how2idealizefreedom/electric-car-ball-balance/README.md

# 2026 全国大学生电子设计竞赛 H 题 · 车载平衡滚球运动控制系统

基于 **TI MSPM0G3507** 的竞赛项目：小车沿黑线循迹并计时返回起点，同时通过倾斜摆杆使钢球在平台上保持稳定或完成指定位移。

## 系统组成

```
┌────────────┐   UART    ┌──────────────┐  STEP/DIR  ┌─────────────┐
│  K230 视觉  │ ────────▶ │  MSPM0G3507  │ ─────────▶ │  A4988 + 42 │
│ (GC2093)   │  球位置/速度 │   主控/状态机  │            │  步进摆杆   │
└────────────┘            └──────┬───────┘            └─────────────┘
                                 │ PWM/IN/STBY
                        ┌────────▼─────────┐
                        │  D24A (TB6612×2) │ ──▶ 四轮差速底盘
                        └──────────────────┘
                        八路灰度循迹 · 四按键 · OLED · CH340 遥测
```

## 目录结构

```
.
├─ docs/                    文档与报告
│   ├─ 设计报告.pdf / .tex / .docx        正式设计报告
│   ├─ 当前算法说明_配图版.pdf
│   ├─ 电赛资料/              选拔赛设计报告、测试报告、仿真图
│   └─ dev-notes/             技术决策与开发记录（见下）
├─ firmware/                 CCS 固件工程（MSPM0G3507 + SysConfig）
│   ├─ H2_天猛星_路线记忆与步进/         当前主工程：循迹 + 示教回放 + 步进点动
│   ├─ H2_地猛星_循迹主线/               22:44 稳定 P1 基线与 P0~P2 测试文档
│   ├─ H2_地猛星_弯道测试/               内弯恢复实验副本
│   ├─ H2_天猛星_循迹备用/               天猛星 P1 迁移底座
│   ├─ H2_地猛星_球平衡步进/  H2_天猛星_球平衡步进/   A4988 安全 bring-up
│   ├─ 10_直流电机PID调速模板/ 11_PID循迹小车模板/     DriverLib 模板
│   └─ 4_地猛星_红外传感器测试/           四路/八路红外测试
├─ mechanical/               摆杆与舵机装配三维模型
├─ hardware/                 底盘、电机驱动、传感器、拓展板、PCB 资料
├─ tools/                    串口调试等辅助工具
├─ LICENSE                   MIT
└─ .gitignore
```

## 硬件平台

| 模块 | 型号 |
| --- | --- |
| 主控 | TI MSPM0G3507（天猛星 LQFP-64 / 地猛星 LQFP-48） |
| 电机驱动 | WHEELTEC D24A（板载 2× TB6612FNG） |
| 行走电机 | MG310 直流减速电机 + 霍尔编码器（13 PPR，1:20） |
| 循迹 | 8 路红外数字灰度板 |
| 摆杆执行 | 42BYGH23-A-21DH 两相四线步进 + A4988 恒流驱动 |
| 视觉 | 立创庐山派 K230-CanMV + GC2093 |
| 姿态 | MPU6050 |
| 显示 | 0.96 寸 OLED（I2C） |
| 调试 | CCS 20.5 + XDS110 + 板载 CH340（115200） |

## 固件说明

所有工程均为 TI MSPM0 SDK + SysConfig 的 CCS 工程，`empty.syscfg` 是唯一有效的引脚 / 外设配置源，**不要手改 SysConfig 生成的文件**。

主工程 `firmware/H2_天猛星_路线记忆与步进/`：

- 八路灰度加权误差 → 差速 PD 循迹；
- 首圈人工示教（K2/K3）+ RAM 路线记录，回放以记忆为主、P1 小纠偏；
- A4988 步进点动 / 加减速 / 软件限位 / HOME，默认上电强制禁能；
- 5 ms 控制节拍（TIMA0）+ 100 µs 步进节拍（TIMG8）；
- 100 ms 串口遥测 `T,S,M,E,L,R`。

## 文档索引

| 文档 | 内容 |
| --- | --- |
| `docs/dev-notes/开发记录与技术决策.md` | 题目指标、硬件清单与确认状态、引脚分配、供电与电平安全、循迹算法与参数、开发时间线、验证状态、已放弃方案、未解决问题、工程约束 |
| `docs/dev-notes/HARDWARE_INTEGRATION_AND_NEXT_STEPS.md` | 硬件集成接线结论、引脚预留、供电拓扑、第 3~6 问控制路线 |
| `docs/dev-notes/STEPPER_ARCHITECTURE_DECISION.md` | 步进摆杆执行机构选型决策、控制路线、机械建议 |
| `docs/dev-notes/DUAL_CCS_BUILD_STATUS.md` | 双平台构建状态 |
| `firmware/*/TIANMENG_WIRING_AND_TEST.md` 等 | 各工程接线与分阶段测试说明 |

> 文档中严格区分**已实车验证**、**已构建未实板**、**仅理论设计**、**未开始**四种状态，没有实测证据的内容不写成事实。

## 如何编译 / 运行

1. 安装 [Code Composer Studio](https://www.ti.com/tool/CCSTUDIO) 20.5 及以上版本与 MSPM0 SDK `2.11.00.07`。
2. `File → Import → CCS Projects`，选择 `firmware/` 下对应工程目录。
3. 按工程内的 `P0_TEST_GUIDE.md` → `P2_FINAL_LAP_TEST.md`（地猛星基线）或 `MEMORY_STEPPER_TEST.md`（天猛星步进）依次完成接线与分阶段测试。

**上电安全顺序**：先 MCU 单独上电并确认 STBY / ENABLE 安全电平 → 再接 A4988 → 最后接 D24A 并架空四轮。

## 说明

- 为控制仓库体积，视频（`*.mp4` 等）、压缩包与编译产物已被 `.gitignore` 排除，仅保留在本地。
- 本仓库用于学习与技术交流；竞赛作品知识产权归作者所有，转载请注明出处。
- 代码采用 MIT License，详见 `LICENSE`。
