how2idealizefreedom/electric-car-ball-balance/firmware/H1_H5_TIANMENG/README.md

# H1_H5_TIANMENG

本工程是立创·天猛星 MSPM0G3507（LQFP-64/PM）+ 外接 D24A 的 1—5 问集成工程。它独立于 `H2_LINE_CAR` 和 `H2_TIANMENG_MEMORY_STEPPER`，不会覆盖 22:44/P1 稳定基线。

## 当前原则

- 小车主控制仍为已获实车正反馈的八路循迹 P1/PD，不使用按时间分赛段，也不使用地图记忆回放。
- 上电默认进入 Q1；Q1 不使能 D24A 或 A4988，避免意外按键导致车辆启动。
- 逻辑 K4（模式键）现在使用扩展板板载 KEY2/PB11；每按一次按 Q1→Q2→Q3→Q4→Q5→Q1 切换，只允许在非运行状态切换。
- K1 启动/停止当前题目。Q1 再按一次正常结束；Q2—Q5 运行中再按一次进入故障安全停机。
- K2/K3 仅在 Q3 非运行状态下执行 A4988 ±20 微步维修点动；两键同时按关闭 A4988。
- A4988 的 10 kHz 中断只在确有步进运动时启用，空闲及 Q2 循迹时关闭；CONTROL_TICK 优先级 0，STEPPER_TICK 优先级 2。
- D24A电机映射为A=右后、B=右前、C=左前、D=左后。2026-07-31架空实测确认B/C向前而A/D反向，因此后轮A/D必须在控制端交叉IN1/IN2；不修改已经正确的左右侧软件方向极性。

## 各题当前状态

| 模式 | 目标 | 当前代码状态 | 是否允许执行器运行 |
|---|---|---|---|
| Q1 | 图像实时显示、记录与回放 | 状态机及串口事件已建立；K230 WiFi 图传由 K230 独立运行 | 小车/步进均关闭 |
| Q2 | 顺时针一圈、回 A 停车、计时 | P1 稳定循迹与 A 点横线停车逻辑已集成 | 允许，待天猛星实车验证 |
| Q3 | O→+5 cm→-5 cm，≤5 s | 顺序状态机与外环接口已写；视觉协议及机械标定未完成 | 当前 `BLOCKED` |
| Q4 | A→B，≤8 s，球保持 O±1 cm | 循迹+球外环调度已写；B 点判据未实现 | 当前 `BLOCKED` |
| Q5 | 一圈≤30 s，球保持 O±1 cm | 循迹+球外环+A 点停车调度已写 | 当前 `BLOCKED` |

Q3—Q5 的门控宏位于 `car_config.h`。禁止为了“先跑起来”直接改为 1；必须先实现对应驱动/协议并完成单模块验证。

## 显示屏状态

`display.c` 已实现 0.96 寸 SSD1306 128×64 I2C 后端。引脚按扩展板原理图使用 I2C0：PA28/SDA、PA31/SCL，SysConfig 配置为 400 kHz。上电会依次探测 7 位地址 `0x3C` 和 `0x3D`，成功后显示题号、题名、状态和时间；失败时保留串口提示，不阻塞小车状态机。2026-07-31 用户反馈第一次屏幕/模式键测试“完美”，因此这部分已有实板证据。

OLED 刷新被拆成每个 5 ms 控制周期最多发送一页（128 字节），不在一次控制周期内整屏阻塞发送。

## K230 串口状态

- 用户程序使用 K230 `GPIO3/UART1_TXD`、115200 8N1。
- 帧格式固定为 `$B,valid,x,err_x,vx,lost\n`；位置、误差为像素，速度为像素/帧。
- MSPM0 使用扩展板 UART1 四针座的 PB7/RX 接收；PB6/TX 保留但初测不连接。CH340 仍独占 UART0 PA10/PA11。
- UART ISR 只将单字节写入 128 字节环形缓冲；解析在 5 ms 控制任务执行。
- 原始遥测字段为 `K230/BV/BX/BE/BVX/BL/BSEQ`。尚未完成像素到毫米及像素/帧到毫米/秒标定，因此原始数据不会写入钢球位置外环。

## 构建结论

- CCS：20.5.0，TI Arm Clang 4.0.4.LTS
- MSPM0 SDK：2.11.00.07
- SysConfig：1.26.2+4477
- `check_syscfg.py`：通过；初次检查时因尚未构建而提示缺生成文件/输出文件
- `run_sysconfig.py`：通过；仅有 TIMA0 在 STOP/STANDBY 不保持寄存器的提示，本程序不进入这两种模式
- CCS 工程 `clean all`：通过，无编译器诊断
- 最终验证文件：`verified_build/H1_H5_TIANMENG.out`
- Flash：0x41E8（16872 B）；SRAM：0x8BC（2236 B，含 OLED 显存、UART缓冲和512 B栈）

以上仅表示静态检查和构建通过，尚未烧录，也没有天猛星实车验证。

## 关键文件

- `main.c`：Q1—Q5 状态机、P1 循迹、按键、计时、停车、遥测和按需步进中断
- `car_config.h`：稳定循迹参数、能力门控和待标定球控参数
- `empty.syscfg`：当前唯一引脚/外设配置源
- `a4988.h`：步进脉冲、速度斜坡、限位和点动底层
- `ball_feedback.*`：K230 ASCII帧环形缓冲、解析、原始像素数据快照，以及未来毫米标定后的球反馈接口
- `ball_controller.*`：球位置外环到摆杆角度/步数的接口；参数当前保持安全零值
- `display.*`：SSD1306 I2C 驱动、字库、分页刷新和应用显示接口
- `mpu6050.*`：已有基础探测驱动，默认不在启动时探测；当前与 OLED 共用 I2C0 实例名，但扩展板 MPU6050 实际 PA10/PA11 接法尚未并入
- `PHASED_TEST_PLAN.md`：接下来必须按顺序执行的测试

## 2026-08-01 球轴与视觉新增事实

- OpenMV 型号为 `OPENMVCAMH7PLUS / OpenMV Cam H7 Plus`，STM32H743，固件 4.7.0；当前程序使用 VGA 640×480、UART3/P4 TX、115200 8N1。
- 用户当前 OpenMV 脚本发送 `K230=1,BV=...,BX=...,BE=...,BVX=...,BL=...,BSEQ=...`。接收端现同时兼容该格式和原 `$B,V,X,E,VX,LOST` 格式，且像素范围扩展为 VGA。
- 初测比例为 26.5 px/cm，中心 `ZERO_X=320`；该值只作初始换算，必须完成 -5/0/+5 cm 三点复测后才能解除 `BALL_AXIS_CALIBRATED`。
- 球轴最低点暂定 HOME=0，实测水平点为 +320 微步。PB3 HOME 自动回零逻辑已预置，但 `A4988_AUTO_HOME_READY=0`，在开关和供电验证前不会上电运动。
- 扩展板原理图将板载 12 V→5 V 降压输出与主控 5 V 母线直接连接，未显示USB与电池5 V之间的隔离。调试时禁止把两路5 V长期并联；必须先解决电池冷启动和电源开关不稳定。
