how2idealizefreedom/electric-car-ball-balance/firmware/H2_地猛星_循迹主线/HARDWARE_NOTES.md

# D24A 与 MSPM0G3507：P0 接线结论

## 当前供电接法

以下拓扑可用于桌面开发：

```text
电脑 USB ──> MSPM0G3507 开发板

12 V 锂电池 + ──> D24A Vin+
12 V 锂电池 - ──> D24A - / GND

MSPM0 GND ──────> D24A GND
```

必须遵守：

- MSPM0 由 USB 供电时，D24A 的 `5V` 和 `3V3` 输出均不要接到 MSPM0 的电源针脚，防止两个电源互相倒灌。
- 共地线必须连接，但电机大电流回路应直接回到电池负极；不要让电机电流经过面包板或 MCU 的细地线。
- 首次测试先断开四个电机插头或架空四轮，D24A 开关保持 `OFF`，`STBY` 保持低电平。
- 当前测得电池电压为 `12.14 V`；低于 TB6612 推荐 VM 上限 `13.5 V`。仍需注意电机制动产生的母线尖峰。
- D24A 板载 `5V-GND`、`3V3-GND` 已由万用表确认输出正常，但尚未记录精确电压值。

## 为什么控制线暂时不能直连

D24A 原理图显示两颗 TB6612 的 `VCC` 接板载 `5V`。TB6612 数据手册规定控制输入高电平最小值为 `0.7 * VCC`，在 VCC=5 V 时即 3.5 V。MSPM0 的 3.3 V 输出低于这个保证值。

正式控制线需要 13 路 3.3 V -> 5 V 转换：

- `STBY`
- `AIN1/AIN2/PWMA`
- `BIN1/BIN2/PWMB`
- `CIN1/CIN2/PWMC`
- `DIN1/DIN2/PWMD`

合计为 13 路（1 + 4 x 3），因此可选用两片 8 路、5 V 供电且输入具有 TTL 阈值的缓冲器/总线收发器，例如合适封装的 `74AHCT541` 或 `74HCT245`。器件的方向/使能脚必须固定到正确状态，不能悬空。购买前把具体模块链接或数据手册发来核对。

用户描述的“12 V 输入、输出 0～12 V 可调”模块属于 DC-DC 降压电源，只能用于产生稳定电源，不能转换数字逻辑电平，也不能接到 `PWM/IN/STBY/Encoder` 信号线上。

## 编码器线也需先确认

D24A 的四个电机插座向霍尔编码器提供板载 `5V`，并引出 `E1A/E1B ... E4A/E4B`。在没有确认霍尔输出结构前，不得把这些信号直接接 MSPM0：

- 如果是 5 V 推挽输出，需要 5 V -> 3.3 V 转换；
- 如果是开漏/开集输出，可考虑上拉到 3.3 V，但必须先由手册或万用表验证；
- 如果编码器本身允许 3.3 V 供电，仍需按电机资料确认最低工作电压和输出波形。

当前电机资料：`MG310`，霍尔编码器允许 `3.3 V` 或 `5 V` 供电，标称 `13 PPR`，减速比 `1:20`。如果 13 PPR 指电机轴单通道脉冲数，则输出轴每转：

- 单通道单边沿约 `13 x 20 = 260` 个计数；
- A 相双边沿约 `520` 个计数；
- A/B 完整四倍频约 `1040` 个计数。

供应商的 PPR 口径可能不同，最终必须用“车轮手动转一整圈”的实测计数标定，不能仅凭 13 PPR 写死里程系数。

为了避免 5 V 编码器信号进入 MCU，优先方案是将四个编码器供电改为 3.3 V，再确认 A/B 高电平不超过 3.3 V。D24A 电机插座的编码器电源脚在原理图上固定为 5 V，因此若采用此方案，需要把线束中的编码器 VCC 脚单独退针/改线到 3.3 V，不能把 D24A 的 5 V 与 3.3 V 短接。

## 八路灰度输入

- 模块可使用 3.3 V 或 5 V 供电；本项目固定优先使用 `3.3 V`，降低 MCU 输入过压风险。
- 最新逐项直接测试确认模块为 **白底低、黑线高**。先前根据运动过程中的 `M=231` 位型反推极性，因当时探头覆盖场景不明确而作废。
- 固件不取反，内部位图和串口 `M` 始终保持 `1=黑线`；白底应为 `M=0`，中央 S4/S5 压线应为 `M=24`。
- 连接 MCU 前仍应确认八个输出通道的高电平不超过 3.3 V。

## 已确认的电机位置映射

| D24A 通道 | 车辆位置 | 逻辑分组 |
|---|---|---|
| Motor A | 右后 RR | 右侧 |
| Motor B | 右前 FR | 右侧 |
| Motor C | 左前 FL | 左侧 |
| Motor D | 左后 RL | 左侧 |

## 下一批需要的资料/实测

1. MG310 的购买链接或完整数据页，补充额定电压、额定/堵转电流，以及“13 PPR”是单通道、双边沿还是四倍频口径。
2. 编码器 A/B 输出电路类型（推挽或开漏）；若没有资料，按下文要求实测输出。
3. 拟购买的真正逻辑转换模块链接或清晰正反面照片。常见 BSS138 I2C 小板和可调降压模块均不适合本项目的电机控制信号。
4. 灰度板八个数字输出在白底和黑线上的逐通道检查结果。
5. 开发板完整原理图或电源说明，用来确定脱离电脑后应从 5 V 针脚还是其他入口供电。
