how2idealizefreedom/electric-car-ball-balance/hardware/天猛星拓展板/（首先看这里）文件说明.txt

01：原理图；
02：平面图
03：PCB图
04：Gerber.zip 嘉立创打板文件
使用方法：在嘉立创下单助手上导入，自主下单，2层板，10cm*10cm（下单文件 不能导入嘉立创EDA）
照着物料清单在淘宝上购买器件。

04：源文件，嘉立创专业版导入，导入！！！！（PLUS款才有，基础款没有，需要去咸鱼搜索：遇到困难睡大觉zxz 购买正版源文件，可提供售后指导及详细使用和修改指导）（需要售后服务的在咸鱼购买后主动将微信发给我，在微信售后（方便一些））
