how2idealizefreedom/electric-car-ball-balance/firmware/H2_地猛星_球平衡步进/BALL_CONTROL_INPUTS_NEEDED.md

# 第三至第六问：滚球控制接入清单

## 已确认舵机

- 型号：MG996R，180 度位置舵机。
- 供电：4.8～6.6 V；棕线 GND、红线电源正、橙线 PWM 信号。
- 控制：50 Hz，周期 20 ms；资料给出的脉宽范围为 0.5～2.5 ms，中位约 1.5 ms。
- 暂定信号引脚：PA27（可分配独立定时器 PWM），最终仍以加入摄像头、显示屏和按键后的 SysConfig 无冲突验证为准。

## MG996R 供电要求

不要从 MSPM0 开发板的 5 V 或 3.3 V 引脚给 MG996R 供电。建议链路：

`12 V 电池 -> 独立降压模块（调到 5.5～6.0 V）-> MG996R 红线`

- 降压模块建议至少能承受 3 A 连续、5 A 瞬时电流，并在输出端就近放置 470～1000 uF 电解电容和 0.1 uF 陶瓷电容。
- 舵机棕线、降压模块负极、D24A GND、MSPM0 GND 必须共地。
- 舵机橙线只接 PWM 信号，不接电源。正式接入前先卸下舵盘或断开连杆，验证 1.5 ms 中位不会撞机械限位。
- 3.3 V PWM 多数 MG996R 可识别，但不同批次不应盲目保证；若已有 74HCT125 等非反相 TTL 缓冲器，可用于输出 5 V 控制电平。使用 74HCT14 时需要串联两个反相门，不能只过一个门。

## 仍需你提供的资料

1. 舵机降压模块正反面照片、芯片丝印、额定/峰值输出电流，以及空载调到的实际输出电压。
2. 实物机构侧视图：舵机轴、舵盘孔位、连杆两个转轴和摆杆铰链都要清楚；同时量出舵盘有效半径、连杆孔距、摆杆铰链到驱动点距离。
3. 摆杆水平时的舵机大致角度，以及机构允许的最小/最大角度；不要通电硬顶限位。
4. 钢球位置摄像头/图传模块的准确型号、接口、供电和资料。滚球闭环必须由摄像头实时给出钢球坐标，单靠舵机开环达不到 ±1 cm。
5. 不大于 2 英寸显示屏的型号、控制器、接口和引脚图。
6. 准备使用的按钮数量；建议 START/STOP、MODE、PLUS、MINUS 四个。

## 后续控制结构

摄像头计算钢球相对目标位置的误差，通过 UART 周期性发给 MSPM0。MSPM0 在固定周期执行滚球位置 PID/状态反馈，输出 MG996R 的目标脉宽并限制角度、速度和加速度。第三问按 `0 cm -> +5 cm -> -5 cm` 状态机运行；第四、五问目标固定为 0 cm；第六问目标由按键选择并显示。

MPU6050 只能用于补偿车体加速度和摆杆姿态，不能代替题目明确要求的摄像头钢球位置检测。
