how2idealizefreedom/electric-car-ball-balance/docs/dev-notes/CODEX_THREAD_HANDOFF.md

# CODEX 线程项目交接材料

> 生成时间：2026-07-31（本线程结束时）。
>
> 本文只整理本线程的用户陈述、工程文件、构建记录和串口/实车反馈。`已实车验证`、`已构建`、`已设计`、`TBD` 严格分开；没有证据的内容不写成事实。本文件不替代题目、器件数据手册或现场安全检查。

## 1. 项目背景与竞赛任务

- 题目：2026 年“车载平衡滚球运动控制系统”H 题。
- 当前第一优先级曾明确为第 2 问：小车置于 A 点，按键启动，沿黑线顺时针行驶一圈，回到 A 点自动停车、停止计时并显示总时间。硬指标为总时间 `<=20 s`、停车偏差 `<=2 cm`。
- 赛道参数来自根目录 `AGENTS.md` 对题目 PDF 的摘录：黑线宽 `1.8±0.2 cm`；AB、CD 直线各 `1.5 m`；BC、DA 为半径 `0.5 m` 的半圆；A 点启停线长 `5 cm`；车辆最大外形 `35 cm × 25 cm`；显示屏不得大于 `2 英寸`。中心线路程估算约 `6.14 m`。
- 后续第 3～6 问的用户截图要求包括：摆杆将小球在中心 O 与 `±5 cm` 间运动并稳定；经 B 点/一圈过程中钢球稳定在中心或指定位置附近，误差绝对值 `<=1 cm`，有关行驶项目时间上限为 `8 s` 或 `30 s`（以题目原文为最终准则）。
- 当前实际工作方向已从地猛星切换为：**天猛星 MSPM0G3507 + 外接 D24A + 八路灰度 + 42 步进/A4988 预留**。用户明确表示放弃继续调试地猛星的 curve 版本。

当前已知平台：

- 主控：立创·天猛星 MSPM0G3507，当前有效工程声明 `LQFP-64(PM)`。
- 底盘：四轮直流电机小车，D24A 四路 TB6612 驱动板，八路红外灰度循迹板。
- 调试：CCS、XDS110、板载 CH340 串口（115200）。
- 后续球控：K230-CanMV + GC2093 摄像头、Wi-Fi/MJPEG 手机浏览器图传、0.96 英寸屏、MG996R 舵机方案曾安装；当前尝试 42BYGH23-A-21DH + A4988 方案。

## 2. 总体技术思路

系统应拆成下列可独立验证的部分；其中标为“设计”的项目不代表已完成。

| 子系统 | 目标与思路 | 当前状态 |
|---|---|---|
| 循迹小车 | 八路传感器读出黑线位图，按加权误差进行左右差速 PD；在当前天猛星新工程中另加首圈示教/时间回放与 P1 小纠偏。 | 地猛星 P1 曾实车可循迹；天猛星记忆版仅构建。 |
| 四电机驱动 | D24A 的 A+B 作为右侧组、C+D 作为左侧组；两侧同 PWM/方向组控制。 | D24A 与分组定义、早期车轮方向测试有实测反馈；天猛星接线尚待实板。 |
| 红外循迹 | 传感器以 1 表示黑线；S1～S8 加权得到误差。 | 白底/黑线极性用户已直接实测；天猛星引脚已配置但未实板。 |
| 编码器与轮速闭环 | 未来读取霍尔 A/B，标定每轮计数，左右轮速 PI 抵抗电压和负载变化。 | 未接入当前有效代码；计数口径、输出电平、轮速 PI 均 TBD。 |
| A 点识别与停车 | 宽黑线候选 + 起点离开/最短运行时间门控 + 短刹/禁能；以后应叠加里程或航向。 | 22:44 基线源码已实现简化宽线检测、最短 6 s、220 ms 短刹；停车误差未达标证明。 |
| 显示与计时 | 车载屏实时/锁存显示时间、状态。 | 0.96 寸屏已提供照片；未接线、未写驱动。 |
| 摆杆执行机构 | 通过舵机或步进电机改变摆杆姿态。当前步进方案应先 HOME、点动、标定机构几何。 | MG996R 方案存在；42BYGH23 + A4988 的点动代码已构建，未实板。 |
| 钢球视觉检测 | K230 采集 GC2093 图像，提取钢球中心、相对位置/速度，向 MSPM0 发送 TTL UART 数据。 | 用户称 Wi-Fi 图传已跑通、K230 方案已能输出小球位置/速度；实际 UART 数据帧和 MSPM0 接收未实现。 |
| 钢球位置外环 PID | K230 的球位置/速度形成外环，输出摆杆目标；步进/舵机形成内层执行。 | 仅理论路线，未实现。 |
| 图传与录像 | K230 通过 RTL8189FTV 接 2.4 GHz 手机热点，MJPEG 浏览器显示/手机录屏。 | 用户称已跑通；未在本工程验证。 |
| 最终合并 | 先稳定底盘/停车，再独立摆杆 HOME 与闭环，再合并视觉球控；合并时限制执行器、掉线安全停机。 | 未开始。 |

## 3. 开发环境与工程结构

### 已观察到的开发环境

| 项目 | 实际记录/路径 | 状态 |
|---|---|---|
| CCS | `G:\ti\ccs2050\ccs`；文档中记录为 CCS 20.5。 | 本地安装路径已用于编译器。 |
| MSPM0 SDK | `C:\TI\mspm0_sdk_2_11_00_07`，版本 `2.11.00.07`。 | SysConfig/编译记录已使用。 |
| SysConfig | `C:\TI\sysconfig_1.26.2\sysconfig_cli.bat`，版本 `1.26.2+4477`。 | 当前天猛星工程检查通过。 |
| TI Arm Clang | `G:\ti\ccs2050\ccs\tools\compiler\ti-cgt-armllvm_4.0.4.LTS\bin\tiarmclang.exe`。 | 当前天猛星记忆工程已编译链接。 |
| XDS110 | `targetConfigs\MSPM0G3507.ccxml` 声明 TI XDS110。 | 未在本次天猛星记忆工程执行探针/烧录。 |
| 串口 | 板载 CH340，当前天猛星 SysConfig 为 UART0：PA10 TX、PA11 RX、115200。 | 地猛星阶段用户已使用 CH340 观察串口；天猛星记忆版尚未实板。 |

### 主要目录

| 路径 | 角色 |
|---|---|
| `outputs/H2_TIANMENG_MEMORY_STEPPER/` | 当前应优先继续的天猛星一体化 CCS 工程。 |
| `outputs/H2_LINE_CAR/` | 地猛星 LQFP-48 的 22:44 左右 P1 稳定基线与历史测试文档；用户已放弃作为当前硬件路线。 |
| `outputs/H2_LINE_CAR_CURVE_TEST/` | 地猛星内弯恢复/强制找线实验副本；未宣称实车通过。 |
| `outputs/H2_LINE_CAR_TIANMENG/` | 天猛星 P1 迁移底座，未实板。 |
| `outputs/H2_LINE_BALL_STEPPER_DIMENG/`、`outputs/H2_LINE_BALL_STEPPER_TIANMENG/` | A4988 早期安全 bring-up 工程，历史参考。 |
| `outputs/*.zip` | 历史工程压缩包，非当前源码真源。 |
| `work/` | 临时 SysConfig/本机构建工作目录，不是 CCS 工程交付真源。 |
| `outputs/H2_TIANMENG_MEMORY_STEPPER/Debug/` | 从底座复制的旧生成产物，含旧工程名 `.out`；文档明确禁止烧录这些旧 `.out`。 |
| `outputs/H2_TIANMENG_MEMORY_STEPPER/verified_build/` | 由本线程命令行验证产生的当前 `.out/.map`，不是 CCS IDE 自动生成目录。 |

### 当前天猛星工程关键文件

| 文件 | 作用 |
|---|---|
| `empty.syscfg` | 唯一有效的引脚/外设配置源。 |
| `main.c` | 车辆状态机、P1、示教/回放、按键、串口遥测。 |
| `car_config.h` | 当前天猛星记忆/步进参数。 |
| `track_memory.c/.h` | RAM 路线记录与读取。 |
| `a4988.h` | A4988 脉冲、加减速、位置/HOME 限制。 |
| `mpu6050.c/.h` | MPU6050 底层文件；`MPU6050_BOOT_PROBE=0`，启动不探测。 |
| `TIANMENG_WIRING_AND_TEST.md` | 天猛星/D24A/灰度/按键接线说明。 |
| `A4988_WIRING_AND_TEST.md`、`MEMORY_STEPPER_TEST.md` | A4988 与示教回放分阶段测试。 |
| `BUILD_STATUS.md` | 静态检查/构建结论及旧 Debug 警告。 |

## 4. 已确定的硬件

| 器件 | 型号/描述 | 用途 | 电压/接口 | 当前确认状态 | 尚未确认的信息 |
|---|---|---|---|---|---|
| 主控开发板 | 天猛星 MSPM0G3507，当前工程为 LQFP-64(PM) | 现行主控 | GPIO、UART0、I2C0、TIMG0/TIMA0/TIMG8 | 工程 `empty.syscfg` 已配置；未对当前工程实板。 | 天猛星最终脱机供电与扩展板全部接线的实测。 |
| 历史主控 | 地猛星 MSPM0G3507，LQFP-48(PT) | 旧基线 | 同芯片不同板级引脚 | 用户纠正过 PA14 板载 LED；该路线已放弃。 | 不应再作为当前引脚依据。 |
| 四路驱动板 | WHEELTEC D24A，板上两颗 TB6612FNG | 驱动四轮、提供编码器接口/稳压输出 | Vin 5.5–15 V（文档摘录）；PWM/IN/STBY | 用户测 12 V 电池 12.14 V；D24A 5 V-GND、3V3-GND“正常”；四电机接法已提供。 | 3.3 V GPIO 到 5 V 逻辑的可靠性结论存在冲突，见第 15 节；天猛星实接未验证。 |
| 行走电机/编码器（早期资料） | MG310，霍尔编码器，PPR 13、减速比 1:20 | 四轮行走与未来速度反馈 | 编码器称可 3.3/5 V | 用户提供的文字信息。 | 与后续 MG513XP28_12V 标签冲突；电机额定/堵转电流、PPR口径、输出结构未确认。 |
| 行走电机（后续照片） | WHEELTEC `MG513XP28_12V` | 照片中的带编码器电机 | 12 V 标签；6P线束 | 用户上传照片有该丝印。 | 是否替代 MG310、减速比、PPR、电平未确认。 |
| 灰度模块 | 8 路红外数字循迹板，准确商家型号未知 | 黑线检测 | 采用 3.3 V供电；8 GPIO | 用户直接测试：白底输出 0、黑线 3.3 V；白底 M=0、S4/S5 黑线 M=24。 | 探头间距、完整数据手册、各通道高电平实测未存档。 |
| CH340 | 天猛星板载 USB-UART | 串口调试 | UART0 PA10/PA11，115200 | 地猛星阶段用户能看到串口；天猛星工程已配置。 | 天猛星当前 USB 串口端口号/实测输出。 |
| XDS110 | 外置下载器 | SWD 下载/调试 | ccxml 指向 TI XDS110 | 用户拥有；工程目标配置存在。 | 当前天猛星实际连接/探针枚举未记录。 |
| 舵机 | MG996R | 早期摆杆方案 | 4.8–6.6 V，PWM约20 ms | 用户提供参数、已安装过舵机/机构。 | 舵机降压模块、电流、机械零位、连杆几何、最终是否弃用。 |
| 步进电机 | `42BYGH23-A-21DH`，NEMA17 类四线双极型推定 | 当前替代摆杆执行器候选 | A4988恒流驱动 | 用户测两组线圈各约4.1 Ω；已有 A4988 照片；已有 STEP/3MF 机构文件。 | 额定相电流、实际机构负载、最终步距/微步与杆端位移关系、HOME。 |
| 步进驱动 | A4988 小板，照片见 R100 | 驱动42步进 | VMOT 12 V、VDD 3.3 V、STEP/DIR/EN | 安全点动软件/接线文档已写、编译。 | VREF未实调、散热/限流/点动未实板。 |
| 摄像头/视觉板 | 立创·庐山派 K230-CanMV + GC2093（CSI2） | 球心检测、图传 | K230 逻辑 5 V；对 MSPM0 拟用 3.3 V TTL UART | 用户称 K230 Wi-Fi 图传已跑通，能给球位置/速度。 | UART 帧格式、速率、MSPM0 收发引脚、球检测精度/延迟未确认。 |
| Wi-Fi/录像 | RTL8189FTV、手机热点、浏览器 MJPEG、手机录屏 | 图传/录像 | 2.4 GHz | 用户陈述已跑通。 | 未在工程文件中集成。 |
| 显示屏 | 0.96 英寸 OLED（照片丝印 SMD?，控制器不明） | 比赛显示时间/状态 | TBD（通常 I2C 仅为常识，不作为结论） | 用户提供照片，尺寸符合 <=2英寸。 | 控制器、针脚、供电、实际接口、代码未确认。 |
| 按键板 | 4个轻触按键 K1–K4，共 GND | 启动/辅助/模式 | 低有效、每键有0.1uF（用户原理图） | 用户提供实物和原理图；当前天猛星已为 K2/K3/K4配 GPIO。 | 尚未按当前引脚完成实接。 |

## 5. 固定引脚与外设分配

本节只以当前有效 `outputs/H2_TIANMENG_MEMORY_STEPPER/empty.syscfg` 和该目录参与构建的 `main.c/a4988.h/car_config.h` 为主。除表中“保留”外，未列 GPIO 均不应自行占用。

| 类别 | 天猛星管脚/外设 | 功能 | 事实来源 |
|---|---|---|---|
| LED | PB22 | `STATUS_LED`，高有效，待机/运行状态 | `empty.syscfg` GPIO1；`main.c` |
| D24A STBY | PB15 | `DRV_SAFE.STBY`，初值低；`motor_coast_disable()`清低、`motor_drive()`置高 | `empty.syscfg` GPIO2；`main.c` |
| 右侧方向 | PB17、PB19 | `RIGHT_IN1/RIGHT_IN2`，D24A A+B 右侧组 | `empty.syscfg` GPIO3；`TIANMENG_WIRING_AND_TEST.md` |
| 左侧方向 | PA16、PB24 | `LEFT_IN1/LEFT_IN2`，D24A C+D 左侧组 | `empty.syscfg` GPIO3；`TIANMENG_WIRING_AND_TEST.md` |
| 右 PWM | PA12 / TIMG0 CCP0 | `MOTOR_PWM.RIGHT_PWM`，20 kHz，通道 0 | `empty.syscfg` PWM1；`main.c` |
| 左 PWM | PA13 / TIMG0 CCP1 | `MOTOR_PWM.LEFT_PWM`，20 kHz，通道 1 | `empty.syscfg` PWM1；`main.c` |
| 灰度 S1–S8 | PB5、PB16、PB12、PB13、PB23、PB26、PB27、PB25 | 车头向前、由左到右 S1–S8；软件 `1=黑线` | `empty.syscfg` GPIO4；`main.c` `line_read()` |
| K1 | PB21 | 板载 `START_STOP`，内部上拉、按下低；启动/停止 | `empty.syscfg` GPIO5；`main.c` |
| K2 | PA26 | 低有效 `TEACH_KEYS.LEFT`；运行时人工左转，待机时步进 -20 | `empty.syscfg` GPIO7；`main.c` |
| K3 | PA27 | 低有效 `TEACH_KEYS.RIGHT`；运行时人工右转，待机时步进 +20 | 同上 |
| K4 | PB9 | 低有效 `TEACH_KEYS.MODE`；待机切换 TEACH/REPLAY | 同上 |
| A4988 STEP | PA22 | STEP，初值低 | `empty.syscfg` GPIO6；`a4988.h` |
| A4988 DIR | PA24 | DIR，初值低 | 同上 |
| A4988 ENABLE | PA25 | ENABLE，低有效；SysConfig 初值高（禁用） | 同上 |
| A4988 HOME | PB8 | 输入上拉；闭合到 GND 表示 HOME | 同上 |
| MPU6050 I2C | PA0=SDA、PA1=SCL / I2C0 | 扩展板 MPU接口预留 | `empty.syscfg` I2C1；`mpu6050.c/.h` |
| 调试 UART | PA10=TX、PA11=RX / UART0 | CH340，115200、FIFO | `empty.syscfg` UART1；`main.c` |
| 控制节拍 | TIMA0，5 ms，ZERO IRQ | `CONTROL_TICK_INST_IRQHandler` 只累加节拍 | `empty.syscfg` TIMER1；`main.c` |
| 步进节拍 | TIMG8，100 us，ZERO IRQ | `STEPPER_TICK_INST_IRQHandler` 调用 `a4988_timer_isr()` | `empty.syscfg` TIMER2；`main.c` |
| 禁止占用 | PA19/PA20 | SWD | `H2_TIANMENG_MEMORY_STEPPER/AGENTS.md` |
| 禁止占用 | PA2、PA18、PA21、PA23 | 项目规则明确禁止作为普通 GPIO | 同上 |
| 保留 | PA0/PA1、PA10/PA11、PB21/PB22 | 分别留给 MPU、CH340、板载按键/LED | 同上和 `empty.syscfg` |
| TBD | 编码器、OLED、K230 UART、正式 HOME | 当前有效 SysConfig 无分配 | `empty.syscfg`；用户未给出最终连接确认 |

## 6. 供电和电平安全结论

### 已实测/用户直接确认

- 电池满电测得约 `12.14 V`。
- D24A `5V-GND`、`3V3-GND` 被用户万用表测为“正常”，未保存精确数值。
- 用户已进行“电脑供电、车轮架空”的电机试验，CH340 有串口数据。
- 灰度模块可按 3.3 V 供电，用户测得白底数字输出 0 V、黑线约 3.3 V。
- 系统必须共地：MCU GND 与 D24A GND 已被作为接线要求反复确认。

### 原理图/数据表或工程文档结论

- 调试拓扑：电脑 USB 给 MCU/CH340 供电；12 V 电池给 D24A `Vin+/-` 与电机功率；MCU 与 D24A **只做信号地共地**。`outputs/H2_LINE_CAR/POWER_AND_D24A_WIRING.md` 记录：USB 给 MCU 时不得把 D24A 5 V/3.3 V 输出并接 MCU 电源，避免倒灌。
- 脱机供电：旧地猛星文档依据其原理图写过“拔掉电脑 USB 后可由 D24A 5 V给开发板+5V”，但当前主控已换天猛星；该结论不能直接迁移，当前天猛星脱机电源入口为 **TBD**。
- MG996R 工作电压用户提供为 4.8–6.6 V。它不能从 MSPM0 3.3 V或 MCU USB 细供电线取功率；需独立足够电流的 5–6 V 降压，且与 MCU 共地。这是原器件参数和电源安全推论，未实接验证。
- 42BYGH23 不能由 MCU GPIO 或普通降压模块直接驱动；当前设计通过 A4988 恒流斩波驱动，逻辑 VDD=3.3 V、VMOT=12 V，VMOT 旁需至少100 uF 电容，所有地共地。A4988接线/限流属于已写设计，未实测。
- 初次执行器测试顺序已写入 `MEMORY_STEPPER_TEST.md`：先 MCU 单独上电、验证 PB15/PA25 安全电平，再单独接 A4988，最后才接 D24A并架空四轮。

### TB6612 5 V逻辑与 3.3 V MSPM0：存在冲突，不能自行定案

- 旧地猛星文档 `POWER_AND_D24A_WIRING.md` 依据其对 D24A 原理图/手册的解读，认为 TB6612 VCC=5 V、保证 VIH=0.7×VCC=3.5 V，因此建议 74HCT/74AHCT 缓冲，且禁止把可调 DC-DC 当成电平转换。
- 当前天猛星文档 `TIANMENG_WIRING_AND_TEST.md` 写为“TB6612FNG 控制高电平门限低于 3.3 V，MSPM0 可直接驱动，无需 HCT”。
- 两者相互矛盾，且没有本线程中“天猛星 3.3 V直连 D24A 在噪声/温度下可靠”的实测记录。后续必须以 D24A 所用 TB6612FNG 原始数据表版本、实际 VCC、以及示波/实测为准；不得把任一文档的结论当作已实板定案。

### 编码器电平风险：尚待确认

- D24A 编码器插座可提供 5 V。若霍尔 A/B 是 5 V推挽输出，不能直接进 MSPM0；若开漏且可上拉到3.3 V才可能安全。旧文档建议先确认输出结构或把编码器 VCC 单独改为3.3 V，但这未实做。
- 用户给出 MG310“编码器 3 或5 V、13 PPR、1:20”，后续照片又为 MG513XP28_12V，因此每轮计数、PPR定义、编码器输出电平都仍是 TBD。

## 7. 循迹控制开发时间线

下表以本线程顺序和现存文档为据；“构建通过”不等于“烧录或实车通过”。

| 阶段/版本 | 修改内容与原因 | 构建结果 | 实车/串口结果 | 是否保留 |
|---|---|---|---|---|
| P0 安全固件（地猛星） | 初期以错误板型/LED配置开始，后用户纠正为地猛星：PA14 LED、PB24 STBY；要求复位安全禁能。 | `H2_LINE_CAR/BUILD_STATUS.md`记录 SysConfig、clean all、TI Arm Clang通过。 | 用户报告 P0 四项完成；曾报告 PB22不闪、PB24约0 V，后纠正板载LED应为PA14。 | 地猛星历史基线保留。 |
| 板型纠正 | 从误用天猛星/LQFP64/PB22，改为当时实际地猛星 LQFP48/PA14；PA10/11给CH340。 | 地猛星P0/P1编译记录存在。 | 用户确认地猛星板载LED是PA14。 | 对地猛星有效；当前已切天猛星。 |
| CH340/八灰度接入 | 使用115200串口，读取8位灰度。 | P1编译通过。 | 用户成功得到如`T=...,M=...`串口；白底/黑线极性随后直接测试。 | 逻辑保留为 P1 基础。 |
| 灰度极性纠正 | 早期根据运动日志把黑白推反；用户直接测得白0、黑3.3V，白底 M=0、S4/S5黑线 M=24，改为`LINE_BLACK_IS_HIGH=1`。 | 改后构建通过。 | 用户直接实测支持。 | 保留。 |
| 四轮方向/后轮问题 | 用户架空测试：前轮向前、后轮向后；先建议换动力线，用户调换左右后轮后仍反；后续在文档记录了方向扇出交叉接法。 | 多次修改后清理/编译通过，具体每个二进制版本未逐一存档。 | 用户后续发现曾有线松，重连后可走直线；方向问题不能只凭日志推测。 | 方向配置必须以当前天猛星实测重做。 |
| PWM 下降 | 空载“观感很快”，地猛星直线PWM从约35%降为22%、上限35%。 | `H2_LINE_CAR/BUILD_STATUS.md`记录clean all通过。 | 用户曾说稳定、转弯慢但可稳定；未记录完整圈成绩。 | 22:44基线参数保留。 |
| 2026-07-29约22:44稳定版 | P1 PD、220/190/160、55/150搜索、400ms故障、6s宽线终点、220ms短刹。 | `H2_LINE_CAR`有`Debug/H2_LINE_CAR.out`及构建状态。 | 用户明确称“稳定，转弯比较慢但是可以稳定”，并要求回退到此版本。 | **认可为地猛星稳定基线**；不能覆盖。 |
| PWM渐变/内轮限制/激进找线等后续修改 | 为提高速度/内弯能力，曾加入启动斜坡、内轮最低PWM、强制找线、极性/方向修改等。 | 有些版本构建通过。 | 用户反馈直线突然加速、抽搐，内弯切线冲出/很快丢线，甚至全白地逆时针转圈后停。 | 已撤销或隔离到实验副本。 |
| `H2_LINE_CAR_CURVE_TEST` | 从22:44复制，仅把丢线改两段：3/18%再0/26%，故障1100ms，加入全白启动拒绝/丢线事件。 | 文档记录构建通过。 | 文档明确“未烧录，未声称实车通过”。 | 仅实验历史，不作为当前稳定版。 |
| TRACK（按时间划分赛段）/长按启动方案 | 曾提出按时间划分直线/弯道、短按切模式/长按启动，以解决赛段。 | 本线程未找到可确认的当前有效源码/实测证据。 | 用户反馈“长按启动和只能转弯”等问题，最终要求不要走该方向。 | 撤销；不得恢复为主控制。 |
| 回退稳定版 | 用户要求回退到22:44“完美代码”，因为后续版本直线不匀速/冲出。 | `H2_LINE_CAR/P2_FINAL_LAP_TEST.md`记录回退事实。 | 用户随后确认稳定但转弯慢。 | 地猛星历史基线。 |
| 天猛星P1迁移 | 基于稳定P1新建 LQFP64 天猛星外接D24A版，PB22 LED、PB15 STBY。 | `H2_LINE_CAR_TIANMENG/BUILD_STATUS.md`记录构建。 | 未实板。 | 作为天猛星底座保留。 |
| 天猛星记忆+A4988 | 首圈P1+人工K2/K3示教，40ms RAM记录；回放以记忆为主、P1小纠偏；步进点动。 | `H2_TIANMENG_MEMORY_STEPPER/BUILD_STATUS.md`：check/run SysConfig、TI Arm Clang链接通过，`verified_build`有out/map。 | 未烧录、未天猛星实板。 | 当前待测试工程。 |

## 8. 当前稳定循迹算法

这里的“当前认可稳定”特指用户要求保留的**地猛星 2026-07-29约22:44 P1 基线**，文件为 `outputs/H2_LINE_CAR/main.c` 和 `car_config.h`。它不是当前天猛星记忆工程的实车验证结论。

### 算法事实

- 传感器定义：`LINE_BLACK_IS_HIGH=1`；`line_read()`将 S1~S8组合为位图，`1=黑线`。用户实测白底应为 `M=0`，中央 S4/S5黑线为 `M=24`。
- 权值：S1～S8分别为 `-350,-250,-150,-50,50,150,250,350`。
- 误差：所有激活传感器权值的算术平均；没有激活传感器则认为丢线。
- PD：`turn = error*0.7 + (error-lastError)*1.8`，再限幅到 `±400`。
- 基础PWM：绝对误差 `<=150` 用220；`150<|E|<=250` 用190；`|E|>250` 用160。PWM单位为千分比，范围0–1000，最终限制为350。
- 差速：`left=base+turn`，`right=base-turn`；方向控制函数决定正负。方向极性只应依据实际架空/落地测试确定。
- 丢线：按最后误差方向执行`55/150`差速搜索，连续400ms丢线后`STATE,FAULT,LINE_LOST`。
- A点：源码实现不是名为`LAP_ARMED`的状态，而是 `g_leftStartLine`：先见到非宽线后置真；运行至少6000ms，之后连续4个5ms控制周期（约20ms）出现 >=6路黑线，即进入`CAR_BRAKE`。
- BRAKE：`motor_short_brake()`将四个方向输入置高、PWM写1000，维持220ms；随后`motor_coast_disable()`，输出`STATE,FINISHED`。
- 计时：`g_runMs`在5ms控制步进中累加；进入刹车锁存`g_finishMs=g_runMs`，完成时加220ms后输出。
- 遥测：每100ms输出 `T,S,M,E,L,R`，含运行时间、状态、位图、上次误差、左右命令。

### 稳定基线参数

| 参数 | 数值 | 来源 | 证据等级 |
|---|---:|---|---|
| 控制周期 | 5ms | `H2_LINE_CAR/car_config.h` | 源码存在，地猛星实车曾用。 |
| 遥测周期 | 100ms | 同上 | 同上。 |
| 最短终点允许时间 | 6000ms | 同上 | 源码存在；停车精度未验证。 |
| 宽线条件 | >=6路，连续4 tick | `H2_LINE_CAR/main.c` | 源码存在。 |
| 短刹时长 | 220ms | `car_config.h` | 源码存在。 |
| 丢线故障 | 400ms | `car_config.h` | 源码存在；对当前赛道内弯是否合适未完整验证。 |
| 直/中/大弯PWM | 220/190/160 | `car_config.h` | 用户称慢但稳定。 |
| 搜索内/外PWM | 55/150 | `car_config.h` | 用户历史基线，不是天猛星实测。 |
| PD | Kp 0.7，Kd 1.8 | `car_config.h` | 用户认可基线。 |
| PWM上限 | 350 | `car_config.h` | 源码存在。 |

`P2_FINAL_LAP_TEST.md` 中提到了 `EVENT,LAP_ARMED`、离开起点250ms、800ms丢线、0/28%搜索、全白启动拒绝和“V3翻转极性”，但该文档自己写明这些 V2/V3 描述“不适用于当前固件”，且与当前 `H2_LINE_CAR/main.c` 不一致。因此它只能作为**历史测试要求/失败方案线索**，不是稳定基线算法事实。

当前天猛星记忆工程参数与上述基线不同：其丢线上限为TEACH/REPLAY各1500ms，且有示教/回放；因未实板，不能称稳定。

## 9. 已经完成并有证据的成果

### 9.1 已完成并实板验证

- 地猛星 P0：用户报告“四项全部完成”；`H2_LINE_CAR/BUILD_STATUS.md`记录P0构建与安全意图。具体四项原始逐项串口未保存在当前工作区。
- 地猛星板型/LED纠正：用户直接指出“地猛星板载LED是PA14”；后续地猛星 `empty.syscfg` 使用PA14。
- CH340 串口：用户上传过 XCOM截图和连续`T=...S=...M=...`数据，说明至少当时串口通道可用。
- 灰度黑白极性：用户直接实测并纠正为白0、黑3.3V；用户又按验证条件确认白底 M=0、S4/S5压线M=24。
- D24A/四电机基础动作：用户架空车轮实测过前后轮方向问题；之后发现线松，重连后“可以走直线”。这证明当时至少有一次四轮直行运动，但不证明当前天猛星接线/固件有效。
- 地猛星稳定P1：用户明确反馈“稳定，转弯比较慢但是可以稳定”，并称22:44版本可完美执行但速度不满足最终目标。证据是用户实测描述及 `P2_FINAL_LAP_TEST.md` 的回退注释。
- K230图传：用户陈述Wi-Fi连手机图传“已经跑通”，手机浏览器MJPEG和录屏方案可用；本线程未复现。

### 9.2 已完成构建但尚未实板验证

- 当前 `H2_TIANMENG_MEMORY_STEPPER`：`check_syscfg.py`、`run_sysconfig.py`通过；源码、SysConfig生成文件、startup和链接通过；`verified_build/H2_TIANMENG_MEMORY_STEPPER.out`存在。证据：该工程 `BUILD_STATUS.md`。
- 天猛星P1迁移工程：有 `H2_LINE_CAR_TIANMENG/BUILD_STATUS.md` 和 `.out`，文档声明未烧录/未实车。
- A4988：STEP/DIR/ENABLE/HOME、100us定时器、点动/加减速/限位代码已经写入当前工程并完成构建；未接通VMOT实测。
- MPU6050底层文件已加入天猛星工程；启动探测被设置为0，未做传感器实测。

### 9.3 已实现但效果不满足要求

- 地猛星后续高性能/curve类修改：用户反馈直线“突然加速”“一卡一卡抽搐”，内弯冲出、丢线、全白原地逆时针转圈。构建存在但性能不可接受。
- 已有地猛星稳定循迹能慢速/局部稳定，但尚无连续完整一圈 `<=20s` 且停车 `<=2cm` 的记录。
- 当前A点检测/短刹代码能够输出`STATE,BRAKE/FINISHED`（串口中曾出现该类消息），但没有停车偏差合格的实测证据。

### 9.4 只完成理论设计

- 编码器速度 PI、里程标定、终点多条件识别。
- OLED显示计时/状态。
- MG996R独立供电与机械标定。
- 42步进的正式HOME、机构行程换算、球控执行器闭环。
- K230 UART协议、MSPM0接收、球位置/速度外环PID。
- 图传与小车最终供电/抗干扰合并。

### 9.5 尚未开始

- 当前天猛星工程烧录及实板接线验证。
- 当前天猛星完整一圈示教与回放实测。
- 编码器实际接线、计数、PPR标定、轮速PI。
- OLED驱动与比赛显示。
- K230到MSPM0 UART的实际联调。
- 钢球闭环PID、行驶中钢球稳定、全部第3～6问验收。

## 10. 已失败或被撤销的方案

| 方案 | 发生/原因 | 结论 |
|---|---|---|
| PWM启动斜坡 | 为缓和起步/提速加入；用户反馈第一段直线突然加速、匀速性差。 | 撤销，不可重新引入而不做单变量台架与实车对比。 |
| 内轮最低PWM | 为避免内轮停转而设置下限；用户认为内弯转向不足，容易按切线冲出。 | 撤销；稳定基线允许内轮按差速降低。 |
| 0/28%强制找线 | 历史测试文档描述过强差速搜索；全白情况下曾出现逆时针失控转圈。 | 不作为稳定策略；curve副本仅历史实验。 |
| 未经直接证据翻转转向符号 | 曾根据日志推断极性，用户要求以直接车轮测试为准；后续还出现后轮方向/线松等硬件因素。 | 禁止凭视频或日志猜测翻转。 |
| 按时间划分直线/弯道 TRACK | 用户要求“记住线路/循迹P1辅助”之前曾有按时间划分赛段想法；用户反馈长按启动/只能转弯，且其本身不能适应起点偏差和电池变化。 | 撤销，不能以时间表替代赛段识别。 |
| 短按切模式、长按启动 | 用户反馈“长按启动和只能转弯的问题”。 | 撤销；当前天猛星代码采用短按消抖事件。 |
| 地猛星 curve 当前路线 | 用户最终明确“现在放弃地猛星”，并描述该版本直线抽搐、第二弯冲出。 | 不再作为当前开发对象。 |
| MG996R直接球控 | 舵机只能接收角度命令；无视觉位置闭环无法保证球误差。且舵机供电/机械细节未齐。 | 未定稿，暂不作为当前执行主线。 |

## 11. 当前未解决的问题

1. 天猛星完整一圈时间：当前新工程无实车记录。
2. 停车偏差：没有连续多次、带正负方向的厘米级数据。
3. A点识别稳定性：现有宽线+时间逻辑未验证误检/漏检；`LAP_ARMED`与实际基线源码不一致。
4. 车载显示：0.96寸屏的驱动芯片/接线/代码均未完成。
5. 编码器计数标定：电机型号、PPR口径、输出电平和接线均未定。
6. 轮速 PI：尚未开始。
7. 电机准确型号：MG310与MG513XP28_12V冲突未消除。
8. D24A逻辑电平转换：HCT是否必须，存在相互冲突文档，未实测定案。
9. 舵机或步进最终选型：MG996R已具备；42步进方案有软件/机构，但无HOME和台架结果。
10. 摆杆机械结构：有 `.stp/.3mf`，但未记录中点、限位、连杆孔距、微步-位移标定。
11. 摄像头位置数据格式：K230发送内容、坐标系、单位、速率、丢帧策略为TBD。
12. 钢球PID：未实现、未调参。
13. 图传：用户称跑通，未与控制工程整合或保存接口证据。
14. 多子项目合并：底盘、显示、编码器、视觉、球控、执行器还未建立统一接口/状态机。

## 12. 测试记录要求

下一次**循迹实测**必须以一个固定固件版本和一组固定参数为单位，收集：

- 固件工程路径、`car_config.h`参数、构建时间/输出文件名、是否重启过MCU。
- 电池静置电压和测试后电压。
- `EVENT,LAP_ARMED,T=...`：若当前固件没有该字段，应明确写“当前固件未实现该事件”，不得伪造。
- 返回 A 点前后各约1秒的完整串口数据。
- `STATE,BRAKE,T=...`。
- `STATE,FINISHED,T=...`，或故障的完整`STATE,FAULT,...`。
- 一圈总时间。
- 停车偏差：以固定车体测量标记为准，越过基准线为正、未到为负，单位cm。
- 至少一个内弯的连续视频（能看见车体、灰度板、轨迹）。
- 最终停车视频。
- 起步位置、车头方向、是否有人按K2/K3人工辅助。

针对当前天猛星记忆工程，额外收集 `MODE=T/R`、`MEM=当前/总数`、`STEP=position/target`、`M/E/L/R`；首圈示教和回放必须分别保存完整日志。

## 13. 推荐的后续执行顺序

| 阶段 | 进入条件 | 操作 | 完成判据 | 禁止同时修改 |
|---|---|---|---|---|
| 1. 冻结稳定版 | 当前文件已备份，选择天猛星工程 | 不改P1、仅确认接线/安全态。 | PB15低、PA25高、串口启动信息、灰度M值正确。 | 不改速度、PD、方向、步进。 |
| 2. 慢速完整一圈 | 单板/灰度/四轮方向已确认，车轮可控 | 用P1或TEACH低速完成一圈。 | 不冲线、不提前停，保存完整日志。 | 不提速、不上球控。 |
| 3. 单变量提高速度 | 连续多次慢速完整一圈 | 每次只改一项：直线基准PWM或一个PD系数。 | 每项比较圈时、最大误差、丢线和视频。 | 不同时改丢线搜索、方向、刹车。 |
| 4. 调整停车 | 一圈稳定 | 固定速度后，只调宽线门限/最短时间/刹车时长之一。 | 连续记录10次，停车偏差趋势明确。 | 不改循迹速度或PD。 |
| 5. 增加显示 | 底盘停车逻辑冻结 | 先单独显示固定文本，再显示计时和锁存时间。 | 不影响控制周期/串口。 | 不改底盘控制。 |
| 6. 标定编码器 | 已确认电机和电平转换 | 单轮手转一圈、记录计数和方向；再架空测速。 | 得到每轮可靠计数、方向、可复测误差。 | 不接轮速PI。 |
| 7. 引入轮速PI | 编码器稳定 | 左右轮组先单独阶跃，再直行闭环。 | 电池变化下直行/速度重复性改善。 | 不同时修改外层循迹PD。 |
| 8. 独立调试摆杆 | HOME已装、机构无干涉、A4988限流已实测 | 台架点动、回零、行程与位移标定。 | 多次回零无撞限/过热。 | 不与行车或球控合并。 |
| 9. 接入视觉 | K230数据帧已冻结、通信电平确认 | 先串口打印位置/速度/置信度和丢帧。 | 坐标、延迟、掉线行为有记录。 | 不开球控PID。 |
| 10. 调钢球外环 | 执行器回零和视觉均独立稳定 | 静止车上闭环球位置，再小范围阶跃。 | 中心/指定点误差达到可重复指标。 | 不让车行驶。 |
| 11. 最终合并 | 底盘、球控分别稳定 | 由明确状态机启动/故障停机，逐步增加车速。 | 满足题目各分项，多次可重复。 | 不一次改多个子系统参数。 |

## 14. 当前文件状态

### 当前参与构建的天猛星记忆工程文件

- 源码：`outputs/H2_TIANMENG_MEMORY_STEPPER/main.c`、`track_memory.c`、`mpu6050.c`。
- 头文件：`car_config.h`、`track_memory.h`、`a4988.h`、`mpu6050.h`。
- 配置：`empty.syscfg`、`.project`、`.cproject`、`targetConfigs/MSPM0G3507.ccxml`。
- 当前验证输出：`verified_build/H2_TIANMENG_MEMORY_STEPPER.out/.map`。

### 本线程中已修改/新增的主要项目文件（历史事实）

- 地猛星 `H2_LINE_CAR`：`empty.syscfg`、`main.c`、`car_config.h` 及多份P0/P1/P2/供电说明；其后形成22:44基线。
- 地猛星 `H2_LINE_CAR_CURVE_TEST`：从稳定版复制后改了丢线搜索/全白拒绝等实验逻辑。
- 天猛星 `H2_LINE_CAR_TIANMENG`：新增天猛星板级P1迁移、`mpu6050.c/.h`、接线说明。
- 天猛星 `H2_TIANMENG_MEMORY_STEPPER`：新增 `track_memory.c/.h`、`a4988.h`、四键/A4988 SysConfig配置、相关文档、已验证构建输出。

### 历史版本与注释

- `H2_LINE_CAR` 是22:44左右稳定P1的文件级基线。
- `H2_LINE_CAR_CURVE_TEST` 是未实车确认的内弯实验副本。
- `P2_FINAL_LAP_TEST.md` 顶部注释保留了“已回退22:44”以及部分已不适用V2/V3说明；不可把其中不适用内容反写入当前基线。
- 天猛星记忆工程 `Debug/` 中有从底座留下的旧名 `.out`；不是当前有效验证产物。

### Git 状态（本次只读检查结果）

- 工作目录 `C:\Users\Lenovo\Documents\Codex\2026-07-29\ccs-8-agent-skil-2024-h` **不存在 `.git`**。
- `git status --short`：`fatal: not a git repository (or any of the parent directories): .git`。
- `git diff --stat`：N/A；Git 同样返回非仓库错误。
- 最近提交记录：N/A；Git 同样返回非仓库错误。
- 因此“尚未提交的更改”无法由 Git 判断；只能确认本次交接操作将新增本文件，且用户要求不提交。

## 15. 事实冲突与待人工确认

| 冲突/不确定项 | 相互矛盾的记录 | 较新的支持/处理要求 |
|---|---|---|
| 开发板/封装 | 早期错误使用天猛星 LQFP64/PB22；用户后来纠正当时实际地猛星为LQFP48/PA14；最终用户又明确放弃地猛星、转天猛星。 | 当前有效工程明确天猛星 `LQFP-64(PM)`、PB22；不要将地猛星引脚复制进去。 |
| PB22与PA14 | 地猛星初期PB22不闪，用户指出地猛星LED=PA14；天猛星 SysConfig=PB22。 | 两者都是不同板级事实；必须按当前天猛星工程使用PB22。 |
| 灰度极性 | 早期由日志误推反；用户直接测试白0黑3.3V、M=0/M=24。 | 用户实测优先：1=黑线。 |
| 行走电机 | 用户文字：MG310、13PPR、1:20；后续照片：MG513XP28_12V。 | 未确认是否同一批/替换；不得写死轮速或里程参数。 |
| 减速比 | 文字出现1:20；后续任务要求中特别提示1:28冲突。 | 本线程现存照片/文字未解决，TBD。 |
| PPR定义 | 用户称13 PPR；单通道/双边沿/四倍频未知。 | 必须实测车轮一整圈计数。 |
| D24A 3.3→5V电平 | 地猛星供电文档认为需HCT；当前天猛星接线文档认为直连可行。 | 不能自行消除冲突；按真实TB6612数据表和实测决定。 |
| 各版PWM | 早期35%后降22%；22:44基线为220/190/160、55/150；curve副本有30/180、0/260；历史文档还有0/28%。 | 仅22:44基线得到用户“慢但稳定”反馈；天猛星新工程虽用同基准PWM但未实测。 |
| 转向极性 | 曾根据日志推断、后被用户直接车轮现象推翻；还有后轮动力线/扇出/线松影响。 | 必须再次架空逐轮、落地低速确认，不能凭推测改符号。 |
| 舵机与步进 | MG996R已装过且有结构；用户又决定试42BYGH23/A4988。 | 当前软件优先实现A4988点动；最终方案未定。 |
| K230电平 | 用户文字写K230逻辑5V，又称对MSPM0用3.3V TTL UART。 | 接线前必须确认K230 UART实际IO电平，必要时转换。 |

## 16. 给下一位开发者的硬性约束

1. 不覆盖或静默改写 `H2_LINE_CAR` 的22:44稳定基线；新想法必须复制为独立工程。
2. 一次实车测试只修改一个控制变量；速度、PD、方向、丢线搜索、刹车不能一起改。
3. 不根据视频、串口符号或“看起来”翻转转向极性；必须以架空四轮和低速落地的直接实测为据。
4. 不以时间表替代实际赛段/线路识别；时间回放只能作为当前天猛星TEACH/REPLAY的辅助实验，且需P1与最终里程/航向校正。
5. 不手改 `Debug/ti_msp_dl_config.*` 或其他 SysConfig生成文件；只修改 `.syscfg` 后运行检查/生成。
6. 未确认共地、STBY、ENABLE、逻辑电平、电机/步进机构安全状态前，不烧录或运行可能驱动执行器的固件。
7. 不把“SysConfig/编译/链接成功”写成“烧录成功”或“实车成功”。
8. 不把旧地猛星电源结论直接套到天猛星；尤其不要把USB、D24A 5V、XDS110供电未经确认地并联。
9. 不把5V编码器输出、K230 UART电平或OLED接口当作已知；先测量/查实际资料。
10. 天猛星记忆工程中，先完成 `MEMORY_STEPPER_TEST.md` A、B、C、D 分阶段验证；不在没有HOME和机构标定时接入钢球闭环。
