how2idealizefreedom/electric-car-ball-balance/hardware/【WHEELTEC】TB6612电机驱动附送资料/【WHEELTEC】TB6612电机驱动附送资料_V3.2_2026.07.25/4.例程源码/1.STM32F1例程/3.D24A（四路驱动带稳压版）例程/D24Ademo(霍尔编码器)2025.7.8/D24Ademo(霍尔编码器)/OBJ/Minibalance.htm

# Static Call Graph for image ..\OBJ\Minibalance.axf

#<CALLGRAPH># ARM Linker, 5060960: Last Updated: Tue Jul 08 15:14:02 2025

### Maximum Stack Usage = 324 bytes + Unknown(Functions without stacksize, Cycles, Untraceable Function Pointers)

### Call chain for Maximum Stack Depth:

_printf_f ⇒ _printf_fp_dec ⇒ _printf_fp_dec_real ⇒ _fp_digits ⇒ _btod_etento ⇒ _btod_emul ⇒ _e2e

### Functions with no stack information

- __user_initial_stackheap

### Mutually Recursive functions

- ADC1_2_IRQHandler ⇒ ADC1_2_IRQHandler

### Function Pointers

- ADC1_2_IRQHandler from startup_stm32f10x_md.o(.text) referenced from startup_stm32f10x_md.o(RESET)
- BusFault_Handler from stm32f10x_it.o(i.BusFault_Handler) referenced from startup_stm32f10x_md.o(RESET)
- CAN1_RX1_IRQHandler from startup_stm32f10x_md.o(.text) referenced from startup_stm32f10x_md.o(RESET)
- CAN1_SCE_IRQHandler from startup_stm32f10x_md.o(.text) referenced from startup_stm32f10x_md.o(RESET)
- DMA1_Channel1_IRQHandler from startup_stm32f10x_md.o(.text) referenced from startup_stm32f10x_md.o(RESET)
- DMA1_Channel2_IRQHandler from startup_stm32f10x_md.o(.text) referenced from startup_stm32f10x_md.o(RESET)
- DMA1_Channel3_IRQHandler from startup_stm32f10x_md.o(.text) referenced from startup_stm32f10x_md.o(RESET)
- DMA1_Channel4_IRQHandler from startup_stm32f10x_md.o(.text) referenced from startup_stm32f10x_md.o(RESET)
- DMA1_Channel5_IRQHandler from startup_stm32f10x_md.o(.text) referenced from startup_stm32f10x_md.o(RESET)
- DMA1_Channel6_IRQHandler from startup_stm32f10x_md.o(.text) referenced from startup_stm32f10x_md.o(RESET)
- DMA1_Channel7_IRQHandler from startup_stm32f10x_md.o(.text) referenced from startup_stm32f10x_md.o(RESET)
- DebugMon_Handler from stm32f10x_it.o(i.DebugMon_Handler) referenced from startup_stm32f10x_md.o(RESET)
- EXTI0_IRQHandler from startup_stm32f10x_md.o(.text) referenced from startup_stm32f10x_md.o(RESET)
- EXTI15_10_IRQHandler from startup_stm32f10x_md.o(.text) referenced from startup_stm32f10x_md.o(RESET)
- EXTI1_IRQHandler from startup_stm32f10x_md.o(.text) referenced from startup_stm32f10x_md.o(RESET)
- EXTI2_IRQHandler from startup_stm32f10x_md.o(.text) referenced from startup_stm32f10x_md.o(RESET)
- EXTI3_IRQHandler from startup_stm32f10x_md.o(.text) referenced from startup_stm32f10x_md.o(RESET)
- EXTI4_IRQHandler from startup_stm32f10x_md.o(.text) referenced from startup_stm32f10x_md.o(RESET)
- EXTI9_5_IRQHandler from startup_stm32f10x_md.o(.text) referenced from startup_stm32f10x_md.o(RESET)
- FLASH_IRQHandler from startup_stm32f10x_md.o(.text) referenced from startup_stm32f10x_md.o(RESET)
- HardFault_Handler from stm32f10x_it.o(i.HardFault_Handler) referenced from startup_stm32f10x_md.o(RESET)
- I2C1_ER_IRQHandler from startup_stm32f10x_md.o(.text) referenced from startup_stm32f10x_md.o(RESET)
- I2C1_EV_IRQHandler from startup_stm32f10x_md.o(.text) referenced from startup_stm32f10x_md.o(RESET)
- I2C2_ER_IRQHandler from startup_stm32f10x_md.o(.text) referenced from startup_stm32f10x_md.o(RESET)
- I2C2_EV_IRQHandler from startup_stm32f10x_md.o(.text) referenced from startup_stm32f10x_md.o(RESET)
- MemManage_Handler from stm32f10x_it.o(i.MemManage_Handler) referenced from startup_stm32f10x_md.o(RESET)
- NMI_Handler from stm32f10x_it.o(i.NMI_Handler) referenced from startup_stm32f10x_md.o(RESET)
- PVD_IRQHandler from startup_stm32f10x_md.o(.text) referenced from startup_stm32f10x_md.o(RESET)
- PendSV_Handler from stm32f10x_it.o(i.PendSV_Handler) referenced from startup_stm32f10x_md.o(RESET)
- RCC_IRQHandler from startup_stm32f10x_md.o(.text) referenced from startup_stm32f10x_md.o(RESET)
- RTCAlarm_IRQHandler from startup_stm32f10x_md.o(.text) referenced from startup_stm32f10x_md.o(RESET)
- RTC_IRQHandler from startup_stm32f10x_md.o(.text) referenced from startup_stm32f10x_md.o(RESET)
- Reset_Handler from startup_stm32f10x_md.o(.text) referenced from startup_stm32f10x_md.o(RESET)
- SPI1_IRQHandler from startup_stm32f10x_md.o(.text) referenced from startup_stm32f10x_md.o(RESET)
- SPI2_IRQHandler from startup_stm32f10x_md.o(.text) referenced from startup_stm32f10x_md.o(RESET)
- SVC_Handler from stm32f10x_it.o(i.SVC_Handler) referenced from startup_stm32f10x_md.o(RESET)
- SysTick_Handler from stm32f10x_it.o(i.SysTick_Handler) referenced from startup_stm32f10x_md.o(RESET)
- SystemInit from system_stm32f10x.o(i.SystemInit) referenced from startup_stm32f10x_md.o(.text)
- TAMPER_IRQHandler from startup_stm32f10x_md.o(.text) referenced from startup_stm32f10x_md.o(RESET)
- TIM1_BRK_IRQHandler from startup_stm32f10x_md.o(.text) referenced from startup_stm32f10x_md.o(RESET)
- TIM1_CC_IRQHandler from startup_stm32f10x_md.o(.text) referenced from startup_stm32f10x_md.o(RESET)
- TIM1_TRG_COM_IRQHandler from startup_stm32f10x_md.o(.text) referenced from startup_stm32f10x_md.o(RESET)
- TIM1_UP_IRQHandler from startup_stm32f10x_md.o(.text) referenced from startup_stm32f10x_md.o(RESET)
- TIM2_IRQHandler from encoder.o(i.TIM2_IRQHandler) referenced from startup_stm32f10x_md.o(RESET)
- TIM3_IRQHandler from encoder.o(i.TIM3_IRQHandler) referenced from startup_stm32f10x_md.o(RESET)
- TIM4_IRQHandler from encoder.o(i.TIM4_IRQHandler) referenced from startup_stm32f10x_md.o(RESET)
- USART1_IRQHandler from usart.o(i.USART1_IRQHandler) referenced from startup_stm32f10x_md.o(RESET)
- USART2_IRQHandler from startup_stm32f10x_md.o(.text) referenced from startup_stm32f10x_md.o(RESET)
- USART3_IRQHandler from startup_stm32f10x_md.o(.text) referenced from startup_stm32f10x_md.o(RESET)
- USBWakeUp_IRQHandler from startup_stm32f10x_md.o(.text) referenced from startup_stm32f10x_md.o(RESET)
- USB_HP_CAN1_TX_IRQHandler from startup_stm32f10x_md.o(.text) referenced from startup_stm32f10x_md.o(RESET)
- USB_LP_CAN1_RX0_IRQHandler from startup_stm32f10x_md.o(.text) referenced from startup_stm32f10x_md.o(RESET)
- UsageFault_Handler from stm32f10x_it.o(i.UsageFault_Handler) referenced from startup_stm32f10x_md.o(RESET)
- WWDG_IRQHandler from startup_stm32f10x_md.o(.text) referenced from startup_stm32f10x_md.o(RESET)
- __main from __main.o(!!!main) referenced from startup_stm32f10x_md.o(.text)
- _printf_input_char from _printf_char_common.o(.text) referenced from _printf_char_common.o(.text)
- fputc from usart.o(i.fputc) referenced from _printf_char_file.o(.text)

### Global Symbols

__main (Thumb, 8 bytes, Stack size 0 bytes, __main.o(!!!main))

[Calls]

- >> __rt_entry
- >> __scatterload

__scatterload (Thumb, 0 bytes, Stack size unknown bytes, __scatter.o(!!!scatter))

[Called By]

- >> __main

__scatterload_rt2 (Thumb, 44 bytes, Stack size unknown bytes, __scatter.o(!!!scatter), UNUSED)

[Calls]

- >> __rt_entry

__scatterload_rt2_thumb_only (Thumb, 0 bytes, Stack size unknown bytes, __scatter.o(!!!scatter), UNUSED)

__scatterload_null (Thumb, 0 bytes, Stack size unknown bytes, __scatter.o(!!!scatter), UNUSED)

__scatterload_copy (Thumb, 26 bytes, Stack size unknown bytes, __scatter_copy.o(!!handler_copy), UNUSED)

[Calls]

- >> __scatterload_copy

[Called By]

- >> __scatterload_copy

__scatterload_zeroinit (Thumb, 28 bytes, Stack size unknown bytes, __scatter_zi.o(!!handler_zi), UNUSED)

_printf_f (Thumb, 0 bytes, Stack size unknown bytes, _printf_f.o(.ARM.Collect$$_printf_percent$$00000003))

[Stack]

- Max Depth = 324 + Unknown Stack Size
- Call Chain = _printf_f ⇒ _printf_fp_dec ⇒ _printf_fp_dec_real ⇒ _fp_digits ⇒ _btod_etento ⇒ _btod_emul ⇒ _e2e

[Calls]

- >> _printf_fp_dec

_printf_percent (Thumb, 0 bytes, Stack size unknown bytes, _printf_percent.o(.ARM.Collect$$_printf_percent$$00000000))

[Called By]

- >> __printf

_printf_d (Thumb, 0 bytes, Stack size unknown bytes, _printf_d.o(.ARM.Collect$$_printf_percent$$00000009))

[Stack]

- Max Depth = 72 + Unknown Stack Size
- Call Chain = _printf_d ⇒ _printf_int_dec ⇒ _printf_int_common ⇒ _printf_post_padding

[Calls]

- >> _printf_int_dec

_printf_percent_end (Thumb, 0 bytes, Stack size unknown bytes, _printf_percent_end.o(.ARM.Collect$$_printf_percent$$00000017))

__rt_lib_init (Thumb, 0 bytes, Stack size unknown bytes, libinit.o(.ARM.Collect$$libinit$$00000000))

[Called By]

- >> __rt_entry_li

__rt_lib_init_fp_1 (Thumb, 0 bytes, Stack size unknown bytes, libinit2.o(.ARM.Collect$$libinit$$00000002))

__rt_lib_init_heap_1 (Thumb, 0 bytes, Stack size unknown bytes, libinit2.o(.ARM.Collect$$libinit$$0000000A))

__rt_lib_init_lc_common (Thumb, 0 bytes, Stack size unknown bytes, libinit2.o(.ARM.Collect$$libinit$$0000000F))

[Calls]

- >> __rt_locale

__rt_lib_init_preinit_1 (Thumb, 0 bytes, Stack size unknown bytes, libinit2.o(.ARM.Collect$$libinit$$00000004))

__rt_lib_init_rand_1 (Thumb, 0 bytes, Stack size unknown bytes, libinit2.o(.ARM.Collect$$libinit$$0000000E))

__rt_lib_init_user_alloc_1 (Thumb, 0 bytes, Stack size unknown bytes, libinit2.o(.ARM.Collect$$libinit$$0000000C))

__rt_lib_init_lc_collate_1 (Thumb, 0 bytes, Stack size unknown bytes, libinit2.o(.ARM.Collect$$libinit$$00000011))

__rt_lib_init_lc_ctype_1 (Thumb, 0 bytes, Stack size unknown bytes, libinit2.o(.ARM.Collect$$libinit$$00000013))

__rt_lib_init_lc_monetary_1 (Thumb, 0 bytes, Stack size unknown bytes, libinit2.o(.ARM.Collect$$libinit$$00000015))

__rt_lib_init_lc_numeric_2 (Thumb, 0 bytes, Stack size unknown bytes, libinit2.o(.ARM.Collect$$libinit$$00000016))

[Stack]

- Max Depth = 8 + Unknown Stack Size
- Call Chain = __rt_lib_init_lc_numeric_2 ⇒ _get_lc_numeric

[Calls]

- >> _get_lc_numeric

__rt_lib_init_alloca_1 (Thumb, 0 bytes, Stack size unknown bytes, libinit2.o(.ARM.Collect$$libinit$$0000002E))

__rt_lib_init_argv_1 (Thumb, 0 bytes, Stack size unknown bytes, libinit2.o(.ARM.Collect$$libinit$$0000002C))

__rt_lib_init_atexit_1 (Thumb, 0 bytes, Stack size unknown bytes, libinit2.o(.ARM.Collect$$libinit$$0000001B))

__rt_lib_init_clock_1 (Thumb, 0 bytes, Stack size unknown bytes, libinit2.o(.ARM.Collect$$libinit$$00000021))

__rt_lib_init_cpp_1 (Thumb, 0 bytes, Stack size unknown bytes, libinit2.o(.ARM.Collect$$libinit$$00000032))

__rt_lib_init_exceptions_1 (Thumb, 0 bytes, Stack size unknown bytes, libinit2.o(.ARM.Collect$$libinit$$00000030))

__rt_lib_init_fp_trap_1 (Thumb, 0 bytes, Stack size unknown bytes, libinit2.o(.ARM.Collect$$libinit$$0000001F))

__rt_lib_init_getenv_1 (Thumb, 0 bytes, Stack size unknown bytes, libinit2.o(.ARM.Collect$$libinit$$00000023))

__rt_lib_init_lc_numeric_1 (Thumb, 0 bytes, Stack size unknown bytes, libinit2.o(.ARM.Collect$$libinit$$00000017))

__rt_lib_init_lc_time_1 (Thumb, 0 bytes, Stack size unknown bytes, libinit2.o(.ARM.Collect$$libinit$$00000019))

__rt_lib_init_return (Thumb, 0 bytes, Stack size unknown bytes, libinit2.o(.ARM.Collect$$libinit$$00000033))

__rt_lib_init_signal_1 (Thumb, 0 bytes, Stack size unknown bytes, libinit2.o(.ARM.Collect$$libinit$$0000001D))

__rt_lib_init_stdio_1 (Thumb, 0 bytes, Stack size unknown bytes, libinit2.o(.ARM.Collect$$libinit$$00000025))

__rt_lib_shutdown (Thumb, 0 bytes, Stack size unknown bytes, libshutdown.o(.ARM.Collect$$libshutdown$$00000000))

[Called By]

- >> __rt_exit_ls

__rt_lib_shutdown_cpp_1 (Thumb, 0 bytes, Stack size unknown bytes, libshutdown2.o(.ARM.Collect$$libshutdown$$00000004))

__rt_lib_shutdown_fini_1 (Thumb, 0 bytes, Stack size unknown bytes, libshutdown2.o(.ARM.Collect$$libshutdown$$00000002))

__rt_lib_shutdown_fp_trap_1 (Thumb, 0 bytes, Stack size unknown bytes, libshutdown2.o(.ARM.Collect$$libshutdown$$00000009))

__rt_lib_shutdown_heap_1 (Thumb, 0 bytes, Stack size unknown bytes, libshutdown2.o(.ARM.Collect$$libshutdown$$00000011))

__rt_lib_shutdown_return (Thumb, 0 bytes, Stack size unknown bytes, libshutdown2.o(.ARM.Collect$$libshutdown$$00000012))

__rt_lib_shutdown_signal_1 (Thumb, 0 bytes, Stack size unknown bytes, libshutdown2.o(.ARM.Collect$$libshutdown$$0000000C))

__rt_lib_shutdown_stdio_1 (Thumb, 0 bytes, Stack size unknown bytes, libshutdown2.o(.ARM.Collect$$libshutdown$$00000006))

__rt_lib_shutdown_user_alloc_1 (Thumb, 0 bytes, Stack size unknown bytes, libshutdown2.o(.ARM.Collect$$libshutdown$$0000000E))

__rt_entry (Thumb, 0 bytes, Stack size unknown bytes, __rtentry.o(.ARM.Collect$$rtentry$$00000000))

[Called By]

- >> __main
- >> __scatterload_rt2

__rt_entry_presh_1 (Thumb, 0 bytes, Stack size unknown bytes, __rtentry2.o(.ARM.Collect$$rtentry$$00000002))

__rt_entry_sh (Thumb, 0 bytes, Stack size unknown bytes, __rtentry4.o(.ARM.Collect$$rtentry$$00000004))

[Stack]

- Max Depth = 8 + Unknown Stack Size
- Call Chain = __rt_entry_sh ⇒ __user_setup_stackheap

[Calls]

- >> __user_setup_stackheap

__rt_entry_li (Thumb, 0 bytes, Stack size unknown bytes, __rtentry2.o(.ARM.Collect$$rtentry$$0000000A))

[Calls]

- >> __rt_lib_init

__rt_entry_postsh_1 (Thumb, 0 bytes, Stack size unknown bytes, __rtentry2.o(.ARM.Collect$$rtentry$$00000009))

__rt_entry_main (Thumb, 0 bytes, Stack size unknown bytes, __rtentry2.o(.ARM.Collect$$rtentry$$0000000D))

[Stack]

- Max Depth = 168 + Unknown Stack Size
- Call Chain = __rt_entry_main ⇒ main ⇒ __2printf ⇒ _printf_char_file ⇒ _printf_char_common ⇒ __printf

[Calls]

- >> main
- >> exit

__rt_entry_postli_1 (Thumb, 0 bytes, Stack size unknown bytes, __rtentry2.o(.ARM.Collect$$rtentry$$0000000C))

__rt_exit (Thumb, 0 bytes, Stack size unknown bytes, rtexit.o(.ARM.Collect$$rtexit$$00000000))

[Called By]

- >> exit

__rt_exit_ls (Thumb, 0 bytes, Stack size unknown bytes, rtexit2.o(.ARM.Collect$$rtexit$$00000003))

[Calls]

- >> __rt_lib_shutdown

__rt_exit_prels_1 (Thumb, 0 bytes, Stack size unknown bytes, rtexit2.o(.ARM.Collect$$rtexit$$00000002))

__rt_exit_exit (Thumb, 0 bytes, Stack size unknown bytes, rtexit2.o(.ARM.Collect$$rtexit$$00000004))

[Calls]

- >> _sys_exit

Reset_Handler (Thumb, 8 bytes, Stack size 0 bytes, startup_stm32f10x_md.o(.text))
[Address Reference Count : 1]

- startup_stm32f10x_md.o(RESET)

ADC1_2_IRQHandler (Thumb, 0 bytes, Stack size 0 bytes, startup_stm32f10x_md.o(.text))

[Calls]

- >> ADC1_2_IRQHandler

[Called By]

- >> ADC1_2_IRQHandler

[Address Reference Count : 1]

- startup_stm32f10x_md.o(RESET)

CAN1_RX1_IRQHandler (Thumb, 0 bytes, Stack size 0 bytes, startup_stm32f10x_md.o(.text))
[Address Reference Count : 1]

- startup_stm32f10x_md.o(RESET)

CAN1_SCE_IRQHandler (Thumb, 0 bytes, Stack size 0 bytes, startup_stm32f10x_md.o(.text))
[Address Reference Count : 1]

- startup_stm32f10x_md.o(RESET)

DMA1_Channel1_IRQHandler (Thumb, 0 bytes, Stack size 0 bytes, startup_stm32f10x_md.o(.text))
[Address Reference Count : 1]

- startup_stm32f10x_md.o(RESET)

DMA1_Channel2_IRQHandler (Thumb, 0 bytes, Stack size 0 bytes, startup_stm32f10x_md.o(.text))
[Address Reference Count : 1]

- startup_stm32f10x_md.o(RESET)

DMA1_Channel3_IRQHandler (Thumb, 0 bytes, Stack size 0 bytes, startup_stm32f10x_md.o(.text))
[Address Reference Count : 1]

- startup_stm32f10x_md.o(RESET)

DMA1_Channel4_IRQHandler (Thumb, 0 bytes, Stack size 0 bytes, startup_stm32f10x_md.o(.text))
[Address Reference Count : 1]

- startup_stm32f10x_md.o(RESET)

DMA1_Channel5_IRQHandler (Thumb, 0 bytes, Stack size 0 bytes, startup_stm32f10x_md.o(.text))
[Address Reference Count : 1]

- startup_stm32f10x_md.o(RESET)

DMA1_Channel6_IRQHandler (Thumb, 0 bytes, Stack size 0 bytes, startup_stm32f10x_md.o(.text))
[Address Reference Count : 1]

- startup_stm32f10x_md.o(RESET)

DMA1_Channel7_IRQHandler (Thumb, 0 bytes, Stack size 0 bytes, startup_stm32f10x_md.o(.text))
[Address Reference Count : 1]

- startup_stm32f10x_md.o(RESET)

EXTI0_IRQHandler (Thumb, 0 bytes, Stack size 0 bytes, startup_stm32f10x_md.o(.text))
[Address Reference Count : 1]

- startup_stm32f10x_md.o(RESET)

EXTI15_10_IRQHandler (Thumb, 0 bytes, Stack size 0 bytes, startup_stm32f10x_md.o(.text))
[Address Reference Count : 1]

- startup_stm32f10x_md.o(RESET)

EXTI1_IRQHandler (Thumb, 0 bytes, Stack size 0 bytes, startup_stm32f10x_md.o(.text))
[Address Reference Count : 1]

- startup_stm32f10x_md.o(RESET)

EXTI2_IRQHandler (Thumb, 0 bytes, Stack size 0 bytes, startup_stm32f10x_md.o(.text))
[Address Reference Count : 1]

- startup_stm32f10x_md.o(RESET)

EXTI3_IRQHandler (Thumb, 0 bytes, Stack size 0 bytes, startup_stm32f10x_md.o(.text))
[Address Reference Count : 1]

- startup_stm32f10x_md.o(RESET)

EXTI4_IRQHandler (Thumb, 0 bytes, Stack size 0 bytes, startup_stm32f10x_md.o(.text))
[Address Reference Count : 1]

- startup_stm32f10x_md.o(RESET)

EXTI9_5_IRQHandler (Thumb, 0 bytes, Stack size 0 bytes, startup_stm32f10x_md.o(.text))
[Address Reference Count : 1]

- startup_stm32f10x_md.o(RESET)

FLASH_IRQHandler (Thumb, 0 bytes, Stack size 0 bytes, startup_stm32f10x_md.o(.text))
[Address Reference Count : 1]

- startup_stm32f10x_md.o(RESET)

I2C1_ER_IRQHandler (Thumb, 0 bytes, Stack size 0 bytes, startup_stm32f10x_md.o(.text))
[Address Reference Count : 1]

- startup_stm32f10x_md.o(RESET)

I2C1_EV_IRQHandler (Thumb, 0 bytes, Stack size 0 bytes, startup_stm32f10x_md.o(.text))
[Address Reference Count : 1]

- startup_stm32f10x_md.o(RESET)

I2C2_ER_IRQHandler (Thumb, 0 bytes, Stack size 0 bytes, startup_stm32f10x_md.o(.text))
[Address Reference Count : 1]

- startup_stm32f10x_md.o(RESET)

I2C2_EV_IRQHandler (Thumb, 0 bytes, Stack size 0 bytes, startup_stm32f10x_md.o(.text))
[Address Reference Count : 1]

- startup_stm32f10x_md.o(RESET)

PVD_IRQHandler (Thumb, 0 bytes, Stack size 0 bytes, startup_stm32f10x_md.o(.text))
[Address Reference Count : 1]

- startup_stm32f10x_md.o(RESET)

RCC_IRQHandler (Thumb, 0 bytes, Stack size 0 bytes, startup_stm32f10x_md.o(.text))
[Address Reference Count : 1]

- startup_stm32f10x_md.o(RESET)

RTCAlarm_IRQHandler (Thumb, 0 bytes, Stack size 0 bytes, startup_stm32f10x_md.o(.text))
[Address Reference Count : 1]

- startup_stm32f10x_md.o(RESET)

RTC_IRQHandler (Thumb, 0 bytes, Stack size 0 bytes, startup_stm32f10x_md.o(.text))
[Address Reference Count : 1]

- startup_stm32f10x_md.o(RESET)

SPI1_IRQHandler (Thumb, 0 bytes, Stack size 0 bytes, startup_stm32f10x_md.o(.text))
[Address Reference Count : 1]

- startup_stm32f10x_md.o(RESET)

SPI2_IRQHandler (Thumb, 0 bytes, Stack size 0 bytes, startup_stm32f10x_md.o(.text))
[Address Reference Count : 1]

- startup_stm32f10x_md.o(RESET)

TAMPER_IRQHandler (Thumb, 0 bytes, Stack size 0 bytes, startup_stm32f10x_md.o(.text))
[Address Reference Count : 1]

- startup_stm32f10x_md.o(RESET)

TIM1_BRK_IRQHandler (Thumb, 0 bytes, Stack size 0 bytes, startup_stm32f10x_md.o(.text))
[Address Reference Count : 1]

- startup_stm32f10x_md.o(RESET)

TIM1_CC_IRQHandler (Thumb, 0 bytes, Stack size 0 bytes, startup_stm32f10x_md.o(.text))
[Address Reference Count : 1]

- startup_stm32f10x_md.o(RESET)

TIM1_TRG_COM_IRQHandler (Thumb, 0 bytes, Stack size 0 bytes, startup_stm32f10x_md.o(.text))
[Address Reference Count : 1]

- startup_stm32f10x_md.o(RESET)

TIM1_UP_IRQHandler (Thumb, 0 bytes, Stack size 0 bytes, startup_stm32f10x_md.o(.text))
[Address Reference Count : 1]

- startup_stm32f10x_md.o(RESET)

USART2_IRQHandler (Thumb, 0 bytes, Stack size 0 bytes, startup_stm32f10x_md.o(.text))
[Address Reference Count : 1]

- startup_stm32f10x_md.o(RESET)

USART3_IRQHandler (Thumb, 0 bytes, Stack size 0 bytes, startup_stm32f10x_md.o(.text))
[Address Reference Count : 1]

- startup_stm32f10x_md.o(RESET)

USBWakeUp_IRQHandler (Thumb, 0 bytes, Stack size 0 bytes, startup_stm32f10x_md.o(.text))
[Address Reference Count : 1]

- startup_stm32f10x_md.o(RESET)

USB_HP_CAN1_TX_IRQHandler (Thumb, 0 bytes, Stack size 0 bytes, startup_stm32f10x_md.o(.text))
[Address Reference Count : 1]

- startup_stm32f10x_md.o(RESET)

USB_LP_CAN1_RX0_IRQHandler (Thumb, 0 bytes, Stack size 0 bytes, startup_stm32f10x_md.o(.text))
[Address Reference Count : 1]

- startup_stm32f10x_md.o(RESET)

WWDG_IRQHandler (Thumb, 0 bytes, Stack size 0 bytes, startup_stm32f10x_md.o(.text))
[Address Reference Count : 1]

- startup_stm32f10x_md.o(RESET)

__user_initial_stackheap (Thumb, 0 bytes, Stack size unknown bytes, startup_stm32f10x_md.o(.text))

[Called By]

- >> __user_setup_stackheap

__use_no_semihosting (Thumb, 2 bytes, Stack size 0 bytes, use_no_semi_2.o(.text), UNUSED)

__2printf (Thumb, 20 bytes, Stack size 24 bytes, noretval__2printf.o(.text))

[Stack]

- Max Depth = 136 + Unknown Stack Size
- Call Chain = __2printf ⇒ _printf_char_file ⇒ _printf_char_common ⇒ __printf

[Calls]

- >> _printf_char_file

[Called By]

- >> main

_printf_pre_padding (Thumb, 44 bytes, Stack size 16 bytes, _printf_pad.o(.text))

[Stack]

- Max Depth = 16
- Call Chain = _printf_pre_padding

[Called By]

- >> _printf_fp_infnan
- >> _printf_fp_dec_real
- >> _printf_int_common

_printf_post_padding (Thumb, 34 bytes, Stack size 16 bytes, _printf_pad.o(.text))

[Stack]

- Max Depth = 16
- Call Chain = _printf_post_padding

[Called By]

- >> _printf_fp_infnan
- >> _printf_fp_dec_real
- >> _printf_int_common

_printf_int_dec (Thumb, 104 bytes, Stack size 24 bytes, _printf_dec.o(.text))

[Stack]

- Max Depth = 72
- Call Chain = _printf_int_dec ⇒ _printf_int_common ⇒ _printf_post_padding

[Calls]

- >> _printf_int_common

[Called By]

- >> _printf_d

__printf (Thumb, 270 bytes, Stack size 32 bytes, __printf_wp.o(.text))

[Stack]

- Max Depth = 32 + Unknown Stack Size
- Call Chain = __printf

[Calls]

- >> _printf_percent
- >> _is_digit

[Called By]

- >> _printf_char_common

__use_two_region_memory (Thumb, 2 bytes, Stack size 0 bytes, heapauxi.o(.text), UNUSED)

__rt_heap_escrow$2region (Thumb, 2 bytes, Stack size 0 bytes, heapauxi.o(.text), UNUSED)

__rt_heap_expand$2region (Thumb, 2 bytes, Stack size 0 bytes, heapauxi.o(.text), UNUSED)

__I$use$semihosting (Thumb, 0 bytes, Stack size 0 bytes, use_no_semi.o(.text), UNUSED)

__use_no_semihosting_swi (Thumb, 2 bytes, Stack size 0 bytes, use_no_semi.o(.text), UNUSED)

_printf_int_common (Thumb, 178 bytes, Stack size 32 bytes, _printf_intcommon.o(.text))

[Stack]

- Max Depth = 48
- Call Chain = _printf_int_common ⇒ _printf_post_padding

[Calls]

- >> _printf_post_padding
- >> _printf_pre_padding

[Called By]

- >> _printf_int_dec

__lib_sel_fp_printf (Thumb, 2 bytes, Stack size 0 bytes, _printf_fp_dec.o(.text), UNUSED)

_printf_fp_dec_real (Thumb, 620 bytes, Stack size 104 bytes, _printf_fp_dec.o(.text))

[Stack]

- Max Depth = 324
- Call Chain = _printf_fp_dec_real ⇒ _fp_digits ⇒ _btod_etento ⇒ _btod_emul ⇒ _e2e

[Calls]

- >> __ARM_fpclassify
- >> _printf_fp_infnan
- >> __rt_locale
- >> _fp_digits
- >> _printf_post_padding
- >> _printf_pre_padding

[Called By]

- >> _printf_fp_dec

_printf_char_file (Thumb, 32 bytes, Stack size 16 bytes, _printf_char_file.o(.text))

[Stack]

- Max Depth = 112 + Unknown Stack Size
- Call Chain = _printf_char_file ⇒ _printf_char_common ⇒ __printf

[Calls]

- >> ferror
- >> _printf_char_common

[Called By]

- >> __2printf

__rt_locale (Thumb, 8 bytes, Stack size 0 bytes, rt_locale_intlibspace.o(.text))

[Called By]

- >> __rt_lib_init_lc_common
- >> _printf_fp_dec_real

_ll_udiv10 (Thumb, 138 bytes, Stack size 12 bytes, lludiv10.o(.text))

[Stack]

- Max Depth = 12
- Call Chain = _ll_udiv10

[Called By]

- >> _fp_digits

_printf_char_common (Thumb, 32 bytes, Stack size 64 bytes, _printf_char_common.o(.text))

[Stack]

- Max Depth = 96 + Unknown Stack Size
- Call Chain = _printf_char_common ⇒ __printf

[Calls]

- >> __printf

[Called By]

- >> _printf_char_file

_printf_fp_infnan (Thumb, 112 bytes, Stack size 24 bytes, _printf_fp_infnan.o(.text))

[Stack]

- Max Depth = 40
- Call Chain = _printf_fp_infnan ⇒ _printf_post_padding

[Calls]

- >> _printf_post_padding
- >> _printf_pre_padding

[Called By]

- >> _printf_fp_dec_real

_btod_etento (Thumb, 224 bytes, Stack size 72 bytes, bigflt0.o(.text))

[Stack]

- Max Depth = 124
- Call Chain = _btod_etento ⇒ _btod_emul ⇒ _e2e

[Calls]

- >> _btod_emul
- >> _btod_ediv

[Called By]

- >> _fp_digits

ferror (Thumb, 8 bytes, Stack size 0 bytes, ferror.o(.text))

[Called By]

- >> _printf_char_file

__user_libspace (Thumb, 8 bytes, Stack size 0 bytes, libspace.o(.text), UNUSED)

__user_perproc_libspace (Thumb, 0 bytes, Stack size 0 bytes, libspace.o(.text))

[Called By]

- >> __user_setup_stackheap

__user_perthread_libspace (Thumb, 0 bytes, Stack size 0 bytes, libspace.o(.text), UNUSED)

__user_setup_stackheap (Thumb, 74 bytes, Stack size 8 bytes, sys_stackheap_outer.o(.text))

[Stack]

- Max Depth = 8 + Unknown Stack Size
- Call Chain = __user_setup_stackheap

[Calls]

- >> __user_initial_stackheap
- >> __user_perproc_libspace

[Called By]

- >> __rt_entry_sh

exit (Thumb, 18 bytes, Stack size 8 bytes, exit.o(.text))

[Stack]

- Max Depth = 8 + Unknown Stack Size
- Call Chain = exit

[Calls]

- >> __rt_exit

[Called By]

- >> __rt_entry_main

strcmp (Thumb, 128 bytes, Stack size 0 bytes, strcmpv7m.o(.text))

[Called By]

- >> _get_lc_numeric

_btod_d2e (Thumb, 62 bytes, Stack size 0 bytes, btod.o(CL$$btod_d2e))

[Calls]

- >> _d2e_norm_op1

[Called By]

- >> _fp_digits

_d2e_denorm_low (Thumb, 70 bytes, Stack size 0 bytes, btod.o(CL$$btod_d2e_denorm_low))

[Called By]

- >> _d2e_norm_op1

_d2e_norm_op1 (Thumb, 96 bytes, Stack size 0 bytes, btod.o(CL$$btod_d2e_norm_op1))

[Calls]

- >> _d2e_denorm_low

[Called By]

- >> _btod_d2e

__btod_div_common (Thumb, 696 bytes, Stack size 24 bytes, btod.o(CL$$btod_div_common))

[Stack]

- Max Depth = 24
- Call Chain = __btod_div_common

[Called By]

- >> _btod_ediv

_e2e (Thumb, 220 bytes, Stack size 24 bytes, btod.o(CL$$btod_e2e))

[Stack]

- Max Depth = 24
- Call Chain = _e2e

[Called By]

- >> _btod_emul
- >> _btod_ediv

_btod_ediv (Thumb, 42 bytes, Stack size 28 bytes, btod.o(CL$$btod_ediv))

[Stack]

- Max Depth = 52
- Call Chain = _btod_ediv ⇒ _e2e

[Calls]

- >> _e2e
- >> __btod_div_common

[Called By]

- >> _btod_etento
- >> _fp_digits

_btod_emul (Thumb, 42 bytes, Stack size 28 bytes, btod.o(CL$$btod_emul))

[Stack]

- Max Depth = 52
- Call Chain = _btod_emul ⇒ _e2e

[Calls]

- >> __btod_mult_common
- >> _e2e

[Called By]

- >> _btod_etento
- >> _fp_digits

__btod_mult_common (Thumb, 580 bytes, Stack size 16 bytes, btod.o(CL$$btod_mult_common))

[Stack]

- Max Depth = 16
- Call Chain = __btod_mult_common

[Called By]

- >> _btod_emul

ADC_Cmd (Thumb, 22 bytes, Stack size 0 bytes, stm32f10x_adc.o(i.ADC_Cmd))

[Called By]

- >> adc_Init

ADC_DeInit (Thumb, 78 bytes, Stack size 8 bytes, stm32f10x_adc.o(i.ADC_DeInit))

[Stack]

- Max Depth = 8
- Call Chain = ADC_DeInit

[Calls]

- >> RCC_APB2PeriphResetCmd

[Called By]

- >> adc_Init

ADC_GetCalibrationStatus (Thumb, 20 bytes, Stack size 0 bytes, stm32f10x_adc.o(i.ADC_GetCalibrationStatus))

[Called By]

- >> adc_Init

ADC_GetConversionValue (Thumb, 8 bytes, Stack size 0 bytes, stm32f10x_adc.o(i.ADC_GetConversionValue))

[Called By]

- >> Get_adc

ADC_GetFlagStatus (Thumb, 18 bytes, Stack size 0 bytes, stm32f10x_adc.o(i.ADC_GetFlagStatus))

[Called By]

- >> Get_adc

ADC_GetResetCalibrationStatus (Thumb, 20 bytes, Stack size 0 bytes, stm32f10x_adc.o(i.ADC_GetResetCalibrationStatus))

[Called By]

- >> adc_Init

ADC_Init (Thumb, 70 bytes, Stack size 12 bytes, stm32f10x_adc.o(i.ADC_Init))

[Stack]

- Max Depth = 12
- Call Chain = ADC_Init

[Called By]

- >> adc_Init

ADC_RegularChannelConfig (Thumb, 184 bytes, Stack size 20 bytes, stm32f10x_adc.o(i.ADC_RegularChannelConfig))

[Stack]

- Max Depth = 20
- Call Chain = ADC_RegularChannelConfig

[Called By]

- >> Get_adc

ADC_ResetCalibration (Thumb, 10 bytes, Stack size 0 bytes, stm32f10x_adc.o(i.ADC_ResetCalibration))

[Called By]

- >> adc_Init

ADC_SoftwareStartConvCmd (Thumb, 22 bytes, Stack size 0 bytes, stm32f10x_adc.o(i.ADC_SoftwareStartConvCmd))

[Called By]

- >> Get_adc

ADC_StartCalibration (Thumb, 10 bytes, Stack size 0 bytes, stm32f10x_adc.o(i.ADC_StartCalibration))

[Called By]

- >> adc_Init

BusFault_Handler (Thumb, 4 bytes, Stack size 0 bytes, stm32f10x_it.o(i.BusFault_Handler))
[Address Reference Count : 1]

- startup_stm32f10x_md.o(RESET)

DebugMon_Handler (Thumb, 2 bytes, Stack size 0 bytes, stm32f10x_it.o(i.DebugMon_Handler))
[Address Reference Count : 1]

- startup_stm32f10x_md.o(RESET)

Encoder_Init_Tim2 (Thumb, 192 bytes, Stack size 32 bytes, encoder.o(i.Encoder_Init_Tim2))

[Stack]

- Max Depth = 68
- Call Chain = Encoder_Init_Tim2 ⇒ TIM_ICInit ⇒ TI4_Config

[Calls]

- >> GPIO_PinRemapConfig
- >> GPIO_Init
- >> RCC_APB2PeriphClockCmd
- >> RCC_APB1PeriphClockCmd
- >> TIM_TimeBaseStructInit
- >> TIM_TimeBaseInit
- >> TIM_SetCounter
- >> TIM_ITConfig
- >> TIM_ICStructInit
- >> TIM_ICInit
- >> TIM_EncoderInterfaceConfig
- >> TIM_Cmd
- >> TIM_ClearFlag

[Called By]

- >> main

Encoder_Init_Tim3 (Thumb, 148 bytes, Stack size 32 bytes, encoder.o(i.Encoder_Init_Tim3))

[Stack]

- Max Depth = 68
- Call Chain = Encoder_Init_Tim3 ⇒ TIM_ICInit ⇒ TI4_Config

[Calls]

- >> GPIO_Init
- >> RCC_APB2PeriphClockCmd
- >> RCC_APB1PeriphClockCmd
- >> TIM_TimeBaseStructInit
- >> TIM_TimeBaseInit
- >> TIM_SetCounter
- >> TIM_ITConfig
- >> TIM_ICStructInit
- >> TIM_ICInit
- >> TIM_EncoderInterfaceConfig
- >> TIM_Cmd
- >> TIM_ClearFlag

[Called By]

- >> main

Encoder_Init_Tim4 (Thumb, 148 bytes, Stack size 32 bytes, encoder.o(i.Encoder_Init_Tim4))

[Stack]

- Max Depth = 68
- Call Chain = Encoder_Init_Tim4 ⇒ TIM_ICInit ⇒ TI4_Config

[Calls]

- >> GPIO_Init
- >> RCC_APB2PeriphClockCmd
- >> RCC_APB1PeriphClockCmd
- >> TIM_TimeBaseStructInit
- >> TIM_TimeBaseInit
- >> TIM_SetCounter
- >> TIM_ITConfig
- >> TIM_ICStructInit
- >> TIM_ICInit
- >> TIM_EncoderInterfaceConfig
- >> TIM_Cmd
- >> TIM_ClearFlag

[Called By]

- >> main

Encoder_Init_Tim8 (Thumb, 148 bytes, Stack size 32 bytes, encoder.o(i.Encoder_Init_Tim8))

[Stack]

- Max Depth = 68
- Call Chain = Encoder_Init_Tim8 ⇒ TIM_ICInit ⇒ TI4_Config

[Calls]

- >> GPIO_Init
- >> RCC_APB2PeriphClockCmd
- >> TIM_TimeBaseStructInit
- >> TIM_TimeBaseInit
- >> TIM_SetCounter
- >> TIM_ITConfig
- >> TIM_ICStructInit
- >> TIM_ICInit
- >> TIM_EncoderInterfaceConfig
- >> TIM_Cmd
- >> TIM_ClearFlag

[Called By]

- >> main

GPIO_Init (Thumb, 278 bytes, Stack size 24 bytes, stm32f10x_gpio.o(i.GPIO_Init))

[Stack]

- Max Depth = 24
- Call Chain = GPIO_Init

[Called By]

- >> uart_init
- >> adc_Init
- >> PWM_Int
- >> Gpio_Init
- >> Encoder_Init_Tim8
- >> Encoder_Init_Tim4
- >> Encoder_Init_Tim3
- >> Encoder_Init_Tim2

GPIO_PinRemapConfig (Thumb, 138 bytes, Stack size 20 bytes, stm32f10x_gpio.o(i.GPIO_PinRemapConfig))

[Stack]

- Max Depth = 20
- Call Chain = GPIO_PinRemapConfig

[Called By]

- >> Encoder_Init_Tim2

GPIO_ResetBits (Thumb, 4 bytes, Stack size 0 bytes, stm32f10x_gpio.o(i.GPIO_ResetBits))

[Called By]

- >> Set_PWM

GPIO_SetBits (Thumb, 4 bytes, Stack size 0 bytes, stm32f10x_gpio.o(i.GPIO_SetBits))

[Called By]

- >> Set_PWM

Get_adc (Thumb, 46 bytes, Stack size 8 bytes, adc.o(i.Get_adc))

[Stack]

- Max Depth = 28
- Call Chain = Get_adc ⇒ ADC_RegularChannelConfig

[Calls]

- >> ADC_SoftwareStartConvCmd
- >> ADC_RegularChannelConfig
- >> ADC_GetFlagStatus
- >> ADC_GetConversionValue

[Called By]

- >> Get_adc_Average

Get_adc_Average (Thumb, 46 bytes, Stack size 24 bytes, adc.o(i.Get_adc_Average))

[Stack]

- Max Depth = 52
- Call Chain = Get_adc_Average ⇒ Get_adc ⇒ ADC_RegularChannelConfig

[Calls]

- >> delay_ms
- >> Get_adc

[Called By]

- >> main

Gpio_Init (Thumb, 68 bytes, Stack size 8 bytes, gpio.o(i.Gpio_Init))

[Stack]

- Max Depth = 32
- Call Chain = Gpio_Init ⇒ GPIO_Init

[Calls]

- >> GPIO_Init
- >> RCC_APB2PeriphClockCmd

[Called By]

- >> main

HardFault_Handler (Thumb, 4 bytes, Stack size 0 bytes, stm32f10x_it.o(i.HardFault_Handler))
[Address Reference Count : 1]

- startup_stm32f10x_md.o(RESET)

MemManage_Handler (Thumb, 4 bytes, Stack size 0 bytes, stm32f10x_it.o(i.MemManage_Handler))
[Address Reference Count : 1]

- startup_stm32f10x_md.o(RESET)

NMI_Handler (Thumb, 2 bytes, Stack size 0 bytes, stm32f10x_it.o(i.NMI_Handler))
[Address Reference Count : 1]

- startup_stm32f10x_md.o(RESET)

NVIC_Init (Thumb, 100 bytes, Stack size 16 bytes, misc.o(i.NVIC_Init))

[Stack]

- Max Depth = 16
- Call Chain = NVIC_Init

[Called By]

- >> uart_init

PWM_Int (Thumb, 182 bytes, Stack size 48 bytes, pwm.o(i.PWM_Int))

[Stack]

- Max Depth = 72
- Call Chain = PWM_Int ⇒ GPIO_Init

[Calls]

- >> GPIO_Init
- >> RCC_APB2PeriphClockCmd
- >> RCC_APB1PeriphClockCmd
- >> TIM_TimeBaseInit
- >> TIM_OC4PreloadConfig
- >> TIM_OC4Init
- >> TIM_OC3PreloadConfig
- >> TIM_OC3Init
- >> TIM_OC2PreloadConfig
- >> TIM_OC2Init
- >> TIM_OC1PreloadConfig
- >> TIM_OC1Init
- >> TIM_Cmd
- >> TIM_ARRPreloadConfig

[Called By]

- >> main

PendSV_Handler (Thumb, 2 bytes, Stack size 0 bytes, stm32f10x_it.o(i.PendSV_Handler))
[Address Reference Count : 1]

- startup_stm32f10x_md.o(RESET)

RCC_ADCCLKConfig (Thumb, 18 bytes, Stack size 0 bytes, stm32f10x_rcc.o(i.RCC_ADCCLKConfig))

[Called By]

- >> adc_Init

RCC_APB1PeriphClockCmd (Thumb, 26 bytes, Stack size 0 bytes, stm32f10x_rcc.o(i.RCC_APB1PeriphClockCmd))

[Called By]

- >> PWM_Int
- >> Encoder_Init_Tim4
- >> Encoder_Init_Tim3
- >> Encoder_Init_Tim2

RCC_APB2PeriphClockCmd (Thumb, 26 bytes, Stack size 0 bytes, stm32f10x_rcc.o(i.RCC_APB2PeriphClockCmd))

[Called By]

- >> uart_init
- >> adc_Init
- >> PWM_Int
- >> Gpio_Init
- >> Encoder_Init_Tim8
- >> Encoder_Init_Tim4
- >> Encoder_Init_Tim3
- >> Encoder_Init_Tim2

RCC_APB2PeriphResetCmd (Thumb, 26 bytes, Stack size 0 bytes, stm32f10x_rcc.o(i.RCC_APB2PeriphResetCmd))

[Called By]

- >> ADC_DeInit

RCC_GetClocksFreq (Thumb, 192 bytes, Stack size 12 bytes, stm32f10x_rcc.o(i.RCC_GetClocksFreq))

[Stack]

- Max Depth = 12
- Call Chain = RCC_GetClocksFreq

[Called By]

- >> USART_Init

Read_Encoder (Thumb, 86 bytes, Stack size 0 bytes, encoder.o(i.Read_Encoder))

[Called By]

- >> main

SVC_Handler (Thumb, 2 bytes, Stack size 0 bytes, stm32f10x_it.o(i.SVC_Handler))
[Address Reference Count : 1]

- startup_stm32f10x_md.o(RESET)

Set_PWM (Thumb, 256 bytes, Stack size 24 bytes, pwm.o(i.Set_PWM))

[Stack]

- Max Depth = 24
- Call Chain = Set_PWM

[Calls]

- >> GPIO_SetBits
- >> GPIO_ResetBits
- >> TIM_SetCompare4
- >> TIM_SetCompare3
- >> TIM_SetCompare2
- >> TIM_SetCompare1
- >> myabs

[Called By]

- >> main

SysTick_CLKSourceConfig (Thumb, 40 bytes, Stack size 0 bytes, misc.o(i.SysTick_CLKSourceConfig))

[Called By]

- >> delay_init

SysTick_Handler (Thumb, 2 bytes, Stack size 0 bytes, stm32f10x_it.o(i.SysTick_Handler))
[Address Reference Count : 1]

- startup_stm32f10x_md.o(RESET)

SystemInit (Thumb, 78 bytes, Stack size 8 bytes, system_stm32f10x.o(i.SystemInit))

[Stack]

- Max Depth = 28
- Call Chain = SystemInit ⇒ SetSysClock ⇒ SetSysClockTo72

[Calls]

- >> SetSysClock

[Called By]

- >> main

[Address Reference Count : 1]

- startup_stm32f10x_md.o(.text)

TIM2_IRQHandler (Thumb, 24 bytes, Stack size 0 bytes, encoder.o(i.TIM2_IRQHandler))
[Address Reference Count : 1]

- startup_stm32f10x_md.o(RESET)

TIM3_IRQHandler (Thumb, 18 bytes, Stack size 0 bytes, encoder.o(i.TIM3_IRQHandler))
[Address Reference Count : 1]

- startup_stm32f10x_md.o(RESET)

TIM4_IRQHandler (Thumb, 18 bytes, Stack size 0 bytes, encoder.o(i.TIM4_IRQHandler))
[Address Reference Count : 1]

- startup_stm32f10x_md.o(RESET)

TIM_ARRPreloadConfig (Thumb, 24 bytes, Stack size 0 bytes, stm32f10x_tim.o(i.TIM_ARRPreloadConfig))

[Called By]

- >> PWM_Int

TIM_ClearFlag (Thumb, 6 bytes, Stack size 0 bytes, stm32f10x_tim.o(i.TIM_ClearFlag))

[Called By]

- >> Encoder_Init_Tim8
- >> Encoder_Init_Tim4
- >> Encoder_Init_Tim3
- >> Encoder_Init_Tim2

TIM_Cmd (Thumb, 24 bytes, Stack size 0 bytes, stm32f10x_tim.o(i.TIM_Cmd))

[Called By]

- >> PWM_Int
- >> Encoder_Init_Tim8
- >> Encoder_Init_Tim4
- >> Encoder_Init_Tim3
- >> Encoder_Init_Tim2

TIM_EncoderInterfaceConfig (Thumb, 66 bytes, Stack size 20 bytes, stm32f10x_tim.o(i.TIM_EncoderInterfaceConfig))

[Stack]

- Max Depth = 20
- Call Chain = TIM_EncoderInterfaceConfig

[Called By]

- >> Encoder_Init_Tim8
- >> Encoder_Init_Tim4
- >> Encoder_Init_Tim3
- >> Encoder_Init_Tim2

TIM_ICInit (Thumb, 150 bytes, Stack size 16 bytes, stm32f10x_tim.o(i.TIM_ICInit))

[Stack]

- Max Depth = 36
- Call Chain = TIM_ICInit ⇒ TI4_Config

[Calls]

- >> TIM_SetIC4Prescaler
- >> TIM_SetIC3Prescaler
- >> TIM_SetIC2Prescaler
- >> TIM_SetIC1Prescaler
- >> TI4_Config
- >> TI3_Config
- >> TI2_Config
- >> TI1_Config

[Called By]

- >> Encoder_Init_Tim8
- >> Encoder_Init_Tim4
- >> Encoder_Init_Tim3
- >> Encoder_Init_Tim2

TIM_ICStructInit (Thumb, 18 bytes, Stack size 0 bytes, stm32f10x_tim.o(i.TIM_ICStructInit))

[Called By]

- >> Encoder_Init_Tim8
- >> Encoder_Init_Tim4
- >> Encoder_Init_Tim3
- >> Encoder_Init_Tim2

TIM_ITConfig (Thumb, 18 bytes, Stack size 0 bytes, stm32f10x_tim.o(i.TIM_ITConfig))

[Called By]

- >> Encoder_Init_Tim8
- >> Encoder_Init_Tim4
- >> Encoder_Init_Tim3
- >> Encoder_Init_Tim2

TIM_OC1Init (Thumb, 132 bytes, Stack size 16 bytes, stm32f10x_tim.o(i.TIM_OC1Init))

[Stack]

- Max Depth = 16
- Call Chain = TIM_OC1Init

[Called By]

- >> PWM_Int

TIM_OC1PreloadConfig (Thumb, 18 bytes, Stack size 0 bytes, stm32f10x_tim.o(i.TIM_OC1PreloadConfig))

[Called By]

- >> PWM_Int

TIM_OC2Init (Thumb, 154 bytes, Stack size 16 bytes, stm32f10x_tim.o(i.TIM_OC2Init))

[Stack]

- Max Depth = 16
- Call Chain = TIM_OC2Init

[Called By]

- >> PWM_Int

TIM_OC2PreloadConfig (Thumb, 26 bytes, Stack size 0 bytes, stm32f10x_tim.o(i.TIM_OC2PreloadConfig))

[Called By]

- >> PWM_Int

TIM_OC3Init (Thumb, 150 bytes, Stack size 16 bytes, stm32f10x_tim.o(i.TIM_OC3Init))

[Stack]

- Max Depth = 16
- Call Chain = TIM_OC3Init

[Called By]

- >> PWM_Int

TIM_OC3PreloadConfig (Thumb, 18 bytes, Stack size 0 bytes, stm32f10x_tim.o(i.TIM_OC3PreloadConfig))

[Called By]

- >> PWM_Int

TIM_OC4Init (Thumb, 114 bytes, Stack size 16 bytes, stm32f10x_tim.o(i.TIM_OC4Init))

[Stack]

- Max Depth = 16
- Call Chain = TIM_OC4Init

[Called By]

- >> PWM_Int

TIM_OC4PreloadConfig (Thumb, 26 bytes, Stack size 0 bytes, stm32f10x_tim.o(i.TIM_OC4PreloadConfig))

[Called By]

- >> PWM_Int

TIM_SetCompare1 (Thumb, 4 bytes, Stack size 0 bytes, stm32f10x_tim.o(i.TIM_SetCompare1))

[Called By]

- >> Set_PWM

TIM_SetCompare2 (Thumb, 4 bytes, Stack size 0 bytes, stm32f10x_tim.o(i.TIM_SetCompare2))

[Called By]

- >> Set_PWM

TIM_SetCompare3 (Thumb, 4 bytes, Stack size 0 bytes, stm32f10x_tim.o(i.TIM_SetCompare3))

[Called By]

- >> Set_PWM

TIM_SetCompare4 (Thumb, 6 bytes, Stack size 0 bytes, stm32f10x_tim.o(i.TIM_SetCompare4))

[Called By]

- >> Set_PWM

TIM_SetCounter (Thumb, 4 bytes, Stack size 0 bytes, stm32f10x_tim.o(i.TIM_SetCounter))

[Called By]

- >> Encoder_Init_Tim8
- >> Encoder_Init_Tim4
- >> Encoder_Init_Tim3
- >> Encoder_Init_Tim2

TIM_SetIC1Prescaler (Thumb, 18 bytes, Stack size 0 bytes, stm32f10x_tim.o(i.TIM_SetIC1Prescaler))

[Called By]

- >> TIM_ICInit

TIM_SetIC2Prescaler (Thumb, 26 bytes, Stack size 0 bytes, stm32f10x_tim.o(i.TIM_SetIC2Prescaler))

[Called By]

- >> TIM_ICInit

TIM_SetIC3Prescaler (Thumb, 18 bytes, Stack size 0 bytes, stm32f10x_tim.o(i.TIM_SetIC3Prescaler))

[Called By]

- >> TIM_ICInit

TIM_SetIC4Prescaler (Thumb, 26 bytes, Stack size 0 bytes, stm32f10x_tim.o(i.TIM_SetIC4Prescaler))

[Called By]

- >> TIM_ICInit

TIM_TimeBaseInit (Thumb, 122 bytes, Stack size 0 bytes, stm32f10x_tim.o(i.TIM_TimeBaseInit))

[Called By]

- >> PWM_Int
- >> Encoder_Init_Tim8
- >> Encoder_Init_Tim4
- >> Encoder_Init_Tim3
- >> Encoder_Init_Tim2

TIM_TimeBaseStructInit (Thumb, 18 bytes, Stack size 0 bytes, stm32f10x_tim.o(i.TIM_TimeBaseStructInit))

[Called By]

- >> Encoder_Init_Tim8
- >> Encoder_Init_Tim4
- >> Encoder_Init_Tim3
- >> Encoder_Init_Tim2

USART1_IRQHandler (Thumb, 122 bytes, Stack size 8 bytes, usart.o(i.USART1_IRQHandler))

[Stack]

- Max Depth = 24
- Call Chain = USART1_IRQHandler ⇒ USART_GetITStatus

[Calls]

- >> USART_ReceiveData
- >> USART_GetITStatus

[Address Reference Count : 1]

- startup_stm32f10x_md.o(RESET)

USART_Cmd (Thumb, 24 bytes, Stack size 0 bytes, stm32f10x_usart.o(i.USART_Cmd))

[Called By]

- >> uart_init

USART_GetITStatus (Thumb, 84 bytes, Stack size 16 bytes, stm32f10x_usart.o(i.USART_GetITStatus))

[Stack]

- Max Depth = 16
- Call Chain = USART_GetITStatus

[Called By]

- >> USART1_IRQHandler

USART_ITConfig (Thumb, 74 bytes, Stack size 20 bytes, stm32f10x_usart.o(i.USART_ITConfig))

[Stack]

- Max Depth = 20
- Call Chain = USART_ITConfig

[Called By]

- >> uart_init

USART_Init (Thumb, 210 bytes, Stack size 56 bytes, stm32f10x_usart.o(i.USART_Init))

[Stack]

- Max Depth = 68
- Call Chain = USART_Init ⇒ RCC_GetClocksFreq

[Calls]

- >> RCC_GetClocksFreq

[Called By]

- >> uart_init

USART_ReceiveData (Thumb, 10 bytes, Stack size 0 bytes, stm32f10x_usart.o(i.USART_ReceiveData))

[Called By]

- >> USART1_IRQHandler

UsageFault_Handler (Thumb, 4 bytes, Stack size 0 bytes, stm32f10x_it.o(i.UsageFault_Handler))
[Address Reference Count : 1]

- startup_stm32f10x_md.o(RESET)

__ARM_fpclassify (Thumb, 40 bytes, Stack size 0 bytes, fpclassify.o(i.__ARM_fpclassify))

[Called By]

- >> _printf_fp_dec_real

_is_digit (Thumb, 14 bytes, Stack size 0 bytes, __printf_wp.o(i._is_digit))

[Called By]

- >> __printf

_sys_exit (Thumb, 6 bytes, Stack size 0 bytes, usart.o(i._sys_exit))

[Called By]

- >> __rt_exit_exit

adc_Init (Thumb, 132 bytes, Stack size 32 bytes, adc.o(i.adc_Init))

[Stack]

- Max Depth = 56
- Call Chain = adc_Init ⇒ GPIO_Init

[Calls]

- >> ADC_StartCalibration
- >> ADC_ResetCalibration
- >> ADC_Init
- >> ADC_GetResetCalibrationStatus
- >> ADC_GetCalibrationStatus
- >> ADC_DeInit
- >> ADC_Cmd
- >> GPIO_Init
- >> RCC_APB2PeriphClockCmd
- >> RCC_ADCCLKConfig

[Called By]

- >> main

delay_init (Thumb, 50 bytes, Stack size 8 bytes, delay.o(i.delay_init))

[Stack]

- Max Depth = 8
- Call Chain = delay_init

[Calls]

- >> SysTick_CLKSourceConfig

[Called By]

- >> main

delay_ms (Thumb, 72 bytes, Stack size 0 bytes, delay.o(i.delay_ms))

[Called By]

- >> Get_adc_Average

fputc (Thumb, 24 bytes, Stack size 0 bytes, usart.o(i.fputc))
[Address Reference Count : 1]

- _printf_char_file.o(.text)

main (Thumb, 210 bytes, Stack size 32 bytes, main.o(i.main))

[Stack]

- Max Depth = 168 + Unknown Stack Size
- Call Chain = main ⇒ __2printf ⇒ _printf_char_file ⇒ _printf_char_common ⇒ __printf

[Calls]

- >> uart_init
- >> delay_init
- >> adc_Init
- >> SystemInit
- >> Set_PWM
- >> Read_Encoder
- >> PWM_Int
- >> Gpio_Init
- >> Get_adc_Average
- >> Encoder_Init_Tim8
- >> Encoder_Init_Tim4
- >> Encoder_Init_Tim3
- >> Encoder_Init_Tim2
- >> __aeabi_ui2f
- >> __aeabi_f2d
- >> __aeabi_dmul
- >> __aeabi_d2f
- >> __2printf

[Called By]

- >> __rt_entry_main

myabs (Thumb, 8 bytes, Stack size 0 bytes, pwm.o(i.myabs))

[Called By]

- >> Set_PWM

uart_init (Thumb, 152 bytes, Stack size 32 bytes, usart.o(i.uart_init))

[Stack]

- Max Depth = 100
- Call Chain = uart_init ⇒ USART_Init ⇒ RCC_GetClocksFreq

[Calls]

- >> NVIC_Init
- >> GPIO_Init
- >> RCC_APB2PeriphClockCmd
- >> USART_Init
- >> USART_ITConfig
- >> USART_Cmd

[Called By]

- >> main

_get_lc_numeric (Thumb, 44 bytes, Stack size 8 bytes, lc_numeric_c.o(locale$$code))

[Stack]

- Max Depth = 8
- Call Chain = _get_lc_numeric

[Calls]

- >> strcmp

[Called By]

- >> __rt_lib_init_lc_numeric_2

__aeabi_d2f (Thumb, 0 bytes, Stack size 32 bytes, d2f.o(x$fpl$d2f))

[Stack]

- Max Depth = 32
- Call Chain = __aeabi_d2f

[Called By]

- >> main

_d2f (Thumb, 98 bytes, Stack size 32 bytes, d2f.o(x$fpl$d2f), UNUSED)

[Calls]

- >> __fpl_fretinf
- >> __fpl_dnaninf

__aeabi_dmul (Thumb, 0 bytes, Stack size 32 bytes, dmul.o(x$fpl$dmul))

[Stack]

- Max Depth = 32
- Call Chain = __aeabi_dmul

[Called By]

- >> main

_dmul (Thumb, 332 bytes, Stack size 32 bytes, dmul.o(x$fpl$dmul), UNUSED)

[Calls]

- >> __fpl_dretinf
- >> __fpl_dnaninf

__fpl_dnaninf (Thumb, 156 bytes, Stack size 16 bytes, dnaninf.o(x$fpl$dnaninf), UNUSED)

[Called By]

- >> _dmul
- >> _d2f

__fpl_dretinf (Thumb, 12 bytes, Stack size 0 bytes, dretinf.o(x$fpl$dretinf), UNUSED)

[Called By]

- >> _f2d
- >> _dmul

__aeabi_f2d (Thumb, 0 bytes, Stack size 16 bytes, f2d.o(x$fpl$f2d))

[Stack]

- Max Depth = 16
- Call Chain = __aeabi_f2d

[Called By]

- >> main

_f2d (Thumb, 86 bytes, Stack size 16 bytes, f2d.o(x$fpl$f2d), UNUSED)

[Calls]

- >> __fpl_fnaninf
- >> __fpl_dretinf

__aeabi_ui2f (Thumb, 0 bytes, Stack size 0 bytes, fflt_clz.o(x$fpl$ffltu))

[Called By]

- >> main

_ffltu (Thumb, 38 bytes, Stack size 0 bytes, fflt_clz.o(x$fpl$ffltu), UNUSED)

__fpl_fnaninf (Thumb, 140 bytes, Stack size 8 bytes, fnaninf.o(x$fpl$fnaninf), UNUSED)

[Called By]

- >> _f2d

__fpl_fretinf (Thumb, 10 bytes, Stack size 0 bytes, fretinf.o(x$fpl$fretinf), UNUSED)

[Called By]

- >> _d2f

_printf_fp_dec (Thumb, 4 bytes, Stack size 0 bytes, printf1.o(x$fpl$printf1))

[Stack]

- Max Depth = 324
- Call Chain = _printf_fp_dec ⇒ _printf_fp_dec_real ⇒ _fp_digits ⇒ _btod_etento ⇒ _btod_emul ⇒ _e2e

[Calls]

- >> _printf_fp_dec_real

[Called By]

- >> _printf_f

### Local Symbols

SetSysClock (Thumb, 8 bytes, Stack size 8 bytes, system_stm32f10x.o(i.SetSysClock))

[Stack]

- Max Depth = 20
- Call Chain = SetSysClock ⇒ SetSysClockTo72

[Calls]

- >> SetSysClockTo72

[Called By]

- >> SystemInit

SetSysClockTo72 (Thumb, 214 bytes, Stack size 12 bytes, system_stm32f10x.o(i.SetSysClockTo72))

[Stack]

- Max Depth = 12
- Call Chain = SetSysClockTo72

[Called By]

- >> SetSysClock

TI1_Config (Thumb, 108 bytes, Stack size 20 bytes, stm32f10x_tim.o(i.TI1_Config))

[Stack]

- Max Depth = 20
- Call Chain = TI1_Config

[Called By]

- >> TIM_ICInit

TI2_Config (Thumb, 130 bytes, Stack size 20 bytes, stm32f10x_tim.o(i.TI2_Config))

[Stack]

- Max Depth = 20
- Call Chain = TI2_Config

[Called By]

- >> TIM_ICInit

TI3_Config (Thumb, 122 bytes, Stack size 20 bytes, stm32f10x_tim.o(i.TI3_Config))

[Stack]

- Max Depth = 20
- Call Chain = TI3_Config

[Called By]

- >> TIM_ICInit

TI4_Config (Thumb, 130 bytes, Stack size 20 bytes, stm32f10x_tim.o(i.TI4_Config))

[Stack]

- Max Depth = 20
- Call Chain = TI4_Config

[Called By]

- >> TIM_ICInit

_fp_digits (Thumb, 432 bytes, Stack size 96 bytes, _printf_fp_dec.o(.text))

[Stack]

- Max Depth = 220
- Call Chain = _fp_digits ⇒ _btod_etento ⇒ _btod_emul ⇒ _e2e

[Calls]

- >> _btod_emul
- >> _btod_ediv
- >> _btod_d2e
- >> _btod_etento
- >> _ll_udiv10

[Called By]

- >> _printf_fp_dec_real

_printf_input_char (Thumb, 10 bytes, Stack size 0 bytes, _printf_char_common.o(.text))
[Address Reference Count : 1]

- _printf_char_common.o(.text)

### Undefined Global Symbols
