how2idealizefreedom/electric-car-ball-balance/hardware/WHEELTEC R1系列底盘客户资料/WHEELTEC R1系列底盘客户资料_2026.05.27/3.铰链支架安装说明/CDD可调节支架安装说明.pdf

## CDD 可调节支架安装说明

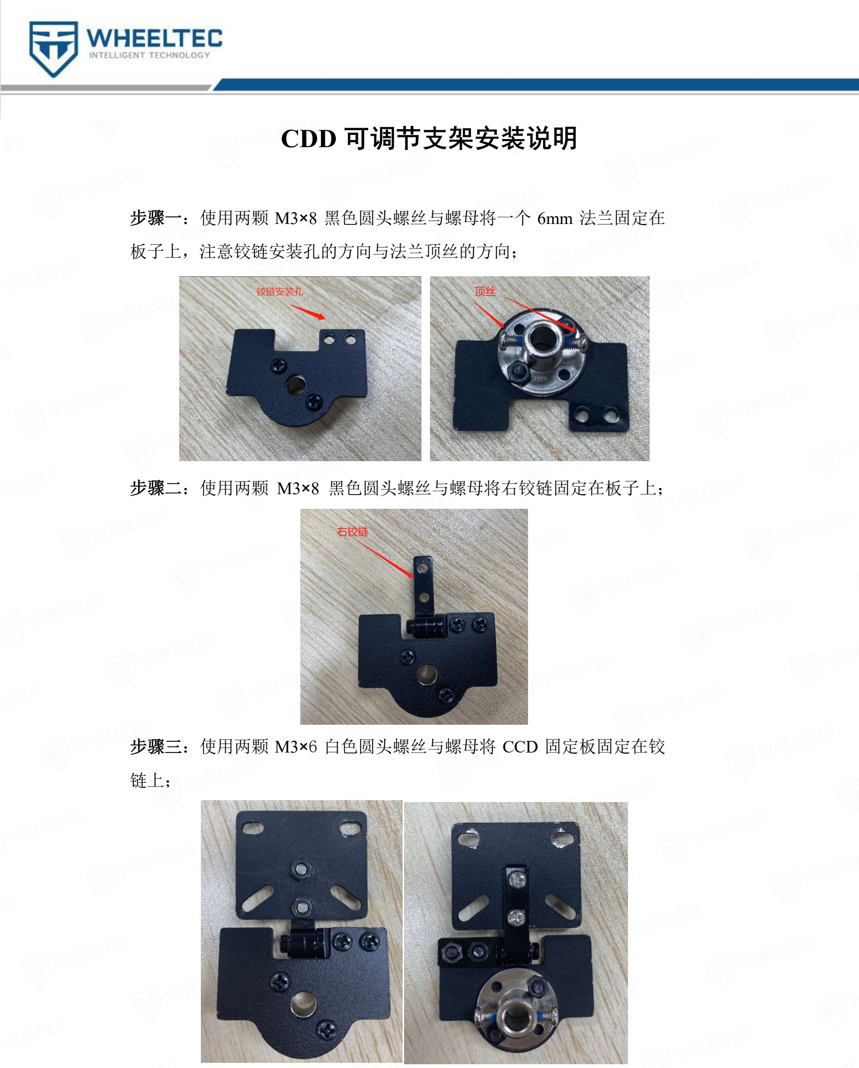
[picture p28: page 1]

步骤一：使用两颗 M3×8 黑色圆头螺丝与螺母将一个 6mm 法兰固定在

板子上，注意铰链安装孔的方向与法兰顶丝的方向；

步骤二：使用两颗 M3×8 黑色圆头螺丝与螺母将右铰链固定在板子上；

步骤三：使用两颗 M3×6 白色圆头螺丝与螺母将 CCD 固定板固定在铰

链上；

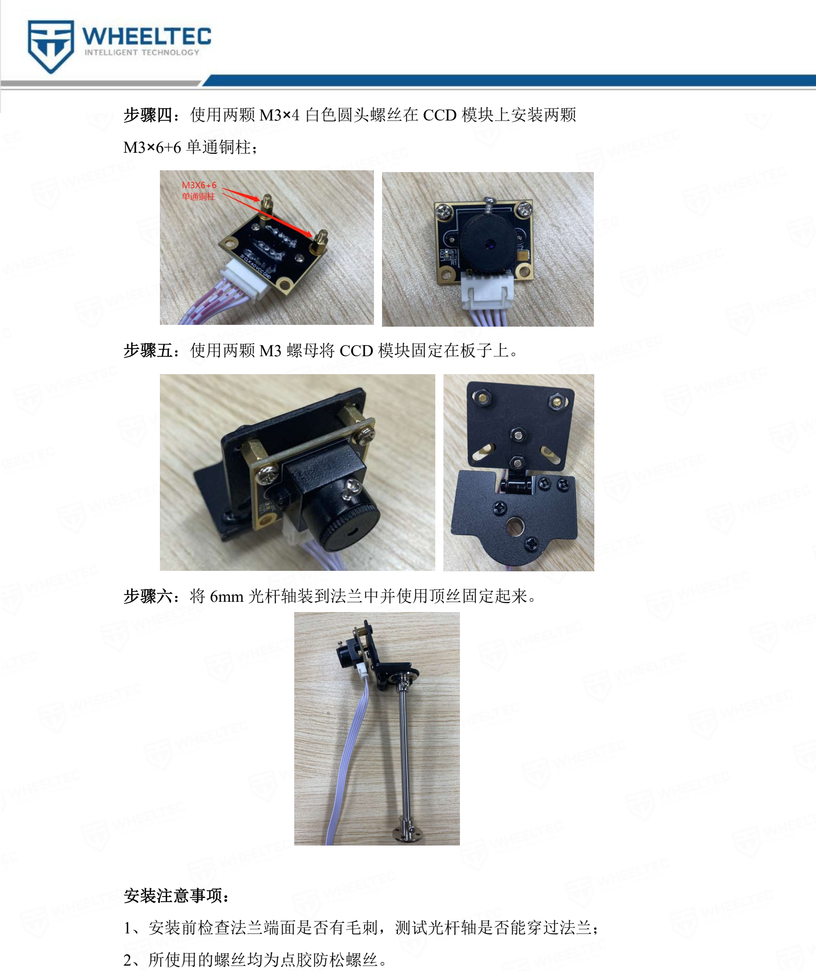
[picture p29: page 2]

步骤四：使用两颗 M3×4 白色圆头螺丝在 CCD 模块上安装两颗 M3×6+6 单通铜柱；

步骤五：使用两颗 M3 螺母将 CCD 模块固定在板子上。

步骤六：将 6mm 光杆轴装到法兰中并使用顶丝固定起来。

安装注意事项：

1、安装前检查法兰端面是否有毛刺，测试光杆轴是否能穿过法兰；

2、所使用的螺丝均为点胶防松螺丝。
