how2idealizefreedom/electric-car-ball-balance/docs/电赛资料/测试报告.pdf

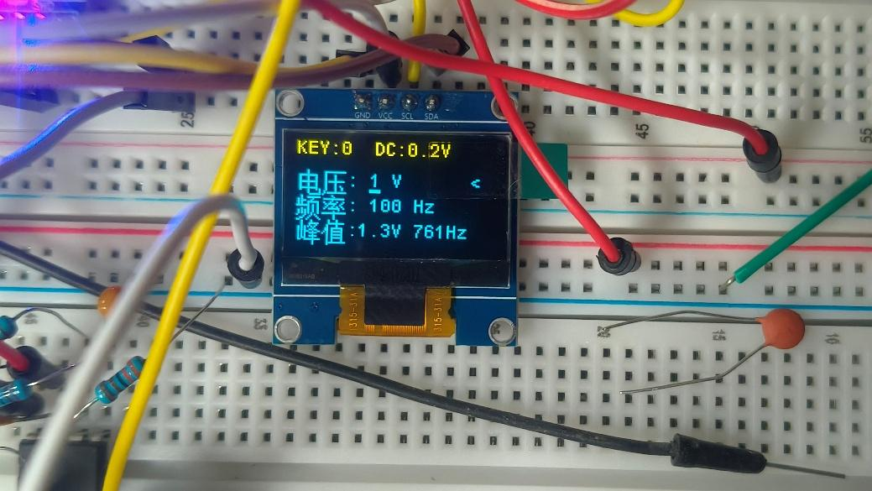
[picture p45: figure]

1 / 15

## 2026 年南开大学电子设计竞赛试题--评分表

组长 | 组员 1 | 组员 2 | 组长联系 电话
姓名：吕佳霖 学号：2411335 | 姓名：朱彦霖 学号：2411571 | 姓名：徐俊喆 学号：2411954 | 13664770236

## 实物制作题（120 分）

功能要求：
利用直流稳压电源、面包板或 PCB（自制）或万用板设计电路，设计并制作一个简易波形信号发生器，结构框图如图 1 所示。
分类 | 设计要求 | 分值 | 实现情况 | 照片 | 得 分
嵌入式处 理器最小 系统（ 20 分） | OLED 屏能显示汉 字 | 6 分 | 是

2 / 15

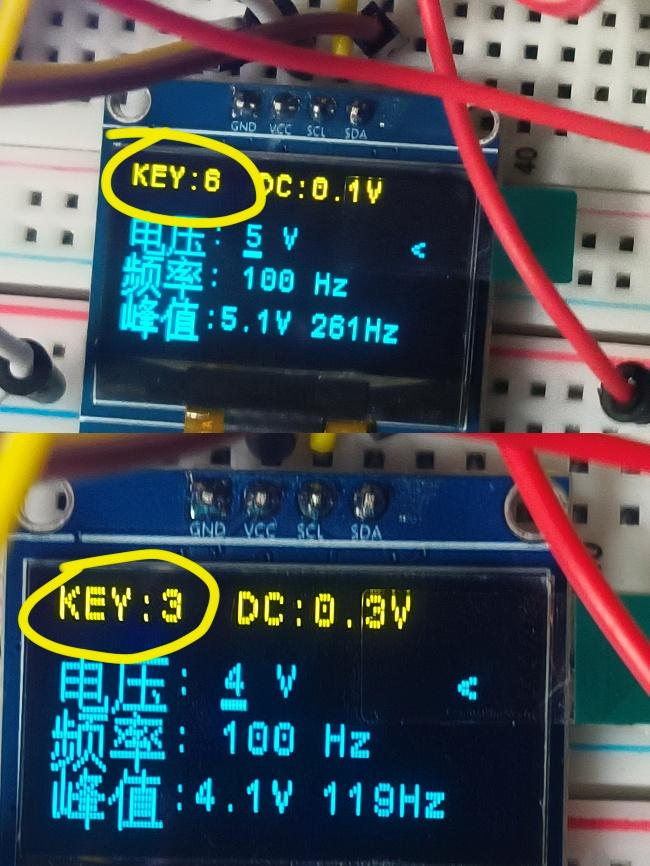
[picture p46: figure]

OLED 屏能显示按
键的次数

### 7 分 是

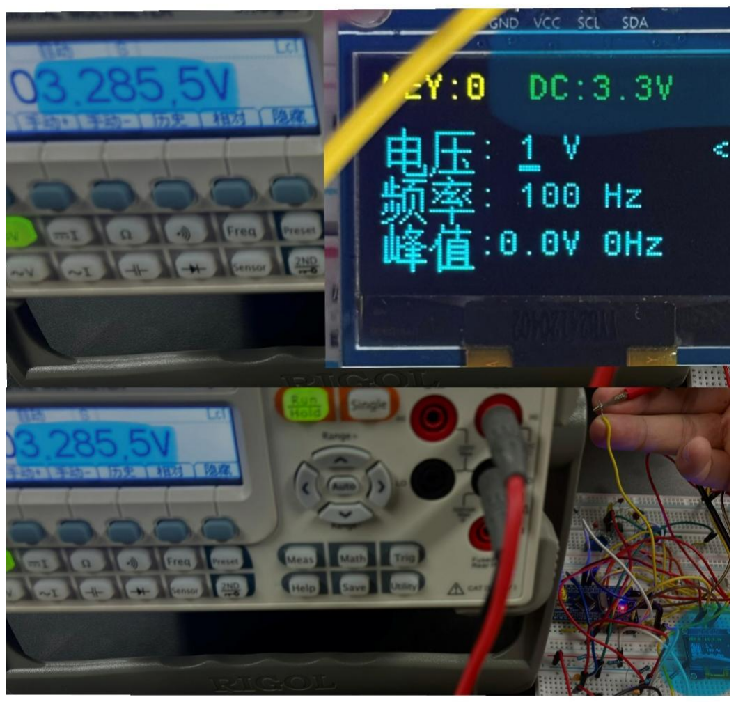
[picture p47: figure]

3 / 15

控制 ADC 可以采
集直流电压，并利
用 OLED 屏显示
7 分 | 被测电压万用表测量值：3.2855V
| 实际测量值（OLED 屏显示值）：3.3V

4 / 15

图 1 中“4.
输出端口”
位置产生
方波或正
弦波，频率
为 1000Hz
注：以上
1）2）3）项
自选 1 项
完成

1）方波的波形范围 0-3.3v， 即峰峰值 3.3v，平均值 1.65v （10 分）

2）方波的波形范围 -5v~+5v，即峰峰值 10v，平均值 0v（15 分） | 15

### 10 是否用了现成的信号发生模块/DAC/DDS

芯片：否

产生波形为：正弦波

波形峰峰值（示波器测量结果）：_10.2V_(-

5v~+5v)_______

波形平均值（示波器测量结果）：

_105mV_______
3）正弦波的波形范
围-5v~+5v，即峰峰
值 10v，平均值 0v
（20 分）

20

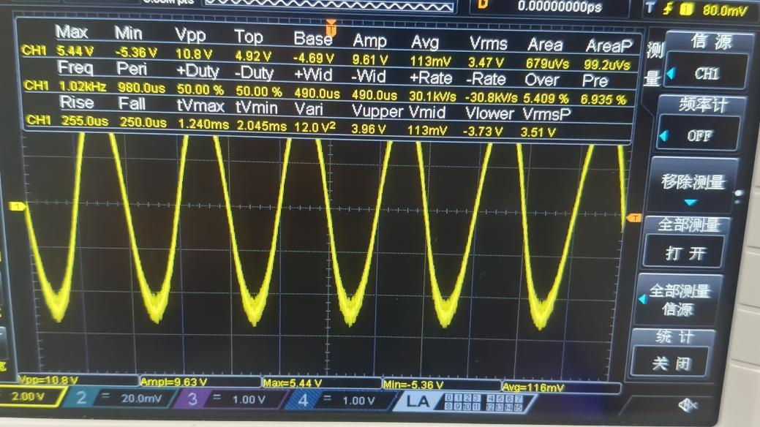
[picture p48: figure]

5 / 15

测量“4.输
出端口”输
出波形的
参数：

测量峰峰值，并利
用 OLED 屏显示测
量结果

### 10 分 是否用了成品的示波器或示波器模块：否 波形峰峰值（OLED 屏显示结果）：5.1v （给定峰峰值为 5v,频率为 1000Hz）

6 / 15

7 / 15

测量频率值，并利
用 OLED 屏显示测
量结果

### 10 是否用了成品的示波器或示波器模块：否

波形频率值（OLED 屏显示结果）：301Hz
（给定输入频率为 305Hz）

8 / 15

9 / 15

数控“4.输
出端口”输
出波形的
参数（满分

### 40 分）

注：以上
1）2）项自
选 1 项完
成。

1） 输出方波波形
的 峰 峰 值 数 控 可
调，范围 1~10v，步
进精度 1v（15 分）
输出方波波形
的 频 率 值 数 控 可
调 | ， | 范 | 围
100~1000Hz，步进
精度 100Hz（15 分）

15-15 是否用了现成的信号发生模块/DAC/DDS 芯片

数控方式：

产生波形为：

波形峰峰值及步进精度（示波器测量结
| 果）：范围：________________
| 步进精度：_______

波形频率值及步进精度（示波器测量结
| 果）：范围：________________
| 步进精度：_______

10 / 15

2） 输出正弦波波
形的峰峰值数控可
调，范围 1~10v，步
进精度 1v（20 分）
输出正弦波波
形的频率值数控可
调 | ， | 范 | 围
100~1000Hz，步进
精度 100Hz（20 分）

20-20 是否用了现成的信号发生模块/DAC/DDS 芯片：否

数控方式：按键

产生波形为：正弦波

波形峰峰值及步进精度（示波器测量结
果）：范围：1~10v

步进精度：1v

波形频率值及步进精度（示波器测量结
| 果）：范围：100~1000Hz

步进精度：1Hz

11 / 15

12 / 15

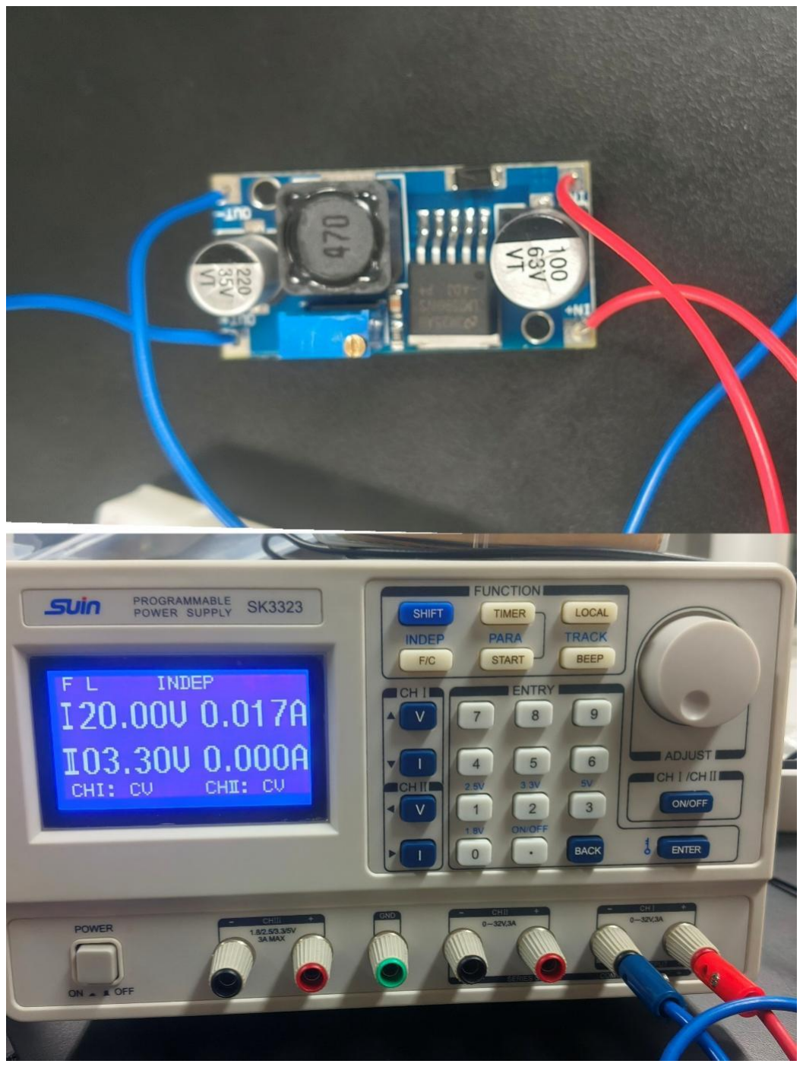
[picture p49: figure]

13 / 15

其他（满分

### 20 分）

1）系 统 的 供 电 方
式为单极性电源供
电

### 10 数控方式：单极性电源供电

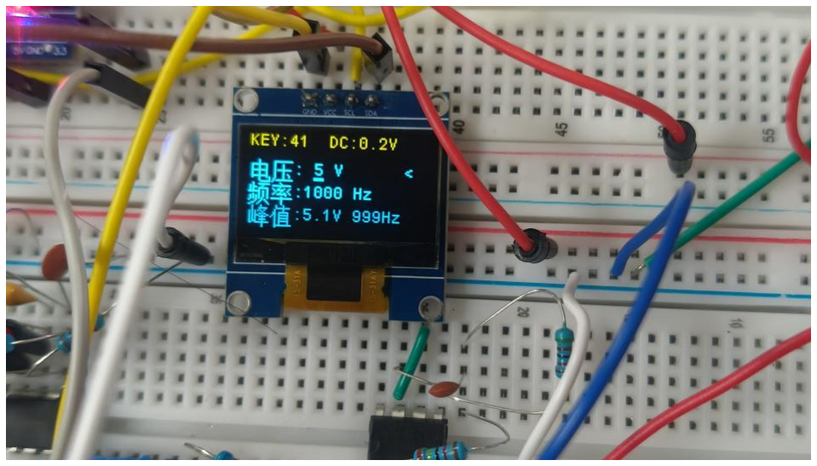
[picture p50: figure]

14 / 15

2）实 现 的 参 数 优
于题目的要求值，
比如：输出信号的
峰峰值、频率的步
进精度等参数

### 10 都发挥了哪些的参数：

频率的步进精度为 1Hz
输出信号的峰峰值 1v

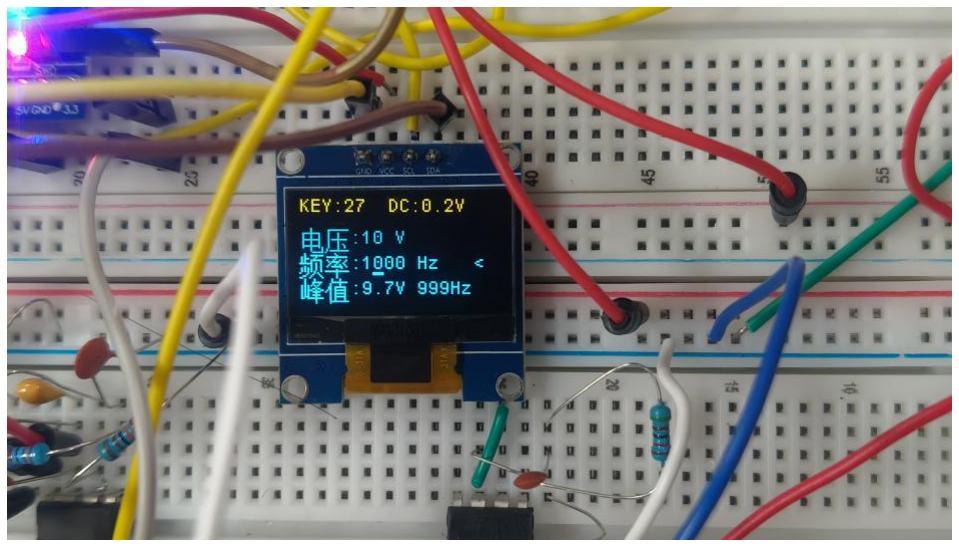
[picture p51: figure]

15 / 15
