how2idealizefreedom/electric-car-ball-balance/docs/电赛资料/0611.docx

## 第 1 页 封面

各位老师、同学大家好，今天我要汇报的课程展示主题是二维硒化铟光电突触器件在极端光照目标检测中的应用。背景是今年的大创项目，我们将从研究背景、核心技术与项目方案以及创新点出发来介绍。

## 第 2 页 研究背景

在自动驾驶辅助、智能安防等应用场景中，视觉系统常面临夜间弱光、强背光、局部过曝和阴影遮挡等“极端光照”挑战 。

第 3 页

传统方案多采用“先全量采集、再后端计算”模式 。

在后端算法修复层面，会造成过曝，即强光高光细节丢失，欠曝出现暗部噪点。

这种先采集后计算的冯·诺依曼架构带来了高延迟和海量冗余数据流 。

## 第 4页

## 光电突触器件不仅可以作为光电传感器，还兼具预处理光信息的功能。

## 该项目模仿人的视觉适应机制，提出了一种将计算处理放在传感器前端的“感内计算”的新架构 。

## 选择具有高光电导率、天然缺陷态，薄原子层厚度特性的二维硒化铟，利用高光电导率和缺陷诱导电荷俘获机制，模拟神经功能，能模仿人眼视网膜细胞，根据环境光强自主调节敏感度 ，在传感器前端直接完成图像预处理 。

## 第 5 页 总结

该项目针对极端光照视觉失效的痛点，提出了基于二维硒化铟光电突触的类脑感内计算架构，实现了宽动态范围成像和高精度目标检测。
这项技术不仅验证了神经形态器件的实用价值，也为下一代柔性智能视觉系统提供了新的思路。

第 6 页

以上就是我的汇报，感谢各位老师和同学的聆听，敬请批评指正！
