how2idealizefreedom/electric-car-ball-balance/docs/电赛资料/汇报(1).docx

第一周

我们组计划完成一个一阶/二阶倒立摆系统数学模型和串联PID控制原理与三闭环的平衡类题目。

选定主控（瑞萨板）、电机、角度传感器等器件，目前部分器件已购买。

对平衡类题目做了初步了解：

三闭环控制：

1. 最外环即位置环：输入是目标位置，反馈是小车的实际位置，输出是目标速度。
2. 中间环即速度环：输入是目标速度，反馈是小车实际速度，输出是目标角度。
3. 最内环即角度/直立环：输入是目标角度，反馈是摆杆实际角度，输出是电机的PWM控制量。

完成了配置开发环境 在电脑上配好了瑞萨的开发环境（e2 studio）。

下周（第二周）清点购买的器件是否完好，构思机械结构的初步拼接并完善器件购置清单。
