how2idealizefreedom/electric-car-ball-balance/hardware/WHEELTEC R1系列底盘客户资料/WHEELTEC R1系列底盘客户资料_2026.05.27/R1底盘万向轮安装说明.pdf

## R1 底盘万向轮安装说明

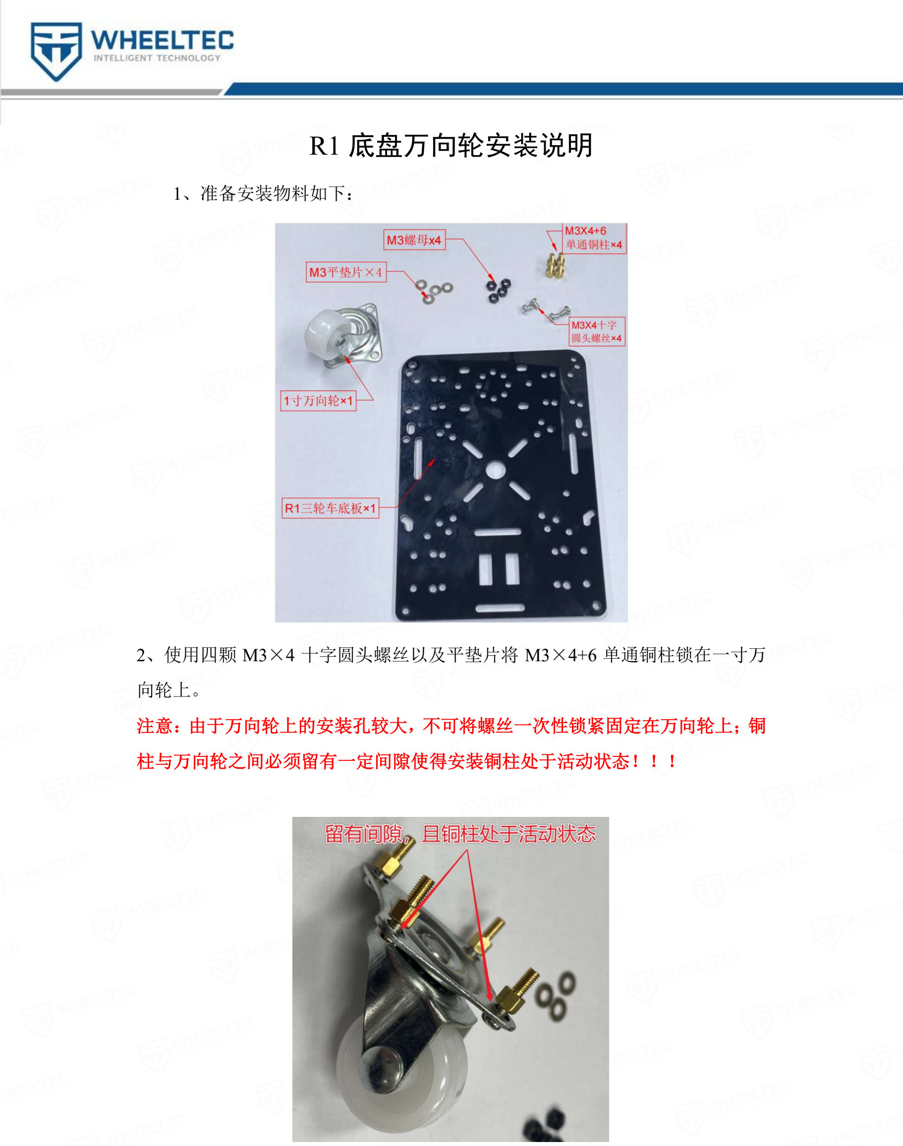
[picture p64: page 1]

1、准备安装物料如下：

2、使用四颗 M3×4 十字圆头螺丝以及平垫片将 M3×4+6 单通铜柱锁在一寸万

向轮上。

注意：由于万向轮上的安装孔较大，不可将螺丝一次性锁紧固定在万向轮上；铜

柱与万向轮之间必须留有一定间隙使得安装铜柱处于活动状态！！！

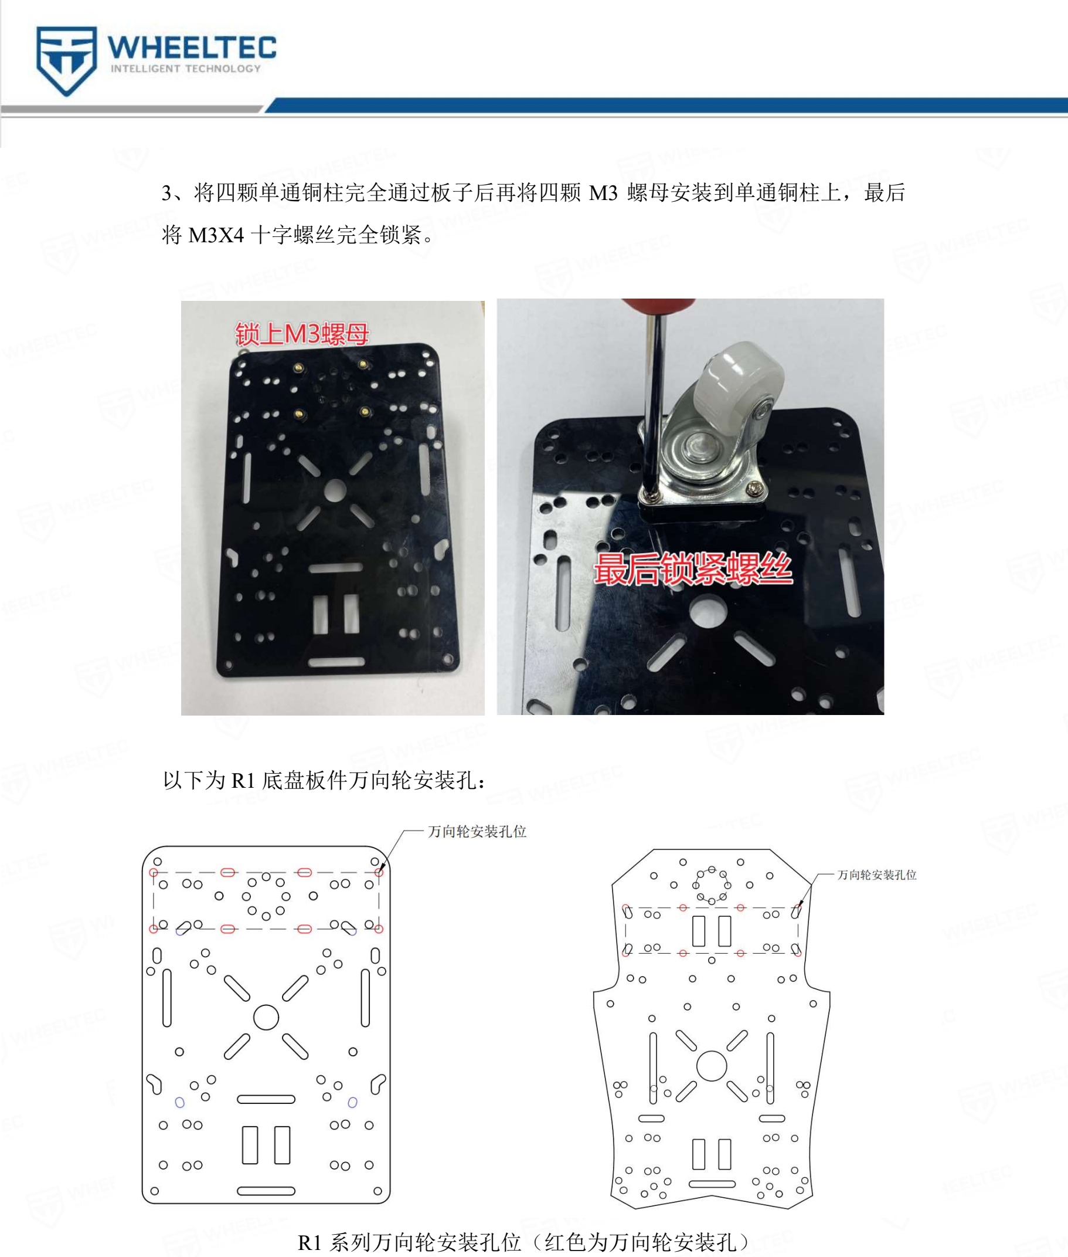
[picture p65: page 2]

3、将四颗单通铜柱完全通过板子后再将四颗 M3 螺母安装到单通铜柱上，最后

将 M3X4 十字螺丝完全锁紧。

以下为 R1 底盘板件万向轮安装孔：

R1 系列万向轮安装孔位（红色为万向轮安装孔）
