how2idealizefreedom/electric-car-ball-balance/hardware/天猛星拓展板/天猛星拓展板/拓展板PCB.pdf

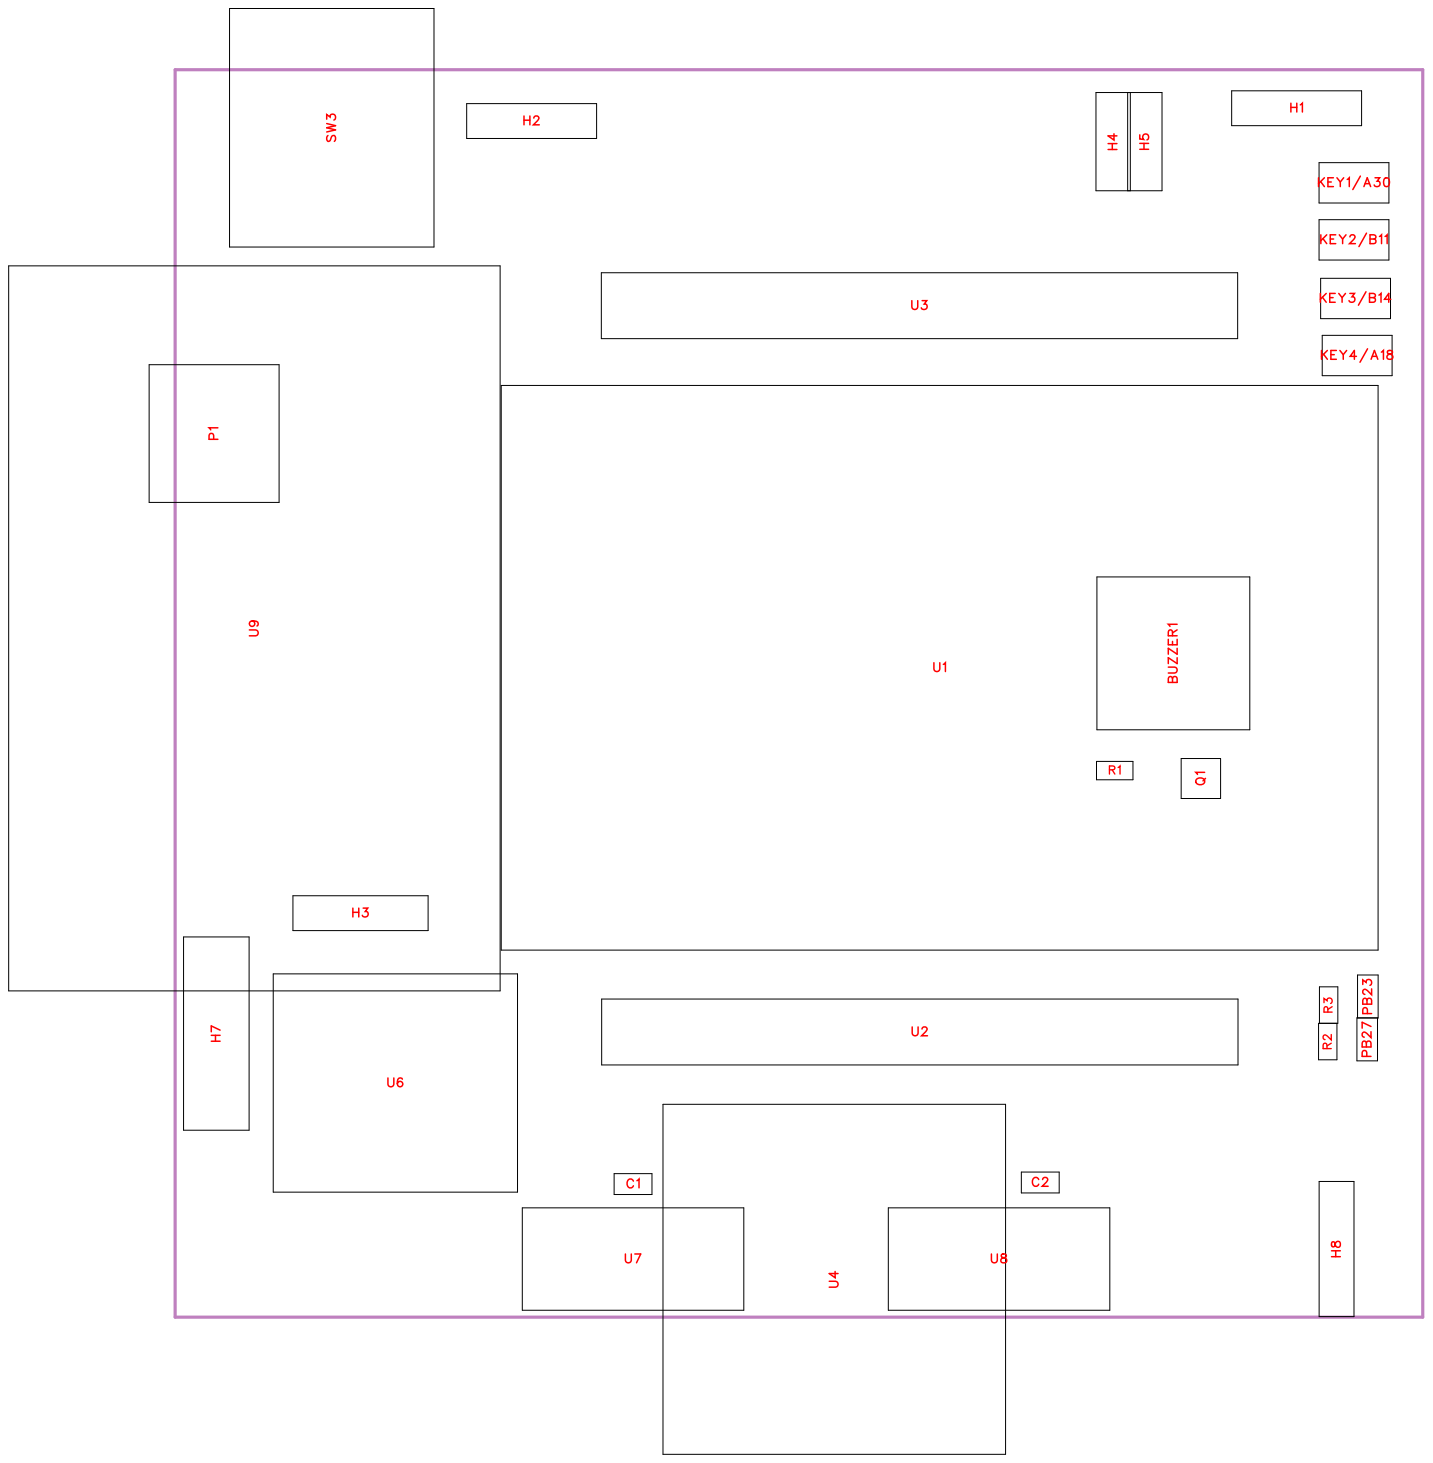
[picture p66: page 1]

H6

No. | Quantity | Comment | Designator | Footprint | Value | Manufacturer Part | Manufacturer | Supplier Part | Supplier
1 | 1 | 2.4kHz | BUZZER1 | BUZ-TH_BD 12.0-P7.60-D 0.6-FD | 2.4kHz | TMB12A05 | 华能 | C96093 | LCSC
2 | 2 | 100nF | C1,C2 | C0603 | 100nF
3 | 2 | PZ254V-11-0 4P | H1,H2 | HDR-TH_4P-P2.54-V-M | | PZ254V-11-0 4P | XFCN(兴飞) | C2691448 | LCSC
4 | 2 | 2.54-1*4P母 | H3,H8 | HDR-TH_4P-P2.54-V-F | | 2.54-1*4P母 | BOOMELE( 博穆精密) | C2718488 | LCSC
5 | 2 | PZ254V-11-0 3P | H4,H5 | HDR-TH_3P-P2.54-V-M_P Z254V-11-03 P | | PZ254V-11-0 3P | XFCN(兴飞) | C2937625 | LCSC
6 | 1 | PZ254R-11-1 0P | H6 | HDR-TH_10 P-P2.54-H-M -W10.4 | | PZ254R-11-1 0P | XFCN(兴飞) | C492418 | LCSC
7 | 1 | PZ254V-12-1 2P | H7 | HDR-TH_12 P-P2.54-V-M -R2-C6-S2.5 4 | | PZ254V-12-1 2P | XFCN(兴飞) | C492423 | LCSC
8 | 4 | TS-1088-AR 02016 | KEY1/A30,KEY2/B11,KEY3/ B14,KEY4/A18 | SW-SMD_L3 .9-W3.0-P4.4 5 | | TS-1088-AR 02016 | XUNPU(讯普 ) | C720477 | LCSC
9 | 1 | WJ500V-5.08 -2P | P1 | CONN-TH_2 P-P5.00_WJ 500V-5.08-2 P | | WJ500V-5.08 -2P | KANGNEX( 康奈克斯电气 ) | C8465 | LCSC
10 | 2 | GL0603UR0 1 | PB23,PB27 | LED0603-FD | | GL0603UR0 1 | Guiguang lig ht(桂光光电) | C51933292 | LCSC
11 | 1 | SI2302 | Q1 | SOT-23-3_L2 .9-W1.3-P1.9 0-LS2.4-BR | | SI2302 | YONGYUTAI (永裕泰) | C2891732 | LCSC
12 | 1 | 10K | R1 | R0603 | 10K
13 | 2 | 510 | R2,R3 | R0603 | 510
14 | 1 | SS-12D11G5 R | SW3 | SW-TH_SS-1 2D11G5R | | SS-12D11G5 R | XKB Connect ion(中国星坤) | C388633 | LCSC
15 | 1 | LCKFB-TMX-MSPM0G350 7 | U1 | COMM-TH_L CKFB-TMX-MSPM0G350 7 | | LCKFB-TMX-MSPM0G350 7 | 立创开发板 | C42378531 | LCSC
16 | 2 | PZ2.54-2*20 | U2,U3 | HDR-TH_40 P-P2.54-V-M -R2-C20-S2. 54 | | PZ2.54-2*20 | ZHOURI(洲 日) | C5224014 | LCSC
17 | 1 | HS96L03W2 C03 | U4 | OLED-TH_L2 7.8-W27.2-P 2.54_C99000 33791 | | HS96L03W2 C03 | HS(汉昇) | C5248080 | LCSC
18 | 1 | tb6612 | U6 | tb6612

19 | 2 | BX-XH2.54-6 PWZ | U7,U8 | CONN-TH_6 P-P2.50_BX-XH2.54-6PW Z | BX-XH2.54-6 PWZ | Bossie(博锡 ) | C18077846 | LCSC
20 | 1 | P03B稳压模 块 | U9 | p03b稳压模 块

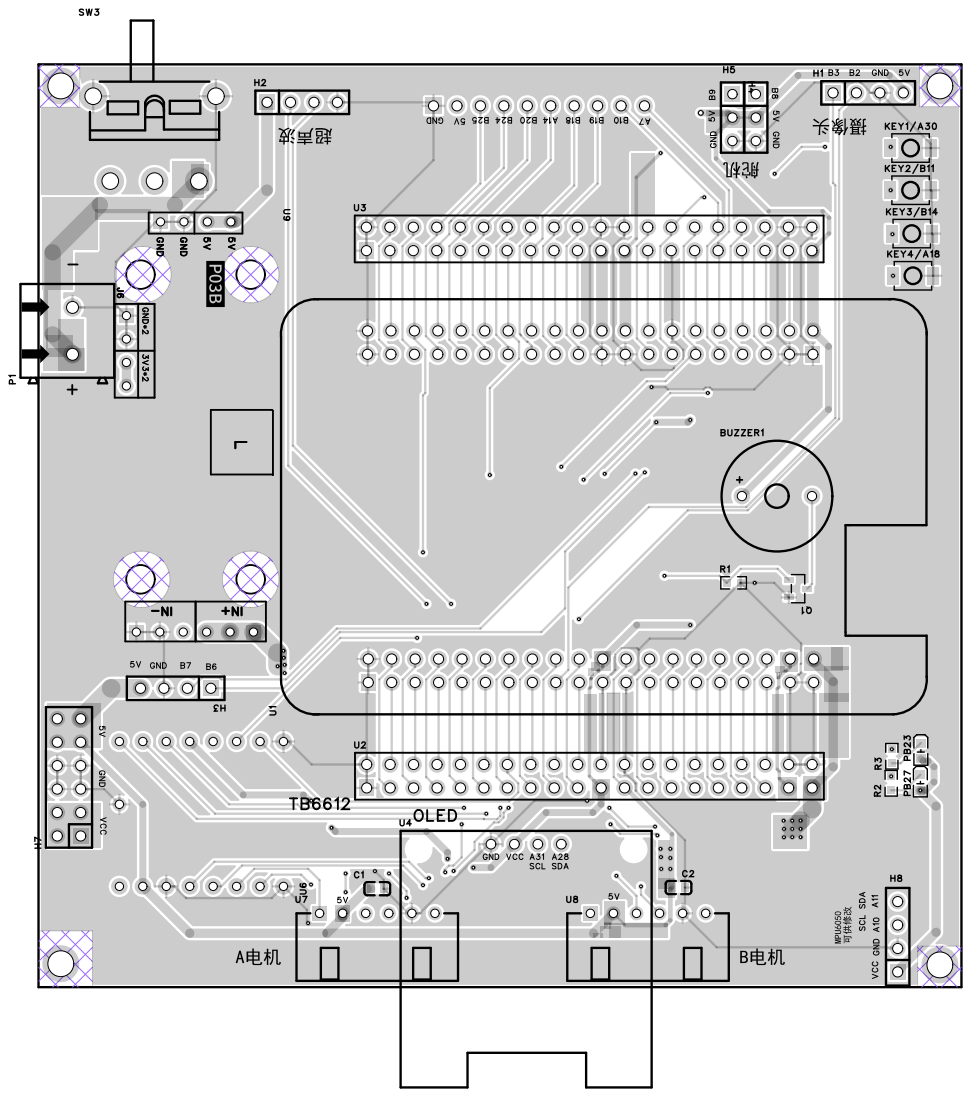
[picture p67: page 5]

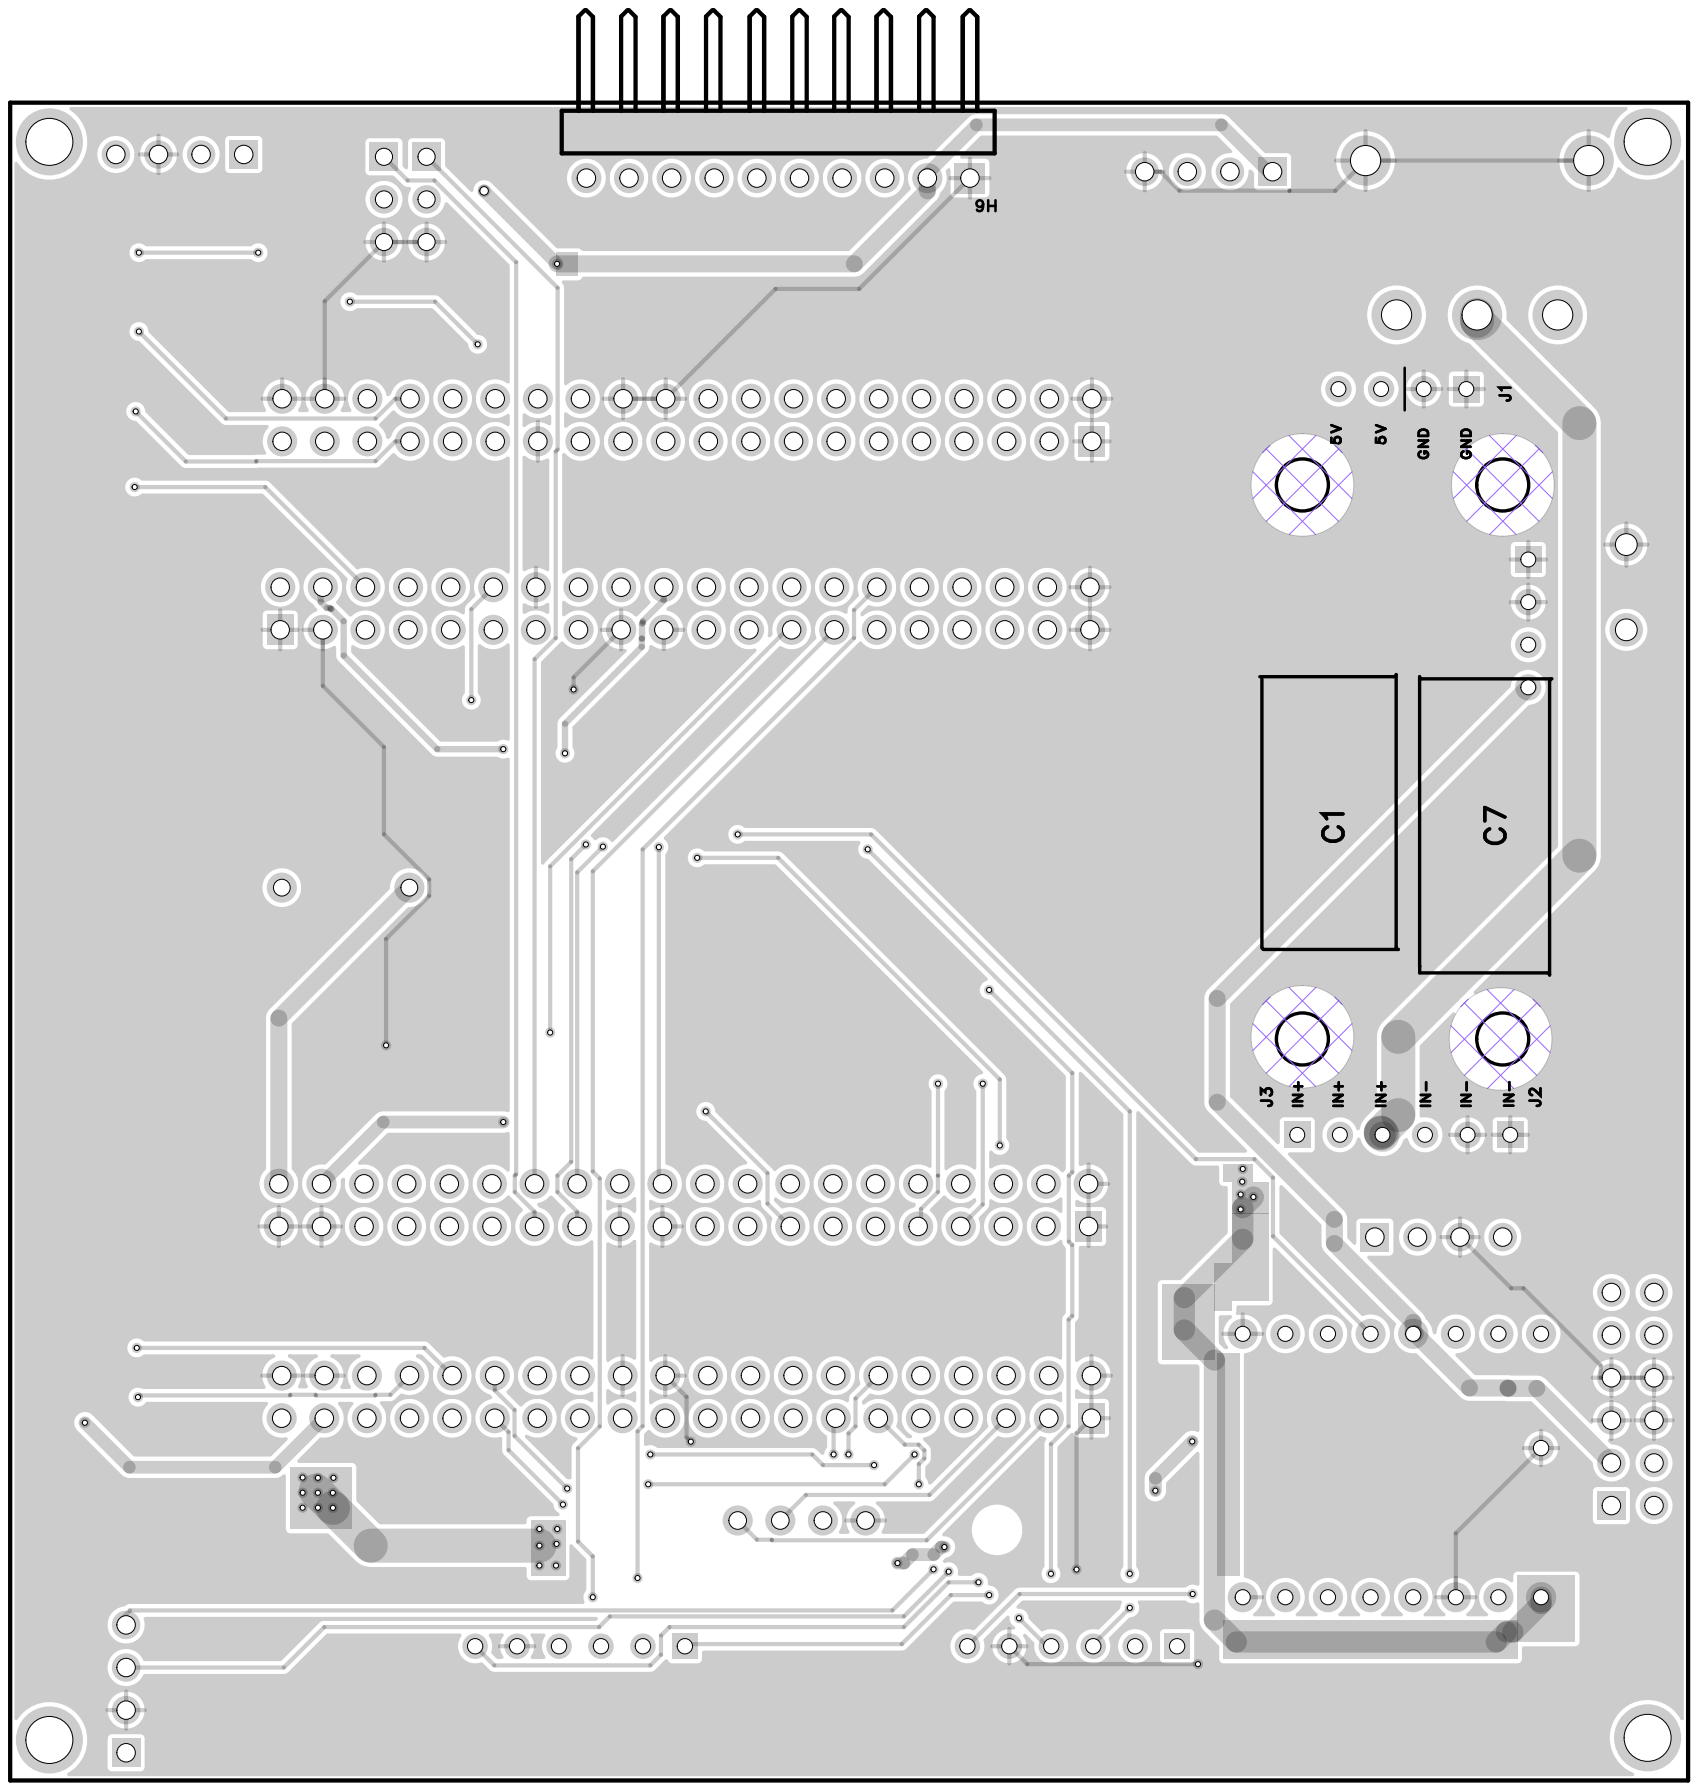
[picture p68: page 6]

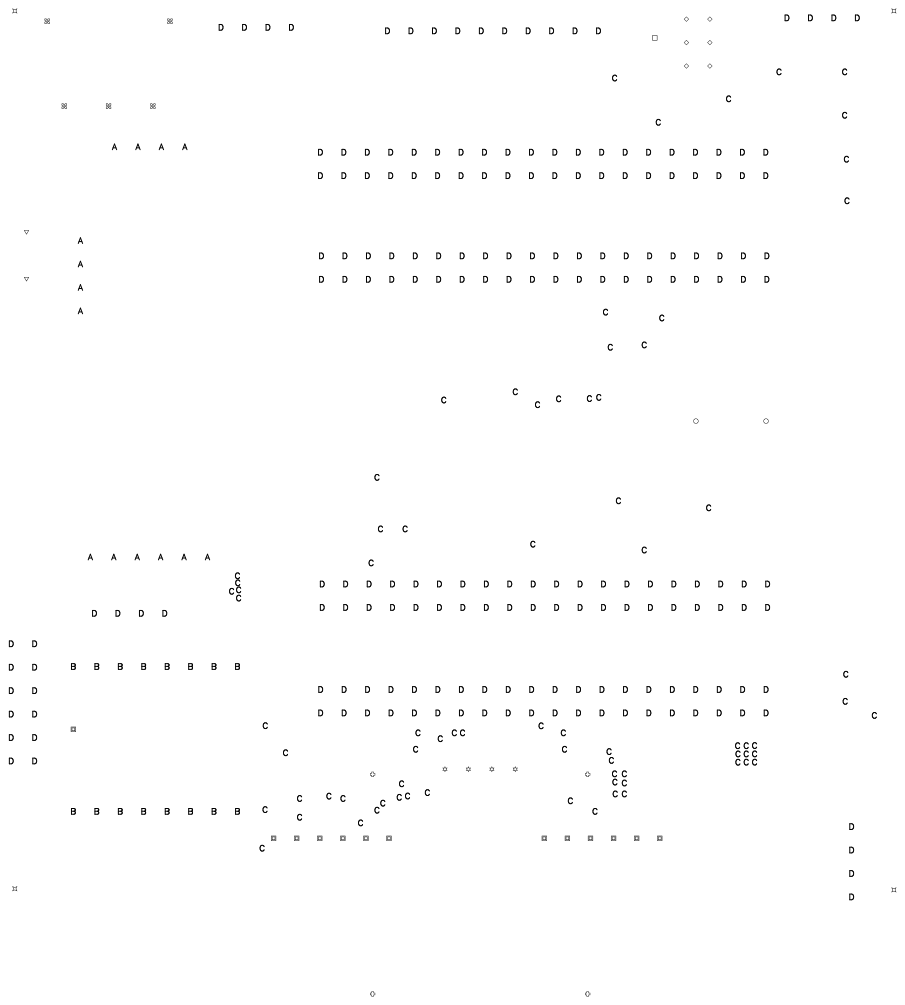
[picture p69: page 7]
