how2idealizefreedom/electric-car-ball-balance/docs/电赛资料/仿真.png

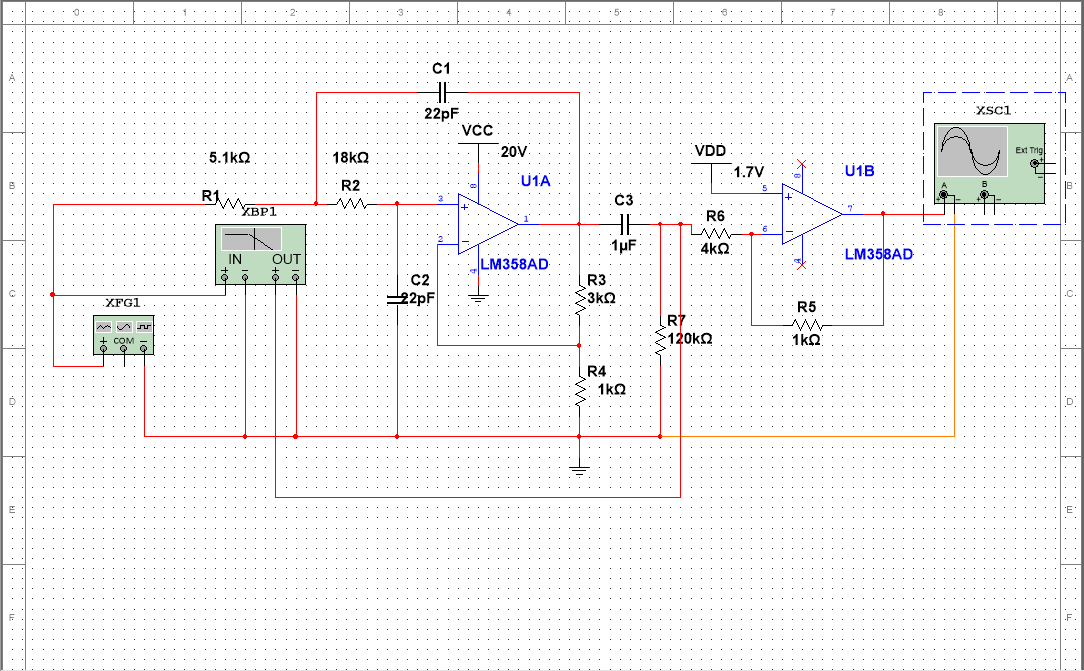
docs/电赛资料/仿真.png
