how2idealizefreedom/electric-car-ball-balance/hardware/WHEELTEC R1系列底盘客户资料/WHEELTEC R1系列底盘客户资料_2026.05.27/2.安装视频教程、三维模型、二维图纸/R1三轮两驱差速小车/R1三轮两驱差速小车【3D模型截图】.png

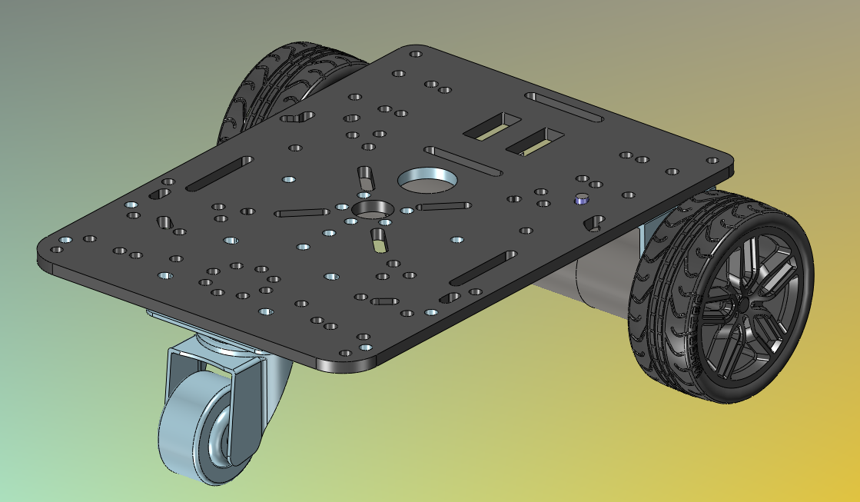
hardware/WHEELTEC R1系列底盘客户资料/WHEELTEC R1系列底盘客户资料_2026.05.27/2.安装视频教程、三维模型、二维图纸/R1三轮两驱差速小车/R1三轮两驱差速小车【3D模型截图】.png
