how2idealizefreedom/electric-car-ball-balance/hardware/天猛星拓展板/PCB图.png

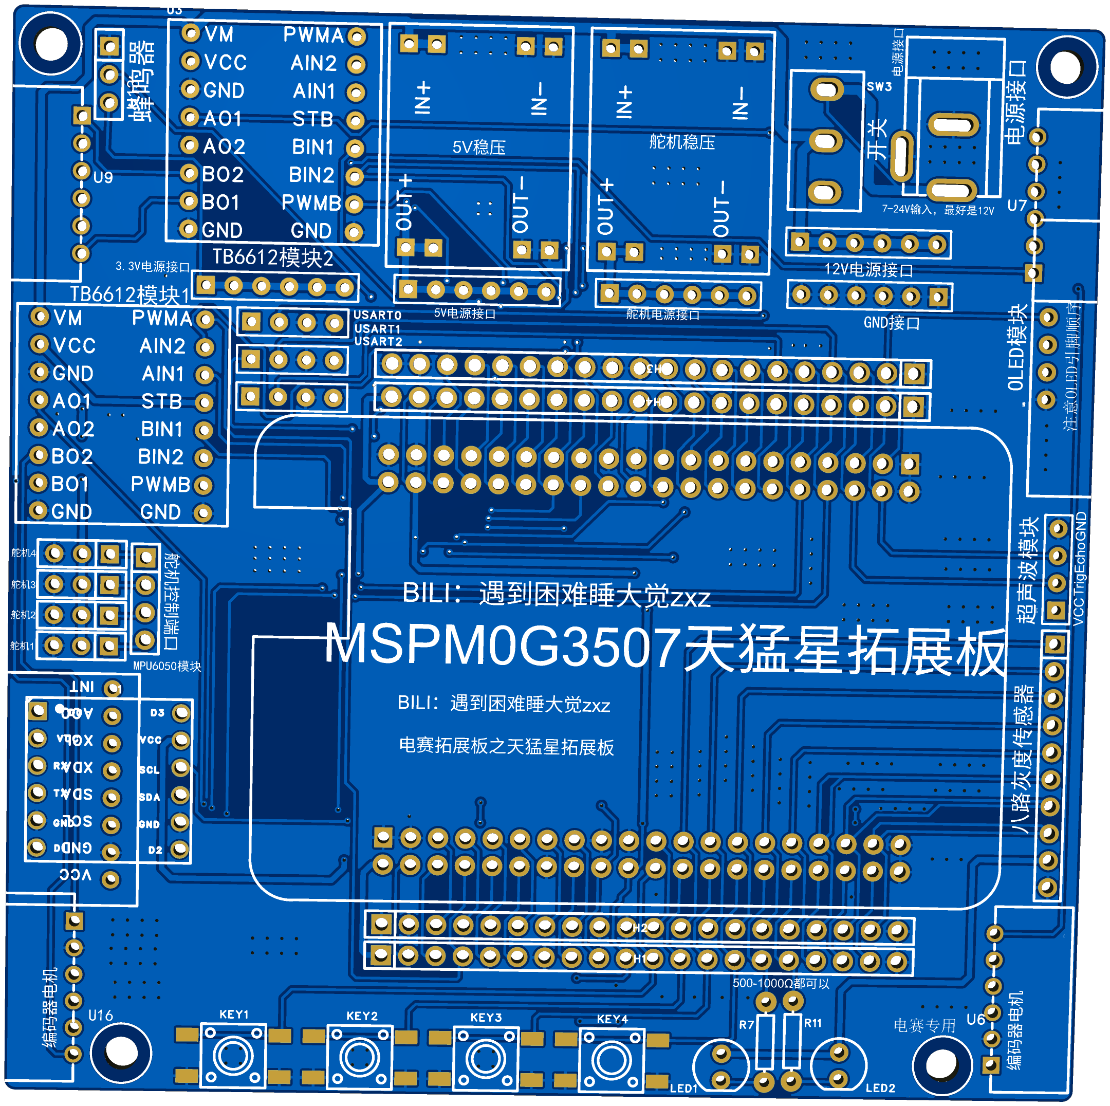
hardware/天猛星拓展板/PCB图.png
