how2idealizefreedom/electric-car-ball-balance/hardware/天猛星拓展板/PCB走线图.png

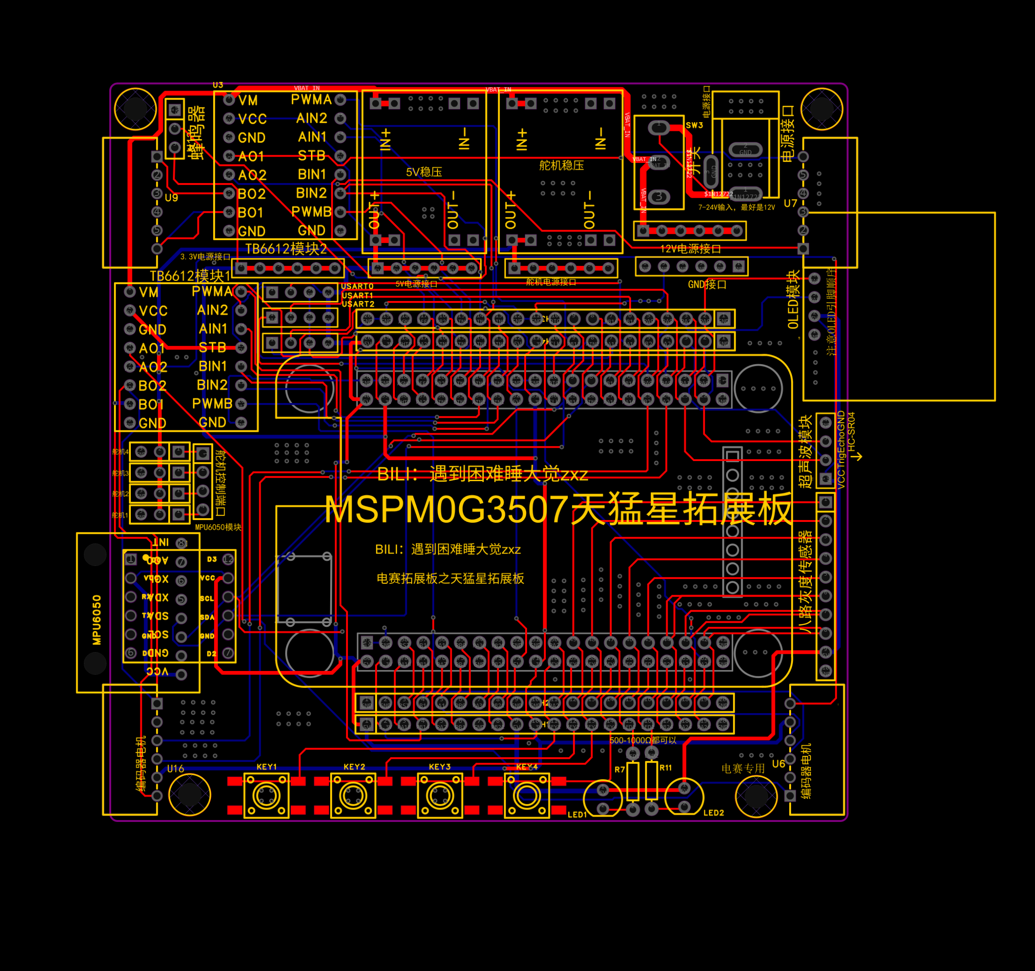
hardware/天猛星拓展板/PCB走线图.png
