how2idealizefreedom/electric-car-ball-balance/hardware/WHEELTEC R1系列底盘客户资料/WHEELTEC R1系列底盘客户资料_2026.05.27/2.安装视频教程、三维模型、二维图纸/R1四轮两驱差速小车/R1四轮两驱差速小车【3D模型】.stp

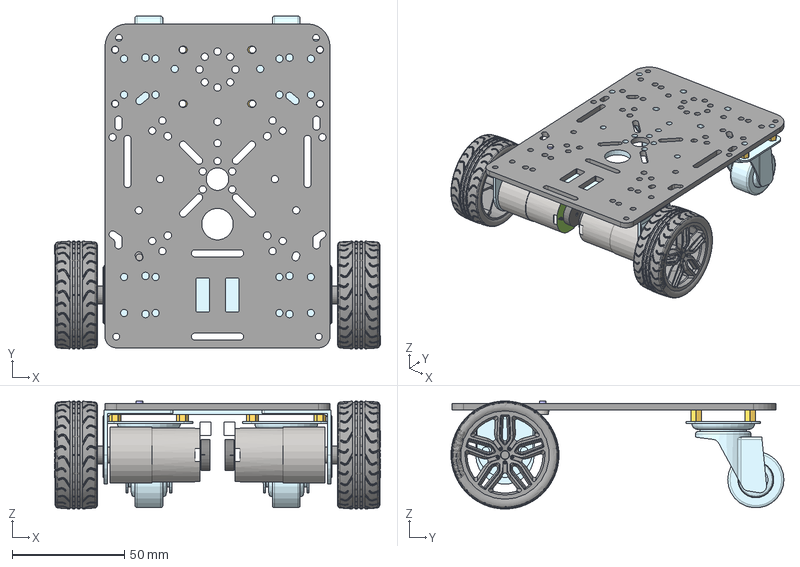
[picture p91: CAD file, 2026-10-09]
hardware/WHEELTEC R1系列底盘客户资料/WHEELTEC R1系列底盘客户资料_2026.05.27/2.安装视频教程、三维模型、二维图纸/R1四轮两驱差速小车/R1四轮两驱差速小车【3D模型】.stp
144.9 x 148.0 x 48.0 mm
四轮两驱方形小车底盘（2026）_1
直流电机_MG310电机(霍尔)_1_1_2_1 x 2
智能车轮_直径48mm_1 x 2
嘐隅釱(1)_3_1 x 2
MG310支架_三轮车_1_1
铜柱M3_5_三轮车_2_1 x 8
蹟隊GB_T822-M3x4-H_4_1
1寸万向轮(30X24)1_4_1_1 x 2
