how2idealizefreedom/electric-car-ball-balance/hardware/WHEELTEC R1系列底盘客户资料/WHEELTEC R1系列底盘客户资料_2026.05.27/2.安装视频教程、三维模型、二维图纸/R1四驱小车/R1四驱小车【3D模型】.stp

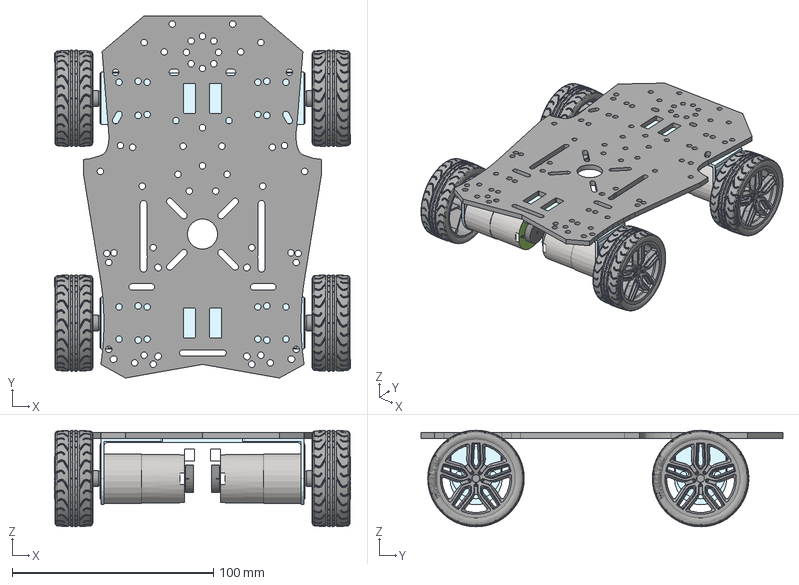
[picture p92: CAD file, 2026-10-09]
hardware/WHEELTEC R1系列底盘客户资料/WHEELTEC R1系列底盘客户资料_2026.05.27/2.安装视频教程、三维模型、二维图纸/R1四驱小车/R1四驱小车【3D模型】.stp
147.3 x 180.0 x 48.0 mm
直流电机_MG310电机(霍尔)_2_2_1_1 x 4
智能车轮_直径48mm_2_1 x 4
嘐隅釱(1)_1_2_1_1 x 5
MG310支架_三轮车_5_1_1 x 2
四驱小车底盘（无刷云台）
