how2idealizefreedom/electric-car-ball-balance/mechanical/26年电赛H题小车水平小球Hmg996舵机结构-含视觉开环算法/水管活页.stp

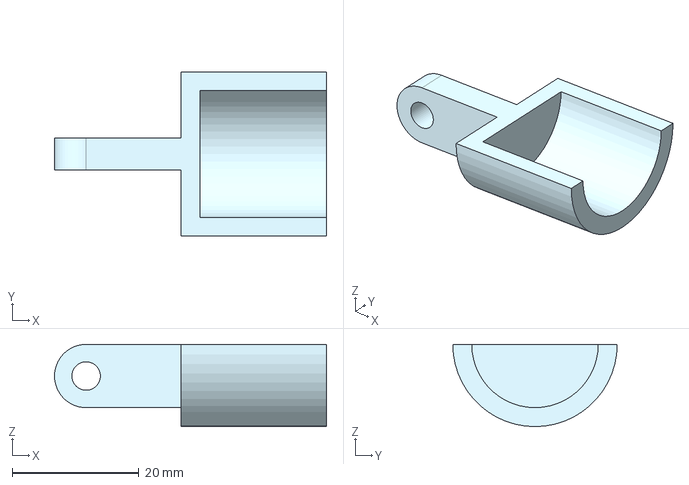
[picture p93: CAD file, 2026-10-09]
mechanical/26年电赛H题小车水平小球Hmg996舵机结构-含视觉开环算法/水管活页.stp
43.0 x 26.0 x 13.0 mm
