how2idealizefreedom/electric-car-ball-balance/hardware/【WHEELTEC】TB6612电机驱动附送资料/【WHEELTEC】TB6612电机驱动附送资料_V3.2_2026.07.25/7.3D模型/TB6612双路驱动稳压模块（D153C).stp

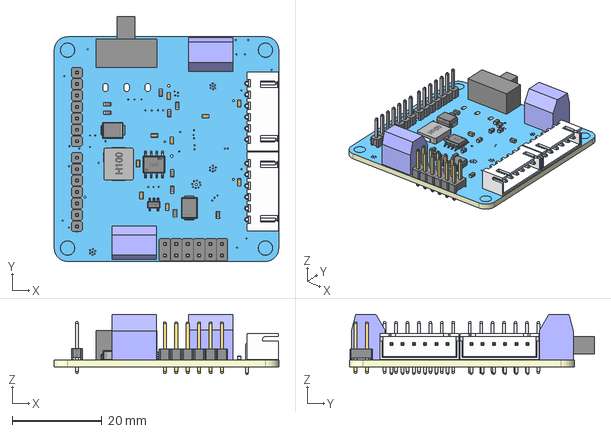
[picture p95: CAD file, 2026-10-09]
hardware/【WHEELTEC】TB6612电机驱动附送资料/【WHEELTEC】TB6612电机驱动附送资料_V3.2_2026.07.25/7.3D模型/TB6612双路驱动稳压模块（D153C).stp
50.0 x 54.5 x 13.4 mm
