how2idealizefreedom/electric-car-ball-balance/mechanical/26年电赛H题小车水平小球Hmg996舵机结构-含视觉开环算法/H42装配铰链.stp

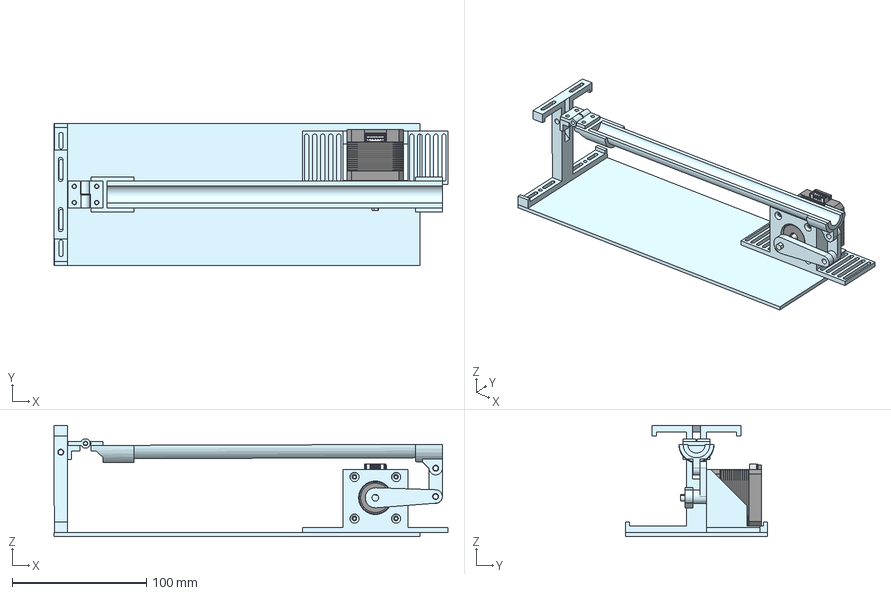
[picture p96: CAD file, 2026-10-09]
mechanical/26年电赛H题小车水平小球Hmg996舵机结构-含视觉开环算法/H42装配铰链.stp
293.7 x 106.0 x 83.0 mm
菁攫
42电机底座
摄像头支架及活页
步进连杆
Bottom
Sheet_metal
Top_body
Axis
625ZZ_001 x 2
Sticker
C-440054-6
PCB
Conn_cover
M3x16-Vis x 4
水管活页
阨奪
水管连杆
蟀裝2
20cm魂珜
