how2idealizefreedom/electric-car-ball-balance/mechanical/26年电赛H题小车水平小球Hmg996舵机结构-含视觉开环算法/H舵机装配.stp

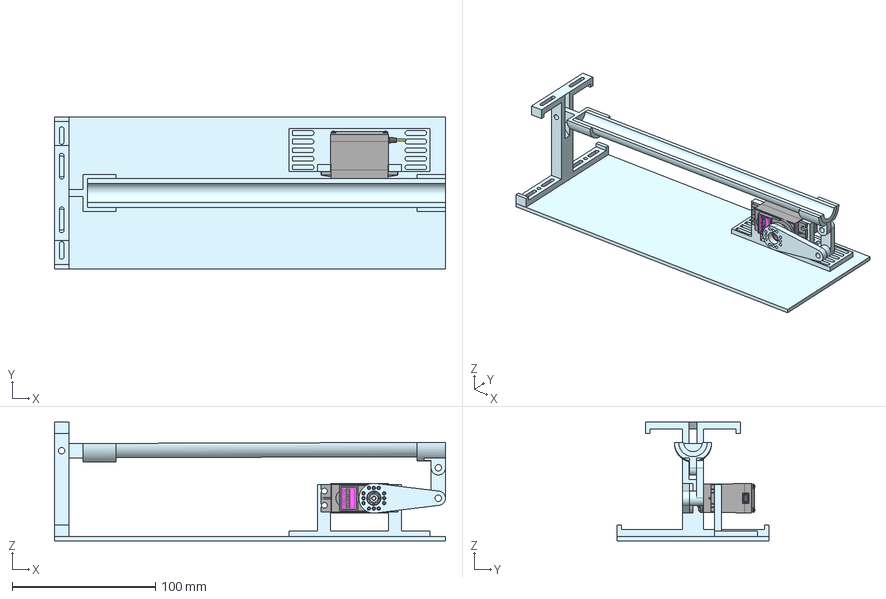
[picture p97: CAD file, 2026-10-09]
mechanical/26年电赛H题小车水平小球Hmg996舵机结构-含视觉开环算法/H舵机装配.stp
273.0 x 106.0 x 83.0 mm
摄像头支架及活页
水管活页
阨奪
水管连杆
蟀裝2
菁攫
舵机连杆1.1
mg996R_v2
mg996_arm_round
舵机支架
