how2idealizefreedom/electric-car-ball-balance/(list of files, cad)

Other CAD files:
hardware/WHEELTEC R1系列底盘客户资料/WHEELTEC R1系列底盘客户资料_2026.05.27/1.孔位说明与孔位图纸/R1四驱小车板件孔位【孔位图】.dwg
hardware/WHEELTEC R1系列底盘客户资料/WHEELTEC R1系列底盘客户资料_2026.05.27/2.安装视频教程、三维模型、二维图纸/R1三轮两驱差速小车/R1三轮两驱差速小车.dwg
hardware/【WHEELTEC】TB6612电机驱动附送资料/【WHEELTEC】TB6612电机驱动附送资料_V3.2_2026.07.25/7.3D模型/TB6612四路驱动稳压模块（D24A).stp
hardware/WHEELTEC R1系列底盘客户资料/WHEELTEC R1系列底盘客户资料_2026.05.27/1.孔位说明与孔位图纸/R1差速小车板件孔位【孔位图】.dwg
hardware/WHEELTEC R1系列底盘客户资料/WHEELTEC R1系列底盘客户资料_2026.05.27/2.安装视频教程、三维模型、二维图纸/R1四轮两驱差速小车/R1四轮两驱差速小车.dwg
hardware/WHEELTEC R1系列底盘客户资料/WHEELTEC R1系列底盘客户资料_2026.05.27/2.安装视频教程、三维模型、二维图纸/R1四驱小车/R1四驱差速小车.dwg
mechanical/26年电赛H题小车水平小球Hmg996舵机结构-含视觉开环算法/H舵机装配.3mf
