how2idealizefreedom/electric-car-ball-balance/docs/dev-notes/HARDWARE_INTEGRATION_AND_NEXT_STEPS.md

# 硬件集成与接线设计

> 记录 H 题小车硬件集成阶段的接线结论、引脚分配与供电拓扑。
> 文中"已确认"指有实物或实测依据；"设计"指已定方案未实测；两者不混写。

## 一、已确认的硬件

| 项 | 结论 |
| --- | --- |
| 主控（备选） | 地猛星 MSPM0G3507 LQFP-48；天猛星 MSPM0G3507 LQFP-64。最终路线切到天猛星 |
| 车体 | 29 cm × 24 cm |
| 行走电机 | 四个 MG310、霍尔编码器 13 PPR、减速比 1:20 |
| 驱动 | WHEELTEC D24A（板载两颗 TB6612FNG）驱动四轮 |
| 循迹进度 | 地猛星 + D24A 已能直线循迹；第一内弯丢线后停车 |
| 灰度 | 8 路数字输出，3.3 V 供电，白底输出低、黑线输出高 |
| 视觉 | 立创·庐山派 K230-CanMV 标准版，GC2093 CSI2 摄像头，RTL8189FTV 2.4 GHz Wi-Fi；K230 逻辑 5 V，对 MSPM0 拟用 3.3 V TTL UART |
| 显示 | 0.96 英寸、4 线 I2C；板上地址焊盘标 0x78/0x7A，对应常见 7 位地址 0x3C/0x3D；控制器型号待确认 |
| 按键 | 四键板 KEY1~KEY4，按下接 GND，无 VCC 引脚，低有效，板载每键 0.1 µF |
| 舵机（早期方案） | MG996R，4.8~6.6 V，50 Hz 控制，约 0.5~2.5 ms 脉宽；必须独立大电流降压供电 |

## 二、地猛星引脚预留

在不动现有循迹引脚的前提下，后续经 SysConfig 正式加入：

| 功能 | MSPM0 引脚 | 模块端 |
| --- | --- | --- |
| OLED I2C | PB2 = SCL，PB3 = SDA | SCL，SDA |
| K230 UART | PB7 = MSPM0 RX，PB6 = MSPM0 TX | K230 GPIO11 TX，GPIO12 RX |
| 四键 | PA24、PA25、PA26、PB8 | KEY1~KEY4 |
| 舵机信号 | PA27 | MG996R 信号线 |
| 共地 | GND | 所有逻辑与各降压模块 GND |

OLED 与 MPU6050 可共享 PB2/PB3 这一组 I2C 总线，地址分别约 0x3C/0x3D 与 0x68/0x69。正式接入前仍需 SysConfig 验证。

## 三、天猛星拓展板结论

仅以 `hardware/` 中的 `SCH_Schematic1_2026-06-13.pdf` 为依据：

- OLED 已布线：PA31 = SCL、PA28 = SDA。
- MPU6050 已布线：PA1 = SCL、PA0 = SDA、PB4 = INT。
- K230 推荐使用拓展板 UART1：PB7 = MSPM0 RX、PB6 = MSPM0 TX。
- 舵机信号优先 PA22；红线不使用拓展板 5 V，改接独立 5.5~6.0 V 舵机电源；棕线与系统共地。
- 外接四键建议 PA24、PA25、PA26、PA27，均配置内部上拉、按下为低。

**风险记录**：该拓展板原理图把 TB6612 VCC 与 STBY 固定到 +5 V，PWM/方向信号直接来自 3.3 V 的 MSPM0，未画出电平转换电路。3.3 V 对 5 V 逻辑域不应视为数据手册保证。比赛版优先继续使用已验证的外接 D24A；若必须使用拓展板板载 TB6612，需先确认实板是否另有缓冲器，或改为 3.3 V 逻辑供电 / 增加 HCT 缓冲后再验收。

## 四、供电拓扑

同一块 12 V 电池分出四个并联支路，所有地在电源分配点共地：

1. 12 V 直接到 D24A VIN；
2. 独立 5 V 稳压到 MSPM0 电源入口；
3. 独立 5 V、至少 2 A 稳压到 K230；
4. 独立 5.5~6.0 V、建议 3 A 以上峰值能力到 MG996R。

灰度模块由 MSPM0 3.3 V 供电；OLED 优先由 3.3 V 供电，若按拓展板接 5 V，必须先测空闲 SCL/SDA 是否被上拉到 5 V。

**禁止项**：禁止并联两个降压模块的输出；禁止把 12 V 接入任何 MCU、传感器或信号脚。

## 五、第 3~6 问控制路线

- K230 以 30~50 Hz 输出小球相对摆杆中心的位置、速度、置信度和序号。
- MSPM0 主循环解析完整 UART 行；中断只收字节，不做 PID。
- 外环位置 PID/PD 输出目标摆杆倾角；加入速度阻尼、死区、限幅和命令斜率限制。
- 第 3 问用状态机完成 `0 → +5 cm → -5 cm → 稳定`，稳定条件同时检查位置误差与球速。
- 第 4/5 问使用更平滑的车辆加减速曲线，球控优先；K230 闭环抵消车辆加速与转弯扰动，MPU6050 作为可选前馈与异常检测。
- 第 6 问用 OLED + 四键选择目标：推荐 0.5 cm 步进、限制在实测安全范围；K1 启动/停止，K2 切换题号，K3 减小目标，K4 增大/确认。屏幕显示模式、目标、球位置、计时和故障。

## 六、待确认项

1. K230 视觉程序的完整源码与 5~10 秒 UART 样例（用于冻结数据帧协议）。
2. 摆杆有效长度、槽内可用长度、球直径/质量、中心到 ±5 cm 的实物标尺照片。
3. 舵机安装侧视图、舵盘孔半径、连杆两端孔距、摆杆驱动点到铰链距离。
4. 舵机独立降压模块型号、额定/峰值电流与实测空载输出电压。
5. OLED 正面丝印或商品页，确认 SSD1306 / SH1106；分别在 3.3 V 与计划供电下测 VCC、SCL、SDA 空闲电压。
6. 地猛星第一内弯前后的完整串口记录、俯视视频、测试前电池电压，以及灰度板离地高度、灰度板到前轮轴的距离。
7. 天猛星拓展板正反面高清照片，并用通断档确认 TB6612 STBY 是否确实直连 +5 V。
