how2idealizefreedom/electric-car-ball-balance/firmware/H2_LINE_CAR_CURVE_TEST/POWER_AND_D24A_WIRING.md

# 地猛星 + D24A：供电与逻辑接口定案

## 1. 原理图结论

D24A 的 `Vin+/-` 接受 5.5～15 V，板上 RT8289 产生 5 V，再由 RT9013-33 产生 3.3 V。顶部 J1/J3 的 5 V、3.3 V、GND 均为**对外输出**。

D24A 的两颗 TB6612FNG：

- 电机电源 `VM1/VM2/VM3` 接电池 `VIN`；
- 逻辑电源 `VCC` 固定接板载 `5V`；
- `STBY`、四路 `IN1/IN2/PWM` 直接接 J4/J6 排针；
- 板上没有 3.3 V 到 5 V 电平转换；
- `STBY` 和方向/PWM 输入也没有可靠的默认下拉。

所以宣传图中的“无需逻辑供电”表示 D24A 不需要 MCU 再给 TB6612 提供 VCC，不表示控制输入保证兼容 3.3 V。J4-1 的 `3V3` 是输出，不是逻辑电源输入。

## 2. 是否需要 HCT

需要，比赛和落地循迹采用一片 8 路 `74HCT245`、`74AHCT245` 或 `74AHCT541`。

原因：TB6612 在 VCC=5 V 时，数据手册保证的输入高阈值是 `0.7 x VCC = 3.5 V`。MSPM0 的 GPIO 高电平约 3.3 V，低于 3.5 V。直接连接通常不会造成输入过压，但逻辑高不受保证，可能随温度、电池、电机噪声和器件批次出现不动作或抖动。

器件选择：

- 推荐 `74HCT245`/`74AHCT245`：5 V 供电时可可靠识别 3.3 V 输入；
- `74AHCT541` 也适合，且为单向缓冲；
- 不要误买 `74HC245`，HC 在 5 V 下同样不保证识别 3.3 V；
- 不使用 BSS138 双向 I2C 小板；
- 不使用 TXS0108E 驱动这组电机控制扇出；
- DC-DC 降压模块不是逻辑电平转换器。

当前左右分组只需要 7 路信号，因此一片 8 路器件足够。每个 HCT 输出并接同一侧两颗 TB6612 的对应输入，负载很轻。

### 74HCT245 基本接法

- `VCC -> D24A 5V`；
- `GND -> D24A GND/系统公共地`；
- `DIR` 固定到 MCU A 侧传向 D24A B 侧的电平；常见 74HCT245 为 DIR=高时 A 到 B，但必须以所购模块丝印/手册为准；
- `/OE -> GND`，输出常使能；
- 芯片 VCC/GND 附近放置 0.1 uF 去耦电容；
- A1～A7 每路建议用 10 kΩ 下拉到 GND，保证 MCU 复位时 HCT 输入不悬空；
- D24A `STBY` 节点额外接一个 10 kΩ 到 GND，确保转换器掉电或高阻时两颗 TB6612保持禁能。

不要把 HCT VCC 接电池 12 V。

## 3. 系统电源逻辑

### 模式 A：电脑调试

```text
电脑 USB/Type-C
    -> 地猛星 VBUS/+5V
    -> 地猛星板载 3.3V LDO
    -> MSPM0 + 灰度传感器

12.14V 电池
    -> D24A Vin+ / GND
    -> TB6612 电机电源 VIN
    -> D24A 5V -> HCT VCC
    -> 四个电机

地猛星 GND -------- D24A GND -------- 灰度 GND -------- HCT GND
```

本模式必须做到：

- D24A 的 5 V、3.3 V **都不接**地猛星的 5 V/3.3 V 排针；
- 只连接公共 GND 和控制信号；
- 灰度 VCC 由地猛星 3.3 V 提供；
- HCT VCC 由 D24A 5 V 提供；
- 电机电流从 D24A 直接回到电池负极，不经过面包板或 MCU 地线。

### 模式 B：车辆脱离电脑运行

地猛星原理图显示 Type-C `VBUS` 与板上 `+5V` 是直接同一网络，没有防倒灌二极管。因此脱机时可以使用 D24A 的 5 V 给地猛星 5 V 排针供电，但必须拔掉电脑 Type-C：

```text
12.14V 电池
    -> D24A Vin+ / GND
    -> D24A 5V
         +-> 地猛星 H3-18 或 H5-18 (+5V)
         +-> HCT VCC

地猛星板载 3.3V LDO
    +-> MSPM0
    +-> 灰度 VCC

D24A GND
    +-> 地猛星 H3-20 或 H5-20
    +-> HCT GND
    +-> 灰度 GND
```

禁止事项：

- 禁止电脑 USB 与 D24A 5 V 同时接入地猛星；否则两个 5 V 电源直接并联，并可能向电脑 USB VBUS 倒灌；
- 禁止 D24A 3.3 V 接地猛星 3V3，它会反向驱动地猛星板载 LDO 输出；
- 禁止 12 V 直接接地猛星、灰度或 HCT；
- 禁止把 XDS110 的电源输出和 D24A/USB 电源并接。

如果脱机供电时仍连接 XDS110，只连接目标 3.3 V 参考、GND、SWDIO、SWCLK、可选 NRST，不使用 XDS110 给目标供电。

## 4. 逐线电源连接

### 电脑调试时

| 来源 | 目标 | 说明 |
|---|---|---|
| 电脑 Type-C | 地猛星 Type-C | MCU、CH340、灰度供电 |
| 地猛星 3V3 | 灰度 VCC | 灰度固定按 3.3 V 使用 |
| 地猛星 GND | 灰度 GND | 逻辑地 |
| 电池正极 | D24A `Vin+` | 实测 12.14 V |
| 电池负极 | D24A `-`/GND | 电机主回流 |
| D24A 5V | HCT VCC | 不是 12 V |
| D24A GND | HCT GND | HCT 电源地 |
| D24A GND | 地猛星 GND | 只需一根可靠逻辑共地线 |

### 脱机运行时

先拔掉地猛星 Type-C，再增加：

| 来源 | 目标 |
|---|---|
| D24A 5V | 地猛星 H3-18 或 H5-18 `+5V` |
| D24A GND | 地猛星 H3-20 或 H5-20 `GND` |

灰度仍从地猛星 3V3 取电，HCT仍从D24A 5V取电。

## 5. 电机与编码器

- 电机 A=右后、B=右前、C=左前、D=左后，四个电机动力由各自白色 6P 插座中的两根电机线连接；
- D24A 的电机插座同时固定输出 5 V 给 MG310 霍尔编码器；
- 当前循迹第一版暂不把 E1A/E1B～E4A/E4B 接入 MSPM0；
- 后续接编码器时，若继续用 D24A 5 V 给编码器供电，编码器 A/B 输出必须先确认是否为 5 V 推挽，并按需要降到 3.3 V；不能直接假设安全。

## 6. 上电顺序

### 调试模式

1. D24A 开关 OFF，电池断开；
2. 接好共地、灰度和 HCT信号；
3. 地猛星 Type-C 接电脑，固件启动且 STBY 应为低；
4. 四轮架空；
5. 接电池并打开 D24A；
6. 测量 HCT VCC 约 5 V、D24A STBY 仍约 0 V；
7. 按 PA24 启动按钮进行低速测试；
8. 异常时先按急停，再关闭 D24A。

### 脱机模式

1. 地猛星 Type-C 和 XDS110 电源输出全部断开；
2. D24A 5 V/GND 接地猛星 +5V/GND；
3. 四轮架空，打开 D24A；
4. 确认地猛星电源灯正常、PA14 进入待机闪烁、STBY 约 0 V；
5. 再进行按键启动。
