how2idealizefreedom/electric-car-ball-balance/firmware/H2_地猛星_弯道测试/CURVE_TEST_GUIDE.md

# 地猛星内弯恢复实验版

本工程从 2026-07-29 22:44 左右验证稳定的 `H2_LINE_CAR` 基线复制而来。原工程未修改。

## 只改变了什么

- 正常识线时的直线速度、PD 参数、方向极性和停车逻辑保持不变。
- 丢线后的搜索改为两段：
  - 0~180 ms：内侧 3%、外侧 18%，继续沿最后误差方向找线。
  - 180~1100 ms：内侧停转、外侧 26%，提高 24 cm 宽底盘的转弯能力。
- 连续丢线达到 1100 ms 后仍进入 `STATE,FAULT,LINE_LOST`，不会在全白场地无限转圈。
- 全白 `M=0` 时拒绝启动，输出 `EVENT,START_REJECT,NO_LINE`。
- 串口增加：
  - `EVENT,LINE_LOST_BEGIN,T=...,E=...`
  - `EVENT,LINE_REACQUIRED,T=...,D=...,M=...`
  - 周期遥测增加 `X=`，表示当前连续丢线时间（ms）。

## 构建状态

- SysConfig 1.26.2 + MSPM0 SDK 2.11.00.07：通过。
- TI Arm Clang 4.0.4.LTS clean all：通过。
- 输出：`Debug/H2_LINE_CAR_CURVE_TEST.out`
- SysConfig 仍有原有信息提示：控制定时器在 STOP/STANDBY 不保持寄存器。本程序不进入这些低功耗状态。
- 未烧录，未声称实车通过。

## 第一次测试

1. 暂不连接舵机、K230、OLED；电池先充足，车轮落地测试时手靠近总电源开关。
2. 先把灰度阵列放在全白处按键：必须拒绝启动，四轮不转。
3. 把 S4/S5 对准黑线，确认串口 `M=24` 左右后再从 A 点启动。
4. 第一个内弯只测一次。若重新捕获，串口会出现 `LINE_REACQUIRED`；立即保存整段日志。
5. 若方向明显相反或向外冲，立即断电，不要连续重试。

## 必须回传

- 第一个弯前 1 秒到停车/重新捕获后 1 秒的全部串口文本。
- 从车体正上方或后上方拍摄的 5~10 秒视频，需要同时看到赛道、灰度板和四个轮子。
- 本次测试前静置电池电压。

没有上述数据，不再同时改速度、PD 和搜索方向。
