how2idealizefreedom/electric-car-ball-balance/firmware/H2_天猛星_路线记忆与步进/BUILD_STATUS.md

# 构建状态

- 目标：立创·天猛星 MSPM0G3507，LQFP-64(PM)。
- MSPM0 SDK：2.11.00.07。
- SysConfig：1.26.2+4477。
- 编译器：TI Arm Clang 4.0.4.LTS。
- `check_syscfg.py`：通过。
- `run_sysconfig.py`：通过，无引脚或外设冲突。
- 源码：`main.c`、`track_memory.c`、`mpu6050.c`、SysConfig 生成文件和 MSPM0G350x startup 均编译通过。
- 链接：通过；Flash 使用 0x2908（约 10.3 KiB），SRAM 使用 0x15DA（约 5.5 KiB）。
- 验证输出：`verified_build/H2_TIANMENG_MEMORY_STEPPER.out`。

SysConfig 唯一提示：TIMA0 在 STOP/STANDBY 下不保持寄存器。本固件只使用 `__WFI()`，不进入 STOP/STANDBY，因此不影响当前运行。

CCS 工程的旧 `Debug` 目录来自底座工程，里面带旧工程名的 `.out`，不得烧录。首次导入后执行 `Clean Project` 和 `Build Project`，让 CCS 重新生成 `Debug/H2_TIANMENG_MEMORY_STEPPER.out`。

当前只完成静态检查、SysConfig 生成、编译和链接，尚未烧录或完成天猛星实车验证。
