how2idealizefreedom/electric-car-ball-balance/firmware/H1-H5_天猛星_七路循迹/SEVEN_LINE_WIRING_AND_TEST.md

# 七路红外循迹接线与首次测试

本工程是 `H1_H5_TIANMENG` 的独立七路循迹分支。除循迹传感器输入、空间权值和损坏 S6 的补偿外，电机、按键、OLED、OpenMV、A4988以及 Q1～Q5 状态机均沿用原工程。

## 1. 有效通道

面向小车前进方向观察，传感器从左到右仍编号为 S1～S8，中心位于 S4 与 S5 之间，间距为 15 mm。S6 已损坏，不接入本工程。

| 物理位置 | 模块来源 | MCU | 掩码 | 初始黑线电平 |
|---|---|---|---:|---|
| S1 | 红色四路模块 | PB5 | 0x01 | 高 |
| S2 | 红色四路模块 | PB16 | 0x02 | 高 |
| S3 | 蓝色单路模块 | PB12 | 0x04 | 高 |
| S4 | 蓝色单路模块 | PB13 | 0x08 | 高 |
| S5 | 蓝色单路模块 | PB23 | 0x10 | 高 |
| S6 | 蓝色单路模块，损坏 | 不使用，原 PB26 释放 | 0x20 | 屏蔽 |
| S7 | 红色四路模块 | PB27 | 0x40 | 高 |
| S8 | 红色四路模块 | PB25 | 0x80 | 高 |

只接数字输出 DO/OUT；AO 不接。全部模块推荐由 3.3 V 供电并与 MSPM0 共地，以避免 5 V 比较器上拉直接进入 MSPM0 GPIO。

## 2. 首次静态检查

先关闭 D24A 电机电源，只保留主控和传感器供电。串口 115200 观察 `RAW` 与 `M`：

- 全白背景：预期 `M=0`。
- 逐个只压住黑线：依次预期 `M=1,2,4,8,16,64,128`。
- 物理 S6 位置没有读数是正常现象。
- 中央 S4/S5 同时压线：预期 `M=24`。

`RAW` 是 GPIO 原始高电平位，`M` 是按照逐路极性归一化后的黑线位。若某一路在白底为 1、黑线为 0，只清除 `car_config.h` 中 `LINE_BLACK_HIGH_MASK` 对应位，不得整体翻转全部传感器。

## 3. 动态策略

权值按 15 mm 间距设置为 `-525,-375,-225,-75,+75,+225,+375,+525`。为保持原 P1 控制强度，PD 分母以及中弯/大弯阈值都同比放大 1.5 倍；PWM、限幅、丢线 400 ms、A 点停车和其他状态机参数保持不变。

S6 缺失会形成 S5 至 S7 之间 30 mm 盲区。软件仅在上一次误差位于右半侧时保持 75 ms 的 S6 虚拟误差；超过 75 ms 仍按原丢线搜索，累计 400 ms 后故障停车。

## 4. 首次行驶

静态七项全部正确后再接通 D24A，先架空确认四轮方向，再在低速条件下测试 Q2。必须保存从直线进入第一个内弯直至重新进入直线的 `M/RAW/E/L/R` 串口记录。构建通过不代表七路实车循迹已经通过。
