how2idealizefreedom/electric-car-ball-balance/firmware/H2_地猛星_循迹主线/P1_WIRING_AND_TEST.md

# H2_LINE_CAR：今晚循迹接线与测试

当前固件已经包含：PA24 按键启动/急停、八路数字灰度加权 PD、丢线保护、起点横线屏蔽、回到 A 点短刹停车、PA10/PA11 CH340 遥测。第一版为开环轮速，参数刻意偏低，先完成架空和低速循迹验证。

## 1. 上电安全顺序

1. D24A 开关保持 `OFF`，12 V 电池先断开，四轮架空。
2. 先完成信号线并逐根复查，再连接电池。
3. MCU 用开发板 Type-C/USB 供电；D24A 用 12 V 电池供电。
4. `MSPM0 GND`、灰度 `GND`、逻辑转换器 `GND`、D24A `GND` 必须共地。
5. D24A 的 `5V` 和 `3V3` 都不要连接到 USB 供电中的 MSPM0 电源针脚。
6. 任何接线修改前都先关闭 D24A 并断开 12 V。

## 2. 一个启动/急停按钮

只装一个常开轻触按钮即可完成第二问的控制：

| 地猛星 | 位置 | 按钮 |
|---|---|---|
| PA24 | H5-5 | 任意一脚 |
| GND | H5-1 或 H5-20 | 对侧脚 |

PA24 已启用内部上拉，按下为低电平。待机时按一次启动；运行时再按一次立即禁能电机。没有按钮时，可用杜邦线让 PA24 与 GND 短接约 0.1 s 后立即松开进行临时测试，不能一直短接。

## 3. 八路灰度

灰度板固定使用 MSPM0 的 `3.3V` 供电。传感器从车头朝前观察时，定义最左侧为 S1、最右侧为 S8：

| 灰度输出 | 地猛星 GPIO | 排针位置 | 串口位值 |
|---|---|---|---:|
| S1（最左） | PA0 | H3-1 | 1 |
| S2 | PA1 | H3-2 | 2 |
| S3 | PA28 | H3-3 | 4 |
| S4 | PA31 | H3-4 | 8 |
| S5 | PB20 | H3-8 | 16 |
| S6 | PB19 | H3-9 | 32 |
| S7 | PB18 | H3-10 | 64 |
| S8（最右） | PA7 | H3-11 | 128 |
| VCC | 3V3 | H3-19 | — |
| GND | GND | H3-20 | — |

以逐项直接测试为准：模块物理输出为白底低、黑线高，固件不取反，`M` 中 1 直接表示黑线。因此中心黑线压住 S4+S5 时 `M=24`；全部白色 `M=0`；全部黑色 `M=255`。如果移动黑线时位值左右方向相反，交换 S1～S8 的接线顺序，不要先改 PID。

## 4. D24A 控制信号

### 4.1 推荐且可靠：74HCT245/74AHCT245

D24A 两片 TB6612 的逻辑 VCC 是 5 V，MSPM0 输出是 3.3 V。正式落地运行需要一片 8 路、5 V 供电、输入兼容 3.3 V TTL 的 `74HCT245` 或 `74AHCT245`：

- 芯片/模块 `VCC -> D24A 5V`，绝不能接 12 V。
- `GND -> 公共 GND`。
- 设置方向为 MCU 输入侧到 D24A 输出侧。
- `/OE` 固定为低电平使能，不能悬空。
- HCT 每个输入建议用 10 kΩ 下拉到 GND，D24A `STBY` 节点再加一个 10 kΩ 下拉，确保复位和掉电切换时默认禁能。
- 下表 MCU 信号接转换器输入；转换器对应输出再接 D24A。

| 功能 | 地猛星 | 排针 | D24A 端，需并接 |
|---|---|---|---|
| 右侧 PWM | PA12 | H5-17 | J4-4 `PWMA` + J4-3 `PWMB` |
| 左侧 PWM | PA13 | H5-16 | J6-4 `PWMC` + J6-3 `PWMD` |
| 右侧方向信号1 | PA15 | H5-14 | J4-7 `BIN1` + J4-6 `AIN2` |
| 右侧方向信号2 | PA16 | H5-13 | J4-5 `BIN2` + J4-8 `AIN1` |
| 左侧方向信号1 | PA17 | H5-12 | J6-8 `CIN1` + J6-5 `DIN2` |
| 左侧方向信号2 | PA22 | H5-7 | J6-6 `CIN2` + J6-7 `DIN1` |
| 全局使能 | PB24 | H3-7 | J4-2 `STBY` |

D24A `J4-1 3V3`、编码器 E1～E4、`J6-1 ADC` 本轮都不接 MCU。

如果转换模块的端子名称不是 A1～A8/B1～B8、DIR、OE，先发正反面照片，不要按“高压侧/低压侧”的习惯猜接。

### 4.2 今晚没有 HCT 器件时的临时架空验证

3.3 V 直接进入 TB6612 的 5 V 逻辑输入不会造成输入过压，但低于数据手册保证的高电平阈值 3.5 V，可能不动作、抖动或受干扰。只有在四轮架空、有人随时断电、初次低速验证时，才可按上表临时省略转换器直接连接；此结果不能作为落地比赛的可靠接法。如果任一通道不响应，不要立即归因于代码。

## 5. 第一次架空测试

1. 只接按钮和灰度，D24A 仍关闭。Clean/Build/Debug/Resume 新固件。
2. 打开串口，移动黑线依次经过 S1～S8，确认 `M` 依次为 1、2、4、8、16、32、64、128。
3. 在 S4、S5 下放黑线，使 `M=24`。
4. 四轮架空，接通 D24A 12 V 并打开开关。
5. 按一次 PA24 按钮。四轮应低速向车辆前方转；PA14 会快速闪烁。
6. 立刻检查：A=右后、B=右前、C=左前、D=左后。
7. 再按一次按钮，四轮必须立即停止，PB24 回到约 0 V。

出现以下任一情况立即关闭 D24A：

- 同一侧前后轮方向相反；
- 左右侧方向相反导致原地旋转；
- 电机或驱动板异常发热、啸叫、复位；
- 按急停后仍有轮子转动。

若整侧反转，可交换该侧 IN1/IN2 的两根逻辑连接，或回报后修改 `car_config.h` 中对应的 `*_FORWARD_IN1_HIGH`。若同一侧两个轮子互相反转，需要调整错误电机的两根动力线，不能用共用方向信号解决。

本车首次架空结果为前轮 B/C 向前、后轮 A/D 向后。左右后轮互换位置不会改变电机自身极性。若不便交换 Motor A/D 的两根动力线，采用上表的交叉方向接法：前轮 B/C 保持 IN1/IN2 正常，后轮 A/D 的 IN1/IN2 反接。这样仍只占用四根 MCU 方向信号，并且前进、后退和短刹都保持一致。

根据首次观感，初始直行 PWM 已从 35% 降为 22%，最大限制暂降为 35%。空载架空时仍会显得比落地快；判断标准应以落地直线测试是否能及时修正为准，不能按空载转速直接调到很低。

## 6. 第一次落地循迹

1. 确认架空方向和急停通过后才落地。
2. 灰度探头离地先从约 8～12 mm 调起，并调电位器使黑线/白底切换稳定。
3. 先在 0.5～1 m 直线黑线上测试，不直接跑整圈。
4. 车头位于黑线上，按键启动；手始终靠近 D24A 电源开关。
5. 若车辆朝偏差相反方向修正，停止并回报“黑线移到左侧时车辆向哪边转”，不要盲目增大 PID。
6. 直线和单个半圆都能通过后，再跑完整一圈。

固件只有离开起点横线并运行超过 6 s 后，才会把“至少 6 路同时为黑”识别为返回 A 点。识别后短刹约 220 ms，再关闭 STBY，并通过串口输出最终毫秒时间。

## 7. CH340 串口

PA10/PA11 已在地猛星板上连接 CH340，不需要额外杜邦线：

1. 用支持数据的 Type-C 线连接地猛星和电脑。
2. 打开 Windows 设备管理器，展开“端口 (COM 和 LPT)”。
3. 找到 `USB-SERIAL CH340 (COMx)` 并记住 COMx。
4. CCS 中打开 `View -> Terminal`，新建 `Serial Terminal`。
5. 选择该 COMx，设置 `115200`、8 data bits、no parity、1 stop bit、no flow control。

当前电脑可见 COM3/COM4，但注册表显示它们属于 TI XDS110（VID 0451/PID BEF3），不能直接认定为板载 CH340。若接好地猛星 Type-C 后没有出现新的 CH340 COM 口，先换一条数据线并检查 CH340 驱动。

完整的桌面 USB/电池双电源与脱机供电接法见 [`POWER_AND_D24A_WIRING.md`](POWER_AND_D24A_WIRING.md)。特别注意：地猛星 Type-C VBUS 与板上 +5V 直接相连，电脑 USB 和 D24A 5V 不得同时送入地猛星。

主要输出：

```text
T=时间毫秒,S=状态,M=灰度位图,E=误差,L=左PWM,R=右PWM
```

状态值：0=待机，1=运行，2=制动，3=完成，4=故障。

## 8. 第一轮回报

```text
灰度逐通道 M 值：
S4+S5 时是否 M=24：
架空启动后 A/B/C/D 四轮方向：
再按按钮是否全部立即停止：
使用 HCT 转换 / 临时直连：
黑线在左侧时车辆实际修正方向：
黑线在右侧时车辆实际修正方向：
串口最终一段输出：
```
