how2idealizefreedom/electric-car-ball-balance/firmware/H2_地猛星_球平衡步进/A4988_WIRING_AND_TEST.md

# 地猛星 + 外接 D24A + A4988 安全验证

## 固件状态

- 默认 `A4988_BRINGUP_MODE=1`。
- D24A 的 STBY 始终为 0，四轮不会动作。
- A4988 上电后 EN 为高，驱动禁能。
- PA24 每按一次依次执行：`+20 微步`、`-20 微步`、`回到 0`、`禁能`。
- CH340 串口为 PA10/PA11、115200、8N1，每 500 ms 输出 `EN/POS/TARGET/HOME`。

## 地猛星信号接线

| 地猛星 | A4988 | 说明 |
|---|---|---|
| PA27 | STEP | 3.3 V 脉冲 |
| PA26 | DIR | 3.3 V 方向 |
| PA25 | ENABLE | 低有效；外加 10 kΩ 上拉到 3.3 V |
| PA9 | HOME | 预留常开限位开关，另一端接 GND |
| 3.3 V | VDD | A4988 逻辑电源 |
| GND | GND | 必须与 A4988、电池、D24A 共地 |

## A4988 功率侧

- 电池 12 V 正极接 VMOT，负极接 GND。
- VMOT 与 GND 在驱动板近端并联不低于 100 uF、耐压不低于 25 V 的电解电容。
- `RESET` 与 `SLEEP` 短接并上拉到 3.3 V。
- 首次固定为 1/8 微步：MS1=高、MS2=高、MS3=低。
- 用万用表先找出两组低阻线圈，分别接 1A/1B 和 2A/2B；不可依据线色猜测。
- 严禁带电插拔电机。

## 已确认的电机与限流

- 电机插头从左到右记为 `L1 L2 R1 R2`。
- 万用表已确认 `L1-L2≈4.1 Ω`、`R1-R2≈4.1 Ω`，因此：
  - `L1/L2` 接 A4988 的 `1A/1B`，同一组内部顺序任选；
  - `R1/R2` 接 `2A/2B`，同一组内部顺序任选。
- 若转向与机构定义相反，只交换其中一组线圈的两根线，必须断电后操作。
- 照片中两只采样电阻的丝印看起来为 `R100`，暂按 `Rs=0.10 Ω` 计算：
  - 0.50 A/相：VREF≈0.40 V；
  - 0.60 A/相：VREF≈0.48 V；
  - 0.70 A/相：VREF≈0.56 V；
  - 暂时不要超过 0.60 A/相，待带机构测试温升后再决定。
- 测 VREF：黑表笔接 GND，红表笔接电位器金属中心；使用绝缘小螺丝刀，避免滑动短路。
- 调整时电机必须从始至终保持未连接；调完后完全断电，等待电容放电，再接电机。

## HOME 的临时方案

现有四按键中的一个可以临时充当 HOME：一端接 PA9，另一端接 GND，固件内部上拉，按下为 `HOME=1`。测试时必须把按钮可靠固定，让机构只在低速接近时按到。普通轻触按键的机械重复性不适合最终比赛，正式版应换带滚轮/长柄的微动限位开关或霍尔传感器。

## 首次测试

1. 先不接 12 V，只给 MCU USB 供电；确认 PA25 对 GND 约 3.3 V。
2. 断电，接电机、100 uF 电容和共地；把机构与车轮架空。
3. 根据 A4988 模块采样电阻设 VREF，首次相电流只设约 0.6 A。
4. 上 12 V 后电机不应动作；串口应显示 `EN=0`。
5. 按一次 PA24，只允许出现很小的正向位移并停止；其后按键依次反向、回零、释放保持力。
6. 若只抖不转，立即断电并重新确认两组线圈；若芯片或电机迅速发烫，立即断电并降低限流。
