how2idealizefreedom/electric-car-ball-balance/firmware/H2_天猛星_球平衡步进/A4988_WIRING_AND_TEST.md

# 天猛星 + 外接 D24A + A4988 安全验证

## 固件状态

- 使用外接 D24A，不使用拓展板板载 TB6612。
- 默认 `A4988_BRINGUP_MODE=1`，D24A 始终禁能。
- 天猛星板载 PB21 每按一次依次执行：`+20 微步`、`-20 微步`、`回到 0`、`禁能`。
- CH340 串口 PA10/PA11、115200、8N1；MPU6050 的 PA0/PA1 配置保留。

## 天猛星信号接线

| 天猛星 | A4988 | 说明 |
|---|---|---|
| PA22 | STEP | 3.3 V 脉冲 |
| PA24 | DIR | 3.3 V 方向 |
| PA25 | ENABLE | 低有效；外加 10 kΩ 上拉到 3.3 V |
| PB8 | HOME | 预留常开限位开关，另一端接 GND |
| 3.3 V | VDD | A4988 逻辑电源 |
| GND | GND | 必须与 A4988、电池、D24A 共地 |

## 功率与测试

A4988 功率侧接法、100 uF 电容、RESET/SLEEP、1/8 微步、线圈配对、VREF 和测试顺序与地猛星工程相同。首次测试时不接舵机、不让车轮落地、不连接 K230 控制命令。

电机插头从左到右记为 `L1 L2 R1 R2`，已测得 `L1-L2≈4.1 Ω`、`R1-R2≈4.1 Ω`。前一组接 `1A/1B`，后一组接 `2A/2B`。照片中的采样电阻暂按 `R100=0.10 Ω` 处理，首次把 VREF 调至约 0.40 V（约 0.50 A/相），最多先试到 0.48 V（约 0.60 A/相）。

现有轻触按键可临时作为 HOME：PB8 与 GND 之间接一个按钮，按下时串口显示 `HOME=1`。它只适合台架标定，比赛正式版需要机械微动开关或霍尔零位传感器。
