how2idealizefreedom/electric-car-ball-balance/firmware/H2_TIANMENG_MEMORY_STEPPER/A4988_WIRING_AND_TEST.md

# 天猛星 + A4988 + 42BYGH23 安全接线

## 1. 逻辑与功率接线

| 天猛星/电源 | A4988 | 说明 |
|---|---|---|
| PA22 | STEP | 3.3 V 步进脉冲 |
| PA24 | DIR | 3.3 V 方向 |
| PA25 | ENABLE | 低有效；建议外加 10 kΩ 上拉到 3.3 V |
| PB8 | HOME | 常开零位开关，另一端接 GND；暂时不装可悬空 |
| 天猛星 3.3 V | VDD | 仅逻辑供电 |
| 公共 GND | 两个 GND | 天猛星、A4988、D24A、电池负极必须共地 |
| 12 V 电池 | VMOT | VMOT-GND 旁必须就近并联 ≥100 µF 电解电容 |

`RESET` 与 `SLEEP` 短接后接 VDD。首测采用 1/8 微步：MS1=高、MS2=高、MS3=低。

禁止带电插拔步进电机。调整线圈、插头或 A4988 模块前必须断开 12 V。

## 2. 电机线圈与限流

电机插头从左到右记为 `L1 L2 R1 R2`，已实测：

- `L1-L2 ≈ 4.1 Ω`，接 A4988 的 `1A/1B`。
- `R1-R2 ≈ 4.1 Ω`，接 A4988 的 `2A/2B`。

模块照片中的采样电阻按 `R100=0.10 Ω` 处理，参考公式为 `Imax=VREF/(8×Rs)`：

- VREF=0.40 V：约 0.50 A/相，作为首次台架值。
- VREF=0.48 V：约 0.60 A/相，仅在 0.50 A 力矩不足且驱动温度正常时尝试。

先断开电机、接通逻辑和 VMOT 测 VREF；调好后断电，再接电机。A4988 必须装散热片并留出通风。

## 3. 固件行为

车辆处于 WAIT/FINISHED/FAULT 时：

- K2：目标位置减 20 微步。
- K3：目标位置加 20 微步。
- K2、K3 同时按：立即禁用 A4988。
- HOME 被压下时，负方向运动在零位停止并把当前位置清零。

位置被软件限制在 ±400 微步。车辆按 K1 启动时，固件会先禁用 A4988，避免循迹阶段误动作。

没有 HOME 传感器时，上电位置只是假定的零点，不能用于最终摆杆绝对位置控制。比赛版至少需要一个机械微动或霍尔零位传感器。
