how2idealizefreedom/electric-car-ball-balance/firmware/H2_LINE_CAR0z/P2_FINAL_LAP_TEST.md

# H2 第二问比赛版测试流程

> 当前活动固件已按用户要求回退到 2026-07-29 22:44 左右实车验证成功的 P1 版本。本文中关于后续 V2/V3 转弯增强、终点武装字段 `A/W` 和全白启动拒绝的描述暂不适用于当前固件。

## 本版目标

- 按下 PA24 启动键后开始计时并顺时针循迹。
- 连续离开 A 点启停线 250 ms 后才武装终点检测。
- 返回 A 点、连续 15 ms 检测到横向宽黑线后立即短刹。
- 串口锁存并输出停车总时间，格式为 `STATE,FINISHED,T=xxxxx`。
- 内弯禁止车轮反转；大误差时允许内轮平滑降到 0、外轮提高到约 32%，避免此前内轮最低 9% 造成的转向不足。
- 短暂丢线时按最后误差方向以 `0/28%` 强差速找线，最多持续 800 ms；超时才进入故障停车。
- 实车弯道试验确认原转向极性相反，V3 已统一翻转有效循迹和丢线搜索方向。
- 按键启动时若八路灰度为全白 `M=0`，程序拒绝启动并输出 `EVENT,START_REJECT,NO_LINE`，不再原地搜索转圈。

## 车体基准点

首轮先在车体纵向中心轴上、八路灰度阵列中心 S4/S5 正上方贴一个临时测量标记。测试返回 A 时，测量该临时标记越过基准线的距离，这就是“识别加制动”的实际前移量。随后把正式唯一测试标记固定在灰度中心后方同样距离处。正式测试起步时用最终标记对齐 A 点基准虚线；返回时灰度阵列先检测启停线，制动结束后最终标记应落到基准线附近。

最终标记一旦确定，后续所有起点和停车偏差都只使用该标记，不再更换。

## 第一次落地测试

1. 暂不安装钢球，摆杆固定在不会摆动的位置；电池充足。
2. 把车放在 A 点，车头指向 B，基准标记对准 A 点虚线。
3. 打开串口 115200、8N1，清空窗口并录像。
4. 按一次启动键，手保持在急停键附近，但不要在正常行驶时干预。
5. 记录总时间、是否完整一圈、内弯是否连续、停车偏差和偏差方向。

## 必须回传的数据

- `EVENT,LAP_ARMED,T=...`
- 返回 A 点前后约 1 秒的全部 `T,S,M,E,L,R,A,W` 行。
- `STATE,BRAKE,T=...` 和 `STATE,FINISHED,T=...`
- 总时间以及停车有符号偏差：越过基准线记正值，未到记负值，单位 cm。
- 一段能看到至少一个半圆弯和最终停车的视频。

## 验收顺序

1. 连续完成一圈且不丢线。
2. 连续 10 次没有提前停车或漏停。
3. 连续 10 次停车绝对偏差不超过 2 cm。
4. 再逐步提高直线速度，将总时间稳定压到 18 s 以下，给 20 s 指标留余量。

当前串口时间可用于算法验收，但正式比赛还必须安装不大于 2 英寸的车载显示屏，并在启动后实时显示、停车后锁存总时间。
