how2idealizefreedom/electric-car-ball-balance/hardware/天猛星拓展板/天猛星拓展板/天猛星拓展板原理图.pdf

八路循迹 | TB6612
蜂鸣器 | 按键/led

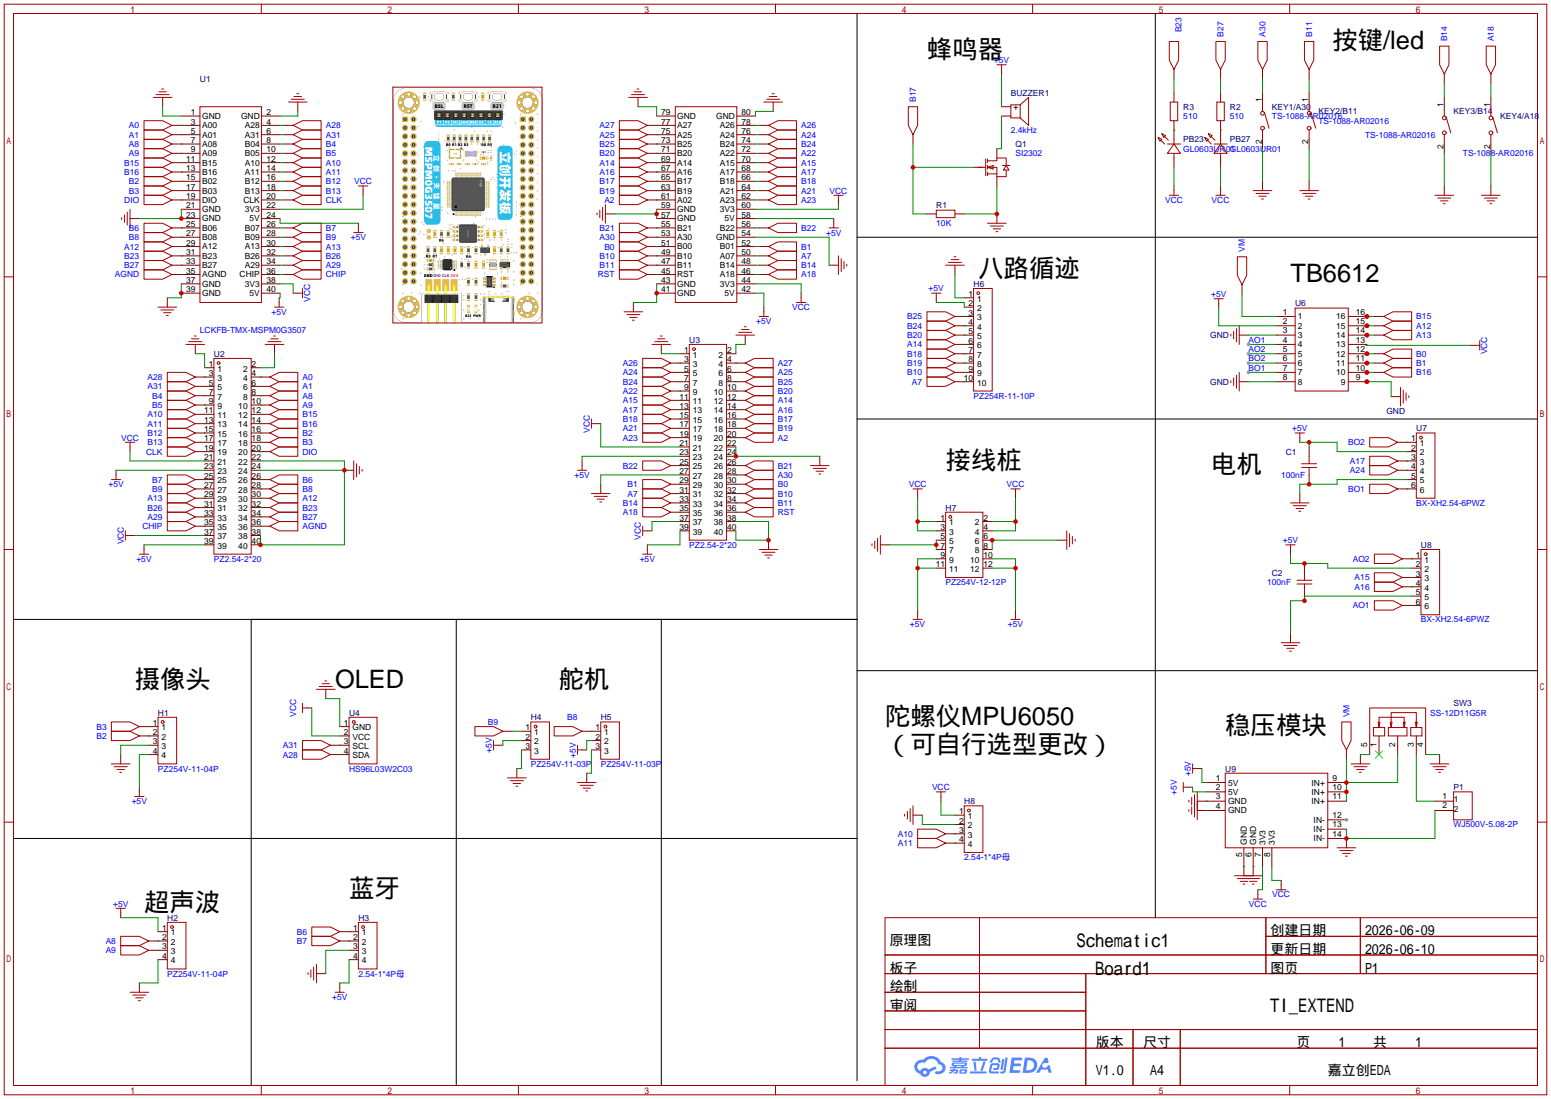
[picture p98: page 1]

VCC VCC 10 10

陀螺仪MPU6050 VCC 3 A10 3 4 A11 4 2.54-1*4P母 | | 稳压模块 （可自行选型更改）

原理图 | Schematic1 | 创建日期 | 2026-06-09

更新日期 | 2026-06-10

板子 | Board1 | 图页 | P1
绘制 | | TI_EXTEND
审阅

V1.0 | A4 | 嘉立创EDA
