how2idealizefreedom/electric-car-ball-balance/hardware/WHEELTEC R1系列底盘客户资料/WHEELTEC R1系列底盘客户资料_2026.05.27/1.孔位说明与孔位图纸/R1四驱小车板件孔位【孔位图】.pdf

# 四驱车底盘安装孔位

# 四驱车底盘安装孔位

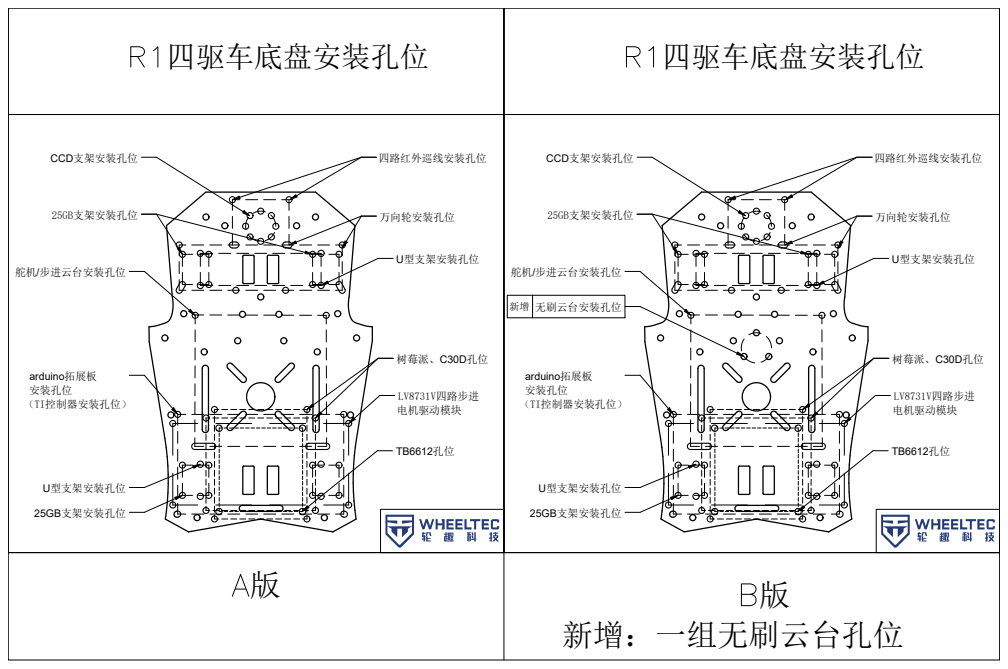
[picture p99: page 1]
CCD支架安装孔位; 25GB支架安装孔位; 万向轮安装孔位; 树莓派、C30D孔位; arduino拓展板 安装孔位; （TI控制器安装孔位）; LV8731V四路步进; 电机驱动模块; U型支架安装孔位; 舵机/步进云台安装孔位; 无刷云台安装孔位; 新增：一组无刷云台孔位; 四路红外巡线安装孔位
