how2idealizefreedom/electric-car-ball-balance/hardware/WHEELTEC R1系列底盘客户资料/WHEELTEC R1系列底盘客户资料_2026.05.27/1.孔位说明与孔位图纸/R1差速小车板件孔位【孔位图】.pdf

# 三轮车/四轮两驱底盘安装孔位

# 三轮车/四轮两驱底盘安装孔位

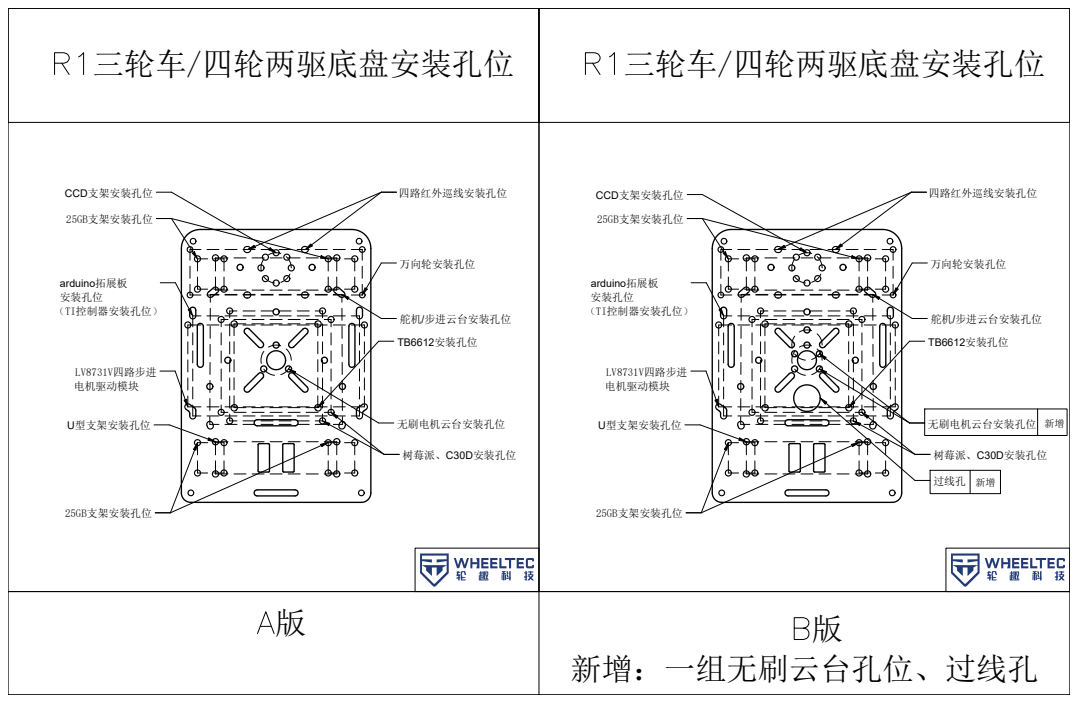
[picture p100: page 1]
25GB支架安装孔位; U型支架安装孔位; 树莓派、C30D安装孔位; TB6612安装孔位; arduino拓展板 安装孔位 （TI控制器安装孔位）; LV8731V四路步进 电机驱动模块; 万向轮安装孔位; CCD支架安装孔位; 舵机/步进云台安装孔位; 无刷电机云台安装孔位; 过线孔; 四路红外巡线安装孔位

新增：一组无刷云台孔位、过线孔
