how2idealizefreedom/electric-car-ball-balance/hardware/【WHEELTEC】TB6612电机驱动附送资料/【WHEELTEC】TB6612电机驱动附送资料_V3.2_2026.07.25/4.例程源码/1.STM32F1例程/3.D24A（四路驱动带稳压版）例程/D24Ademo(霍尔编码器)2025.7.8/D24Ademo(霍尔编码器)/HAREWER/ENCODER/encoder.c

#include "encoder.h"
#include "stm32f10x_gpio.h"

/*******************************************************
Function:Initialize TIM1 to encoder interface mode
Input   ;none
Output  :none
函数    ：把TIM1初始化为编码器接口模式
入口参数：无
返回值  ：无
********************************************************/
void Encoder_Init_Tim8(void)
{
	TIM_TimeBaseInitTypeDef TIM_TimeBaseStructure;  
  TIM_ICInitTypeDef TIM_ICInitStructure;  
  GPIO_InitTypeDef GPIO_InitStructure;
  RCC_APB2PeriphClockCmd(RCC_APB2Periph_TIM8, ENABLE);//使能定时器4的时钟
  RCC_APB2PeriphClockCmd(RCC_APB2Periph_GPIOC, ENABLE);//使能PB端口时钟
	
	
  GPIO_InitStructure.GPIO_Pin = GPIO_Pin_6|GPIO_Pin_7;	//端口配置
  GPIO_InitStructure.GPIO_Mode = GPIO_Mode_IN_FLOATING; //浮空输入
  GPIO_Init(GPIOC, &GPIO_InitStructure);					      //根据设定参数初始化GPIOA
  
  TIM_TimeBaseStructInit(&TIM_TimeBaseStructure);
  TIM_TimeBaseStructure.TIM_Prescaler = 0x0; // 预分频器 
  TIM_TimeBaseStructure.TIM_Period = 65535; //设定计数器自动重装值
  TIM_TimeBaseStructure.TIM_ClockDivision = TIM_CKD_DIV1;//选择时钟分频：不分频
  TIM_TimeBaseStructure.TIM_CounterMode = TIM_CounterMode_Up;////TIM向上计数  
  TIM_TimeBaseInit(TIM8, &TIM_TimeBaseStructure);
  TIM_EncoderInterfaceConfig(TIM8, TIM_EncoderMode_TI12, TIM_ICPolarity_Rising, TIM_ICPolarity_Rising);//使用编码器模式3
  TIM_ICStructInit(&TIM_ICInitStructure);
  TIM_ICInitStructure.TIM_ICFilter = 10;	//滤波10
  TIM_ICInit(TIM8, &TIM_ICInitStructure);
  TIM_ClearFlag(TIM8, TIM_FLAG_Update);//清除TIM的更新标志位
  TIM_ITConfig(TIM8, TIM_IT_Update, ENABLE);
  //Reset counter
  TIM_SetCounter(TIM8,0);
  TIM_Cmd(TIM8, ENABLE); 
}

/*******************************************************
Function:Initialize TIM2 to encoder interface mode
Input   ;none
Output  :none
函数    ：把TIM2初始化为编码器接口模式
入口参数：无
返回值  ：无
********************************************************/
void Encoder_Init_Tim2(void)
{
	TIM_TimeBaseInitTypeDef TIM_TimeBaseStructure;  
  TIM_ICInitTypeDef TIM_ICInitStructure;  
  GPIO_InitTypeDef GPIO_InitStructure;
  RCC_APB1PeriphClockCmd(RCC_APB1Periph_TIM2, ENABLE);//使能定时器4的时钟
  RCC_APB2PeriphClockCmd(RCC_APB2Periph_GPIOA|RCC_APB2Periph_AFIO, ENABLE);//使能PB端口时钟
	
  GPIO_PinRemapConfig(GPIO_FullRemap_TIM2,ENABLE);
  GPIO_PinRemapConfig(GPIO_Remap_SWJ_Disable,ENABLE);
	
  GPIO_InitStructure.GPIO_Pin = GPIO_Pin_15;	//端口配置
  GPIO_InitStructure.GPIO_Mode = GPIO_Mode_IN_FLOATING; //浮空输入
  GPIO_Init(GPIOA, &GPIO_InitStructure);					      //根据设定参数初始化GPIOB
	
  GPIO_InitStructure.GPIO_Pin =GPIO_Pin_3;
  GPIO_InitStructure.GPIO_Mode = GPIO_Mode_IN_FLOATING;
  GPIO_Init(GPIOB,&GPIO_InitStructure);
  
  TIM_TimeBaseStructInit(&TIM_TimeBaseStructure);
  TIM_TimeBaseStructure.TIM_Prescaler = 0x0; // 预分频器 
  TIM_TimeBaseStructure.TIM_Period = 65535; //设定计数器自动重装值
  TIM_TimeBaseStructure.TIM_ClockDivision = TIM_CKD_DIV1;//选择时钟分频：不分频
  TIM_TimeBaseStructure.TIM_CounterMode = TIM_CounterMode_Up;////TIM向上计数  
  TIM_TimeBaseInit(TIM2, &TIM_TimeBaseStructure);
  TIM_EncoderInterfaceConfig(TIM2, TIM_EncoderMode_TI12, TIM_ICPolarity_Rising, TIM_ICPolarity_Rising);//使用编码器模式3
  TIM_ICStructInit(&TIM_ICInitStructure);
  TIM_ICInitStructure.TIM_ICFilter = 10;	//滤波10
  TIM_ICInit(TIM2, &TIM_ICInitStructure);
  TIM_ClearFlag(TIM2, TIM_FLAG_Update);//清除TIM的更新标志位
  TIM_ITConfig(TIM2, TIM_IT_Update, ENABLE);
  //Reset counter
  TIM_SetCounter(TIM2,0);
  TIM_Cmd(TIM2, ENABLE); 
}

/*******************************************************
Function:Initialize TIM2 to encoder interface mode
Input   ;none
Output  :none
函数    ：把TIM2初始化为编码器接口模式
入口参数：无
返回值  ：无
********************************************************/
void Encoder_Init_Tim3(void)
{
	TIM_TimeBaseInitTypeDef TIM_TimeBaseStructure;  
  TIM_ICInitTypeDef TIM_ICInitStructure;  
  GPIO_InitTypeDef GPIO_InitStructure;
  RCC_APB1PeriphClockCmd(RCC_APB1Periph_TIM3, ENABLE);//使能定时器3的时钟
  RCC_APB2PeriphClockCmd(RCC_APB2Periph_GPIOA, ENABLE);//使能PB端口时钟
	
  GPIO_InitStructure.GPIO_Pin = GPIO_Pin_6|GPIO_Pin_7;	//端口配置
  GPIO_InitStructure.GPIO_Mode = GPIO_Mode_IN_FLOATING; //浮空输入
  GPIO_Init(GPIOA, &GPIO_InitStructure);					      //根据设定参数初始化GPIOB	
  
  TIM_TimeBaseStructInit(&TIM_TimeBaseStructure);
  TIM_TimeBaseStructure.TIM_Prescaler = 0x0; // 预分频器 
  TIM_TimeBaseStructure.TIM_Period = 65535; //设定计数器自动重装值
  TIM_TimeBaseStructure.TIM_ClockDivision = TIM_CKD_DIV1;//选择时钟分频：不分频
  TIM_TimeBaseStructure.TIM_CounterMode = TIM_CounterMode_Up;////TIM向上计数  
  TIM_TimeBaseInit(TIM3, &TIM_TimeBaseStructure);
  TIM_EncoderInterfaceConfig(TIM3, TIM_EncoderMode_TI12, TIM_ICPolarity_Rising, TIM_ICPolarity_Rising);//使用编码器模式3
  TIM_ICStructInit(&TIM_ICInitStructure);
  TIM_ICInitStructure.TIM_ICFilter = 10;	//滤波10
  TIM_ICInit(TIM3, &TIM_ICInitStructure);
  TIM_ClearFlag(TIM3, TIM_FLAG_Update);//清除TIM的更新标志位
  TIM_ITConfig(TIM3, TIM_IT_Update, ENABLE);
  //Reset counter
  TIM_SetCounter(TIM3,0);
  TIM_Cmd(TIM3, ENABLE); 
}

/**************************************************************************
Function: Initialize TIM4 to encoder interface mode
Input   : none
Output  : none
函数功能：把TIM4初始化为编码器接口模式
入口参数：无
返回  值：无
**************************************************************************/
void Encoder_Init_Tim4(void)
{
	TIM_TimeBaseInitTypeDef TIM_TimeBaseStructure;  
  TIM_ICInitTypeDef TIM_ICInitStructure;  
  GPIO_InitTypeDef GPIO_InitStructure;
  RCC_APB1PeriphClockCmd(RCC_APB1Periph_TIM4, ENABLE);//使能定时器4的时钟
  RCC_APB2PeriphClockCmd(RCC_APB2Periph_GPIOB, ENABLE);//使能PB端口时钟
	
  GPIO_InitStructure.GPIO_Pin = GPIO_Pin_6|GPIO_Pin_7;	//端口配置
  GPIO_InitStructure.GPIO_Mode = GPIO_Mode_IN_FLOATING; //浮空输入
  GPIO_Init(GPIOB, &GPIO_InitStructure);					      //根据设定参数初始化GPIOB
  
  TIM_TimeBaseStructInit(&TIM_TimeBaseStructure);
  TIM_TimeBaseStructure.TIM_Prescaler = 0x0; // 预分频器 
  TIM_TimeBaseStructure.TIM_Period = 65535; //设定计数器自动重装值
  TIM_TimeBaseStructure.TIM_ClockDivision = TIM_CKD_DIV1;//选择时钟分频：不分频
  TIM_TimeBaseStructure.TIM_CounterMode = TIM_CounterMode_Up;////TIM向上计数  
  TIM_TimeBaseInit(TIM4, &TIM_TimeBaseStructure);
  TIM_EncoderInterfaceConfig(TIM4, TIM_EncoderMode_TI12, TIM_ICPolarity_Rising, TIM_ICPolarity_Rising);//使用编码器模式3
  TIM_ICStructInit(&TIM_ICInitStructure);
  TIM_ICInitStructure.TIM_ICFilter = 10;
  TIM_ICInit(TIM4, &TIM_ICInitStructure);
  TIM_ClearFlag(TIM4, TIM_FLAG_Update);//清除TIM的更新标志位
  TIM_ITConfig(TIM4, TIM_IT_Update, ENABLE);
  //Reset counter
  TIM_SetCounter(TIM4,0);
  TIM_Cmd(TIM4, ENABLE); 
}


/**************************************************************************
Function: Read encoder count per unit time
Input   : TIMX：Timer
Output  : none
函数功能：单位时间读取编码器计数
入口参数：TIMX：定时器
返回  值：速度值
**************************************************************************/
int Read_Encoder(u8 TIMX)
{
   int Encoder_TIM;    
   switch(TIMX)
	 {
	   case 8:  Encoder_TIM= (short)TIM8 -> CNT;  TIM8 -> CNT=0;break;
	   case 2:  Encoder_TIM= (short)TIM2 -> CNT;  TIM2 -> CNT=0;break;	
	   case 3:  Encoder_TIM= (short)TIM3 -> CNT;  TIM3 -> CNT=0;break;
	   case 4:  Encoder_TIM= (short)TIM4 -> CNT;  TIM4 -> CNT=0;break;	
	   default: Encoder_TIM=0;
	 }
	 //if(Encoder_TIM<0)  Encoder_TIM=-Encoder_TIM;
		return Encoder_TIM;
}
/**************************************************************************
Function: TIM4 interrupt service function
Input   : none
Output  : none
函数功能：TIM4中断服务函数
入口参数：无
返回  值：无
**************************************************************************/
void TIM4_IRQHandler(void)
{ 		    		  			    
	if(TIM4->SR&0X0001)//溢出中断
	{    				   				     	    	
	}				   
	TIM4->SR&=~(1<<0);//清除中断标志位 	    
}
/**************************************************************************
Function: TIM1 interrupt service function
Input   : none
Output  : none
函数功能：TIM1中断服务函数
入口参数：无
返回  值：无
**************************************************************************/
void TIM8_IRQHandler(void)
{ 		    		  			    
	if(TIM8->SR&0X0001)//溢出中断
	{    				   				     	    	
	}				   
	TIM8->SR&=~(1<<0);//清除中断标志位 	    
}
/**************************************************************************
Function: TIM3 interrupt service function
Input   : none
Output  : none
函数功能：TIM3中断服务函数
入口参数：无
返回  值：无
**************************************************************************/
void TIM3_IRQHandler(void)
{ 		    		  			    
	if(TIM3->SR&0X0001)//溢出中断
	{    				   				     	    	
	}				   
	TIM3->SR&=~(1<<0);//清除中断标志位 	    
}
/**************************************************************************
Function: TIM2 interrupt service function
Input   : none
Output  : none
函数功能：TIM2中断服务函数
入口参数：无
返回  值：无
**************************************************************************/
void TIM2_IRQHandler(void)
{ 		    		  			    
	if(TIM2->SR&0X0001)//溢出中断
	{    				   				     	    	
	}				   
	TIM2->SR&=~(1<<0);//清除中断标志位 	    
}
