how2idealizefreedom/electric-car-ball-balance/firmware/10_DC_MOTOR_PID_1/user_driver/motor.c

#include "motor.h"

void motor_init(uint8_t motor_id)
{
    DL_GPIO_setPins(DC_MOTOR_STBY_PORT, DC_MOTOR_STBY_PIN);
    if(motor_id == 1){
        DL_Timer_startCounter(PWMA_INST);
        DL_GPIO_setPins(DC_MOTOR_AIN1_PORT, DC_MOTOR_AIN1_PIN);
        DL_GPIO_setPins(DC_MOTOR_AIN2_PORT, DC_MOTOR_AIN2_PIN);
        DL_Timer_setCaptureCompareValue(PWMA_INST, 0, GPIO_PWMA_C0_IDX);
    }
    else if(motor_id == 2){
        // DL_GPIO_setPins(DC_MOTOR_BIN1_PORT, DC_MOTOR_BIN1_PIN);
        // DL_GPIO_setPins(DC_MOTOR_BIN2_PORT, DC_MOTOR_BIN2_PIN);
    }
}

void motor_set_duty(uint8_t motor_id, uint32_t duty)
{
    if(duty > 4000){
        duty = 4000;
    }
    if(motor_id == 1){
        DL_Timer_setCaptureCompareValue(PWMA_INST, duty, GPIO_PWMA_C0_IDX);
    }
    else if(motor_id == 2){
        // DL_Timer_setCaptureCompareValue(PWMB_INST, speed, GPIO_PWMB_C0_IDX);
    }
}

// direction: 0 停止，1 正转，2 反转
void motor_set_direction(uint8_t motor_id, uint8_t direction)
{
    if(motor_id == 1){
        if(direction == 0){
            DL_GPIO_setPins(DC_MOTOR_AIN1_PORT, DC_MOTOR_AIN1_PIN);
            DL_GPIO_setPins(DC_MOTOR_AIN2_PORT, DC_MOTOR_AIN2_PIN);
        }
        else if(direction == 1){
            DL_GPIO_setPins(DC_MOTOR_AIN1_PORT, DC_MOTOR_AIN1_PIN);
            DL_GPIO_clearPins(DC_MOTOR_AIN2_PORT, DC_MOTOR_AIN2_PIN);
        }
        else if(direction == 2){
            DL_GPIO_clearPins(DC_MOTOR_AIN1_PORT, DC_MOTOR_AIN1_PIN);
            DL_GPIO_setPins(DC_MOTOR_AIN2_PORT, DC_MOTOR_AIN2_PIN);
        }
    }
    else if(motor_id == 2){
        // if(direction == 0){
        //     DL_GPIO_setPins(DC_MOTOR_BIN1_PORT, DC_MOTOR_BIN1_PIN);
        //     DL_GPIO_setPins(DC_MOTOR_BIN2_PORT, DC_MOTOR_BIN2_PIN);
        // }
        // else if(direction == 1){
        //     DL_GPIO_setPins(DC_MOTOR_BIN1_PORT, DC_MOTOR_BIN1_PIN);
        //     DL_GPIO_clearPins(DC_MOTOR_BIN2_PORT, DC_MOTOR_BIN2_PIN);
        // }
        // else if(direction == 2){
        //     DL_GPIO_clearPins(DC_MOTOR_BIN1_PORT, DC_MOTOR_BIN1_PIN);
        //     DL_GPIO_setPins(DC_MOTOR_BIN2_PORT, DC_MOTOR_BIN2_PIN);
        // }
    }
}
