how2idealizefreedom/electric-car-ball-balance/hardware/【WHEELTEC】TB6612电机驱动附送资料/【WHEELTEC】TB6612电机驱动附送资料_V3.2_2026.07.25/4.例程源码/1.STM32F1例程/3.D24A（四路驱动带稳压版）例程/D24Ademo(霍尔编码器)2025.7.8/D24Ademo(霍尔编码器)/HAREWER/ENCODER/encoder.h

#ifndef _ENCODER_H
#define _ENCODER_H

#include "stm32f10x.h"

void Encoder_Init_Tim2(void);
void Encoder_Init_Tim4(void);
int Read_Encoder(u8 TIMX);
void Encoder_Init_Tim3(void);
void Encoder_Init_Tim8(void);
#endif
