how2idealizefreedom/electric-car-ball-balance/firmware/10_DC_MOTOR_PID_1/user_driver/motor.h

#ifndef MOTOR_H
#define MOTOR_H

// G3507      TB6612
// PB24 <--> STBY
// PA8 <--> AIN1
// PA9 <--> AIN2
// PA12 <--> PWMA
// GND <--> GND
// 3V3 <--> VCC

// TB6612    电源模块
// VM          7.4V
// GND         GND

// TB6612    直流电机1
// AO1<--> M+
// AO2<--> M-

// G3507    直流电机1
// PA17 <--> A
// PA18 <--> B
// 3V3 <--> VCC
// GND <--> GND

// 

// 所有的GND都需要连接在一起

#include "ti_msp_dl_config.h"

void motor_init(uint8_t motor_id);
void motor_set_duty(uint8_t motor_id, uint32_t duty);
void motor_set_direction(uint8_t motor_id, uint8_t direction);

#endif // MOTOR_H
