how2idealizefreedom/electric-car-ball-balance/hardware/【WHEELTEC】TB6612电机驱动附送资料/【WHEELTEC】TB6612电机驱动附送资料_V3.2_2026.07.25/4.例程源码/1.STM32F1例程/3.D24A（四路驱动带稳压版）例程/D24Ademo(霍尔编码器)2025.7.8/D24Ademo(霍尔编码器)/HAREWER/GPIO/gpio.c

#include "gpio.h"

void Gpio_Init(void)
{
	GPIO_InitTypeDef GPIO_InitStructure;            //定义结构体GPIO_InitStructure
		
	RCC_APB2PeriphClockCmd(RCC_APB2Periph_GPIOB|RCC_APB2Periph_GPIOC, ENABLE); // 使能PB端口时钟  
	GPIO_InitStructure.GPIO_Pin =  GPIO_Pin_0|GPIO_Pin_1|GPIO_Pin_12| GPIO_Pin_13;	  
	GPIO_InitStructure.GPIO_Mode = GPIO_Mode_Out_PP;     	//推挽，增大电流输出能力  
	GPIO_InitStructure.GPIO_Speed = GPIO_Speed_50MHz;  //IO口速度
	GPIO_Init(GPIOB, &GPIO_InitStructure);          //GBIOB初始化  
	
	GPIO_InitStructure.GPIO_Pin = GPIO_Pin_1|GPIO_Pin_2|GPIO_Pin_13|GPIO_Pin_14; 
	GPIO_InitStructure.GPIO_Mode = GPIO_Mode_Out_PP;     	//推挽，增大电流输出能力  
	GPIO_InitStructure.GPIO_Speed = GPIO_Speed_50MHz;  //IO口速度
	GPIO_Init(GPIOC, &GPIO_InitStructure);          //GBIOB初始化  
 
}
 
