how2idealizefreedom/electric-car-ball-balance/hardware/【WHEELTEC】TB6612电机驱动附送资料/【WHEELTEC】TB6612电机驱动附送资料_V3.2_2026.07.25/4.例程源码/1.STM32F1例程/3.D24A（四路驱动带稳压版）例程/D24Ademo(霍尔编码器)2025.7.8/D24Ademo(霍尔编码器)/HAREWER/MOTO/moto.h

#ifndef __MOTO_H
#define	__MOTO_H

#include "stm32f10x.h"

void moto(int mode);
int Velocity_A(int TargetVelocity, int CurrentVelocity);
int Velocity_B(int TargetVelocity, int CurrentVelocity);
int Velocity_C(int TargetVelocity, int CurrentVelocity);
int Velocity_D(int TargetVelocity, int CurrentVelocity);
#endif
