how2idealizefreedom/electric-car-ball-balance/(commit log)

2026-10-09 Initial commit: 2026 电赛H题 水平小球平衡小车项目
2026-10-09 并入 Codex 开发的多平台固件工程与开发文档，补充设计报告与 README
2026-10-09 按内容重命名 firmware 工程（中文目录树），修正地猛星/天猛星命名，添加 MIT LICENSE
2026-10-12 整理仓库：删除重复备份与构建产物，重写 README 与技术文档
